stefanodemartini/RazorGauge/scheda_sensore/RazorSensor_BOM.csv

Rif | Valore | Footprint | Codice / note | LCSC
U1 | TSL1401CL | TSL1401CL_ams_CL | ams TSL1401CL (128x1, package CL, MSL 5a da datasheet) | C2802316
C1 | 100nF | C_0603_1608Metric | CC0603KRX7R9BB104 50V | C14663
C2 | 10uF | C_0805_2012Metric | CL21A106KAYNNNE 25V | C15850
R1 | 100 | R_0603_1608Metric | 0603WAF1000T5E | C22775
R2 | 100 | R_0603_1608Metric | 0603WAF1000T5E | C22775
R3 | 330 | R_0603_1608Metric | 0603WAF3300T5E | C23138
U2 | LMV321 | SOT-23-5 | TI LMV321IDBVR (rail-to-rail out, 1 MHz) | C7972
C4 | 100nF | C_0603_1608Metric | CC0603KRX7R9BB104 50V | C14663
R4 | 10k | R_0603_1608Metric | 0603WAF1002T5E | C25804
R5 | 100k | R_0603_1608Metric | 0603WAF1003T5E | C25803
R6 | 4.7k | R_0603_1608Metric | 0603WAF4701T5E | C23162
C3 | 100nF | C_0603_1608Metric | CC0603KRX7R9BB104 50V | C14663
R7 | 4.7k | R_0603_1608Metric | 0603WAF4701T5E | C23162
R8 | 10k | R_0603_1608Metric | 0603WAF1002T5E | C25804
R9 | 10k | R_0603_1608Metric | 0603WAF1002T5E | C25804
R10 | 100 | R_0603_1608Metric | 0603WAF1000T5E | C22775
J1 | GH 6p | JST_GH_SM06B-GHS-TB_1x06-1MP_P1.25mm_Horizontal | JST SM06B-GHS-TB(LF)(SN) - cavo: 1 3V3 / 2 GND / 3 SI / 4 CLK / 5 AO / 6 calza (= J5 pin 1-5, 8) | C133065
