stefanodemartini/RazorGauge/scheda_smd/RazorBoard_SMD_BOM.csv

Rif | Valore | Footprint | Codice / note | LCSC | Montaggio
J1 | 24V IN | TerminalBlock_Phoenix_MKDS-1,5-2-5.08_1x02_P5.08mm_Horizontal |  |  | a mano (THT)
F1 | PTC 0.5A 30V | Fuse_1812_4532Metric | SMD1812P050TF/30 (hold 0.5A, trip 1A) | C12559 | fabbrica (SMT)
D1 | SS34 | D_SMA | SS34 3A 40V | C8678 | fabbrica (SMT)
D2 | SMBJ33CA | D_SMB | SMBJ33CA | C492017 | fabbrica (SMT)
C1 | 10uF 50V | C_1206_3216Metric | CL31A106KBHNNNE | C13585 | fabbrica (SMT)
C2 | 100nF | C_0603_1608Metric | CC0603KRX7R9BB104 50V | C14663 | fabbrica (SMT)
U1 | TSR 2-2450 | Converter_DCDC_TRACO_TSR-1_THT | Traco TSR 2-2450 (5V 2A) |  | a mano (THT)
C3 | 10uF 25V | C_0805_2012Metric | CL21A106KAYNNNE | C15850 | fabbrica (SMT)
J2 | 5V EXT | TerminalBlock_Phoenix_MKDS-1,5-2-5.08_1x02_P5.08mm_Horizontal |  |  | a mano (THT)
JP1 | SEL 5V | PinHeader_1x03_P2.54mm_Vertical | Header 3 pin + jumper (1-2 = convertitore interno, 2-3 = 5V esterno) |  | a mano (THT)
C4 | 10uF 25V | C_0805_2012Metric | CL21A106KAYNNNE | C15850 | fabbrica (SMT)
C17 | 10uF 25V | C_0805_2012Metric | CL21A106KAYNNNE | C15850 | fabbrica (SMT)
C5 | 100nF | C_0603_1608Metric | CC0603KRX7R9BB104 50V | C14663 | fabbrica (SMT)
R1 | 1k | R_0603_1608Metric | 0603WAF1001T5E | C21190 | fabbrica (SMT)
D3 | PWR verde | LED_0603_1608Metric | KT-0603G | C12624 | fabbrica (SMT)
D4 | B5819W | D_SOD-123 | B5819W SL (blocca ritorno da USB master) | C8598 | fabbrica (SMT)
D5 | B5819W | D_SOD-123 | B5819W SL (blocca ritorno da USB slave) | C8598 | fabbrica (SMT)
A1 | MASTER ESP32 DevKit V1 30p | ESP32_DevKitV1_30p_W25.4 | 2x zoccolo femmina 1x15 passo 2.54, file a 25.4 mm |  | a mano (THT)
A2 | SLAVE ESP32 DevKit V1 30p | ESP32_DevKitV1_30p_W25.4 | 2x zoccolo femmina 1x15 passo 2.54, file a 25.4 mm |  | a mano (THT)
R10 | 470 | R_0603_1608Metric | 0603WAF4700T5E | C23179 | fabbrica (SMT)
R11 | 470 | R_0603_1608Metric | 0603WAF4700T5E | C23179 | fabbrica (SMT)
J7 | UART DEBUG | PinHeader_1x03_P2.54mm_Vertical |  |  | a mano (THT)
J4 | ENCODER | TerminalBlock_Phoenix_MKDS-1,5-5-5.08_1x05_P5.08mm_Horizontal | rosso +5V, nero GND, verde A, bianco B, calza GND |  | a mano (THT)
R30 | 4.7k | R_0603_1608Metric | 0603WAF4701T5E | C23162 | fabbrica (SMT)
R31 | 4.7k | R_0603_1608Metric | 0603WAF4701T5E | C23162 | fabbrica (SMT)
R32 | 1k | R_0603_1608Metric | 0603WAF1001T5E | C21190 | fabbrica (SMT)
R33 | 1k | R_0603_1608Metric | 0603WAF1001T5E | C21190 | fabbrica (SMT)
C7 | 10nF | C_0603_1608Metric | 0603B103K500NT 50V | C57112 | fabbrica (SMT)
C8 | 10nF | C_0603_1608Metric | 0603B103K500NT 50V | C57112 | fabbrica (SMT)
U3 | 74HC14 | SOIC-14_3.9x8.7mm_P1.27mm | 74HC14D,653 (a 3.3V, doppia inversione) | C5605 | fabbrica (SMT)
C9 | 100nF | C_0603_1608Metric | CC0603KRX7R9BB104 50V | C14663 | fabbrica (SMT)
R20 | 10k | R_0603_1608Metric | 0603WAF1002T5E | C25804 | fabbrica (SMT)
R21 | 10k | R_0603_1608Metric | 0603WAF1002T5E | C25804 | fabbrica (SMT)
R22 | 10k | R_0603_1608Metric | 0603WAF1002T5E | C25804 | fabbrica (SMT)
U4 | 74HCT245 | SOIC-20W_7.5x12.8mm_P1.27mm | 74HCT245D,653 (ingressi TTL, uscite 5V) | C5979 | fabbrica (SMT)
C6 | 100nF | C_0603_1608Metric | CC0603KRX7R9BB104 50V | C14663 | fabbrica (SMT)
R23 | 100 | R_0603_1608Metric | 0603WAF1000T5E | C22775 | fabbrica (SMT)
R24 | 100 | R_0603_1608Metric | 0603WAF1000T5E | C22775 | fabbrica (SMT)
R25 | 100 | R_0603_1608Metric | 0603WAF1000T5E | C22775 | fabbrica (SMT)
R26 | 1k | R_0603_1608Metric | 0603WAF1001T5E | C21190 | fabbrica (SMT)
D6 | PUL giallo | LED_0603_1608Metric | KT-0603Y | C2287 | fabbrica (SMT)
R27 | 1k | R_0603_1608Metric | 0603WAF1001T5E | C21190 | fabbrica (SMT)
D7 | DIR giallo | LED_0603_1608Metric | KT-0603Y | C2287 | fabbrica (SMT)
R28 | 1k | R_0603_1608Metric | 0603WAF1001T5E | C21190 | fabbrica (SMT)
D8 | ENA rosso | LED_0603_1608Metric | KT-0603R | C2286 | fabbrica (SMT)
J3 | TB6600 | TerminalBlock_Phoenix_MKDS-1,5-5-5.08_1x05_P5.08mm_Horizontal | PUL->PUL+, DIR->DIR+, ENA->ENA+, GND->PUL-/DIR-/ENA-, +5V solo per anodo comune |  | a mano (THT)
J5 | RAZORGAUGE | TerminalBlock_Phoenix_MKDS-1,5-8-5.08_1x08_P5.08mm_Horizontal | cavo schermato max 50 cm, calza al pin 8 |  | a mano (THT)
R40 | 100 | R_0603_1608Metric | 0603WAF1000T5E | C22775 | fabbrica (SMT)
R41 | 100 | R_0603_1608Metric | 0603WAF1000T5E | C22775 | fabbrica (SMT)
R42 | 100 | R_0603_1608Metric | 0603WAF1000T5E | C22775 | fabbrica (SMT)
C10 | 1nF | C_0603_1608Metric | CL10B102KB8NNNC 50V | C1588 | fabbrica (SMT)
D9 | 1N4148W | D_SOD-123 | 1N4148W | C81598 | fabbrica (SMT)
D10 | 1N4148W | D_SOD-123 | 1N4148W | C81598 | fabbrica (SMT)
C11 | 10uF 25V | C_0805_2012Metric | CL21A106KAYNNNE | C15850 | fabbrica (SMT)
C12 | 100nF | C_0603_1608Metric | CC0603KRX7R9BB104 50V | C14663 | fabbrica (SMT)
JP2 | SEL LASER | PinHeader_1x03_P2.54mm_Vertical | Header 3 pin + jumper (1-2 = laser a 3.3V, 2-3 = laser a 5V) |  | a mano (THT)
R43 | 0 | R_0603_1608Metric | 0603WAF0000T5E | C21189 | fabbrica (SMT)
Q1 | 2N7002 | SOT-23 | 2N7002 (60V 115mA) | C8545 | fabbrica (SMT)
R44 | 100 | R_0603_1608Metric | 0603WAF1000T5E | C22775 | fabbrica (SMT)
R45 | 100k | R_0603_1608Metric | 0603WAF1003T5E | C25803 | fabbrica (SMT)
SW1 | SCAN | SW_PUSH_6mm |  |  | a mano (THT)
R52 | 10k | R_0603_1608Metric | 0603WAF1002T5E | C25804 | fabbrica (SMT)
R53 | 1k | R_0603_1608Metric | 0603WAF1001T5E | C21190 | fabbrica (SMT)
C14 | 100nF | C_0603_1608Metric | CC0603KRX7R9BB104 50V | C14663 | fabbrica (SMT)
SW2 | FAST_S | SW_PUSH_6mm |  |  | a mano (THT)
R54 | 10k | R_0603_1608Metric | 0603WAF1002T5E | C25804 | fabbrica (SMT)
R55 | 1k | R_0603_1608Metric | 0603WAF1001T5E | C21190 | fabbrica (SMT)
C15 | 100nF | C_0603_1608Metric | CC0603KRX7R9BB104 50V | C14663 | fabbrica (SMT)
SW3 | FAST_O | SW_PUSH_6mm |  |  | a mano (THT)
R56 | 10k | R_0603_1608Metric | 0603WAF1002T5E | C25804 | fabbrica (SMT)
R57 | 1k | R_0603_1608Metric | 0603WAF1001T5E | C21190 | fabbrica (SMT)
C16 | 100nF | C_0603_1608Metric | CC0603KRX7R9BB104 50V | C14663 | fabbrica (SMT)
SW4 | WIFI_RST | SW_PUSH_6mm |  |  | a mano (THT)
R50 | 10k | R_0603_1608Metric | 0603WAF1002T5E | C25804 | fabbrica (SMT)
R51 | 1k | R_0603_1608Metric | 0603WAF1001T5E | C21190 | fabbrica (SMT)
C13 | 100nF | C_0603_1608Metric | CC0603KRX7R9BB104 50V | C14663 | fabbrica (SMT)
J6 | PULSANTI | TerminalBlock_Phoenix_MKDS-1,5-5-5.08_1x05_P5.08mm_Horizontal |  |  | a mano (THT)
H1 | M3 | MountingHole_3.2mm_M3_Pad |  |  | a mano (THT)
H2 | M3 | MountingHole_3.2mm_M3_Pad |  |  | a mano (THT)
H3 | M3 | MountingHole_3.2mm_M3_Pad |  |  | a mano (THT)
H4 | M3 | MountingHole_3.2mm_M3_Pad |  |  | a mano (THT)
