stefanodemartini/RazorGauge/(list of files, cad)

Other CAD files:
strumenti/RazorGauge_v1_pesante.scad
cad/RazorGauge.scad
cad/RazorGauge_v1.scad
