stefanodemartini/RazorGauge/strumenti/audit/esito_verifica_finale.txt

assembly gia ricostruito
######## audit/A_static.py
OK  Interferenze statiche: 26 coppie vicine controllate tra 24 parti: nessuna
exit 0
######## audit/B_optics.py
OK  Sede L1: Ø 12.77 (lente Ø12.47 → gioco 0.30)
OK  Sede L1: altezza 3.42 (lente 3.11 → gioco 0.31)
OK  L1 si infila dal fronte fino in sede
OK  Sede laser: Ø 4.30 (laser Ø4 → gioco 0.30)
OK  Battuta laser a z 120.20 (faccia laser 120.2), foro fascio sotto Ø3
OK  Laser Ø4 si infila dall'alto (foro Ø5 nel tappo superiore)
OK  Fascio Ø13 (chip→L2) e cono L2→L1 liberi da pezzo e coperchio
OK  Foro libero del carrello ≥ Ø14 (fascio utile L2)
OK  Coperchio ↔ colonna: nessuna compenetrazione (costola nella scanalatura del blocco L1)
exit 0
######## audit/C_carriage.py
carrello bounds [[10.42 82.91  9.75]
 [34.02 94.91 33.35]]
vite [[30.22 89.96 12.3 ]
 [39.22 95.46 17.8 ]]
OK  carrello dY -5: ∩pezzo 0.000 ∩coperchio 0.000 vite∩coperchio 0.000 vite∩pezzo 0.000
OK  carrello dY -4: ∩pezzo 0.000 ∩coperchio 0.000 vite∩coperchio 0.000 vite∩pezzo 0.000
OK  carrello dY -2: ∩pezzo 0.000 ∩coperchio 0.000 vite∩coperchio 0.000 vite∩pezzo 0.000
OK  carrello dY +0: ∩pezzo 0.000 ∩coperchio 0.000 vite∩coperchio 0.000 vite∩pezzo 0.000
OK  carrello dY +2: ∩pezzo 0.000 ∩coperchio 0.000 vite∩coperchio 0.000 vite∩pezzo 0.000
OK  carrello dY +4: ∩pezzo 0.000 ∩coperchio 0.000 vite∩coperchio 0.000 vite∩pezzo 0.000
OK  carrello dY +6: ∩pezzo 0.000 ∩coperchio 0.000 vite∩coperchio -0.000 vite∩pezzo 0.000
gioco min a fine corsa bassa 0.00
a -5.3 ∩pezzo 14.499 (battuta)
exit 0
######## chk_forks2.py
c= -6.45 d=-1.0  guida rettangolare in presa 1.9 mm  libera
c= -6.45 d= 0.5  guida rettangolare in presa 3.4 mm  libera
c= -6.45 d= 2.0  guida rettangolare in presa 4.9 mm  libera
c= -6.45 d= 3.0  guida rettangolare in presa 5.9 mm  libera
c= -6.45 d= 4.0  guida rettangolare in presa 6.9 mm  libera
c= -6.45 d= 4.5  guida rettangolare in presa 7.4 mm  libera
c= -6.45 d= 5.0  guida rettangolare in presa 7.9 mm  libera
c= -6.45 d= 5.5  guida rettangolare in presa 8.4 mm  bullone/dado↔pezzo_unico DENTRO
exit 137
######## /tmp/c2d.py
scheda_sensore (0, np.float64(0.49), [12.2, 64.61, 9.3], [12.2, 65.1, 9.3])
scheda_sensore (0.5, np.float64(0.49), [12.7, 64.61, 9.3], [12.7, 65.1, 9.3])
scheda_sensore (1, np.float64(0.49), [13.2, 64.61, 9.3], [13.2, 65.1, 9.3])
scheda_sensore (2, np.float64(0.49), [14.2, 64.61, 9.3], [14.2, 65.1, 9.3])
scheda_sensore (3, np.float64(0.49), [15.2, 64.61, 9.3], [15.2, 65.1, 9.3])
scheda_sensore (5, np.float64(0.49), [17.2, 64.61, 9.3], [17.2, 65.1, 9.3])
scheda_sensore (8, np.float64(0.49), [20.2, 64.61, 9.3], [20.2, 65.1, 9.3])
scheda_sensore (12, np.float64(0.49), [24.2, 64.61, 9.3], [24.2, 65.1, 9.3])
scheda_sensore (20, np.float64(2.0), [40.71, 60.91, 7.06], [40.71, 58.91, 7.06])
scheda_sensore (30, np.float64(2.0), [40.29, 60.91, 7.53], [40.29, 58.91, 7.53])
scheda_sensore (45, np.float64(12.8), [54.63, 61.12, 7.89], [42.02, 58.91, 7.65])
slitta_sensore (0, np.float64(0.0), [41.39, 58.91, 7.49], [41.39, 58.91, 7.49])
slitta_sensore (0.5, np.float64(0.0), [41.89, 58.91, 7.49], [41.89, 58.91, 7.49])
slitta_sensore (1, np.float64(0.0), [35.73, 58.91, 6.65], [35.73, 58.91, 6.65])
slitta_sensore (2, np.float64(0.0), [40.49, 58.91, 3.32], [40.49, 58.91, 3.32])
slitta_sensore (3, np.float64(0.0), [36.79, 58.91, 7.39], [36.79, 58.91, 7.39])
slitta_sensore (5, np.float64(0.0), [39.73, 58.91, 6.65], [39.73, 58.91, 6.65])
slitta_sensore (8, np.float64(0.0), [39.52, 58.91, 7.26], [39.52, 58.91, 7.26])
slitta_sensore (12, np.float64(0.0), [36.72, 58.91, 7.17], [36.72, 58.91, 7.17])
slitta_sensore (20, np.float64(0.0), [38.61, 58.91, 7.24], [38.61, 58.91, 7.24])
slitta_sensore (30, np.float64(0.0), [39.76, 58.91, 7.59], [39.76, 58.91, 7.59])
slitta_sensore (45, np.float64(8.68), [49.92, 59.85, 11.11], [42.02, 58.91, 7.65])
exit 0
######## c2b.py
OK  scheda_sensore in estrazione 0-45 mm: gioco min 0.49
!!  slitta_sensore in estrazione 0-45 mm: gioco min 0.00
OK  fascetta_2_5mm in estrazione 0-45 mm: gioco min 0.50
exit 0
######## c4.py
vite slitta dall'alto: libero
vite carrello dal davanti: libero
vite coperchio 104.41 6.8 libero
vite coperchio 104.41 36.3 libero
vite coperchio 139.41 6.8 libero
vite coperchio 139.41 36.3 libero
vite coperchio 197.41 6.8 libero
vite coperchio 197.41 36.3 libero
fissaggio 133 -6.1 libero
fissaggio 133 49.2 libero
fissaggio 169.5 -6.1 libero
fissaggio 169.5 49.2 libero
vite tappo 10.6 -6.45 libero
vite tappo 33.4 -6.45 libero
estrazione forcella+stelo dall'alto -6.45 libero
vite tappo 10.6 49.55 libero
vite tappo 33.4 49.55 libero
estrazione forcella+stelo dall'alto 49.55 libero
exit 0
######## c5.py
interasse laser -> ruota 28.00  laser -> rullo inferiore 28.00  laser -> spintore lato misura 28.00
linea Ø0.5 Z -30..76 ∩ pezzo 0.0000
linea Ø3.0 Z -30..76 ∩ pezzo 0.0000
cima rullo inferiore Y 66.91 (fondo linea 66.91), Z centro -6.45
materiale del braccio sull'asse del perno (X): [np.float64(0.1), np.float64(7.2)]
rullo inferiore ↔ pezzo (braccio) gioco 0.00
J lato rullo Z 1.60-13.60
J ↔ rullo inferiore 2.56 ↔ scheda 0.49
J ↔ rullo spintore (tutta la corsa) 0.78
exit 0
######## chk_j.py
volume J 1186.6
J ↔ rullo spintore (Z -6.45): gioco min su tutta la corsa 2.63
J ↔ forcella (Z -6.45): gioco min su tutta la corsa 5.35
J ↔ testa/dado (Z -6.45): gioco min su tutta la corsa 6.72
J ↔ rullo spintore (Z 49.55): gioco min su tutta la corsa 4.70
J ↔ forcella (Z 49.55): gioco min su tutta la corsa 7.38
J ↔ testa/dado (Z 49.55): gioco min su tutta la corsa 7.02
J ↔ ruota 0.78
J ↔ rullo inferiore 4.15
J ↔ scheda durante l'estrazione 0.49
linea Ø0.5 ∩ J 0.0
linea Ø3.0 ∩ J 0.0
exit 0
######## c1.py
scheda_sensore ↔ ruota 0.62
slitta_sensore ↔ ruota 1.02
fascetta_2_5mm ↔ ruota 7.1
pezzo (J, piastra) ↔ ruota 0.79
filo 1 ↔ pezzo 1.21 ↔ ruota 6.2
filo 2 ↔ pezzo 1.48 ↔ ruota 5.59
filo 3 ↔ pezzo 0.7 ↔ ruota 6.54
filo 4 ↔ pezzo 1.33 ↔ ruota 3.92
filo 5 ↔ pezzo 1.73 ↔ ruota 4.88
exit 0
######## ins2.py
Z -6.45: estrazione/inserimento DALL'ALTO (tappo tolto) per 44.4 mm: LIBERO
   tappo ∩ pezzo 0.0000
   tappo ∩ forcella (d=-1) 0.0000
   tappo ∩ forcella (d=0) 0.0000
   tappo ∩ forcella (d=3) 0.0000
   tappo ∩ forcella (d=5) 0.0000
   foro stelo nel tappo libero sull'asse: True
   parete sede a dz -6.15: tappo la tocca? False
   parete sede a dz +6.15: tappo la tocca? False
   asse vite X 10.6: pezzo pieno da Y 103.19, tappo pieno? False
      foro nel pezzo da Y 103.39 a 111.8 -> profondita 8.4
   asse vite X 33.4: pezzo pieno da Y 103.19, tappo pieno? False
      foro nel pezzo da Y 103.39 a 111.8 -> profondita 8.4
Z 49.55: estrazione/inserimento DALL'ALTO (tappo tolto) per 44.4 mm: LIBERO
   tappo ∩ pezzo 0.0000
   tappo ∩ forcella (d=-1) 0.0000
   tappo ∩ forcella (d=0) 0.0000
   tappo ∩ forcella (d=3) 0.0000
   tappo ∩ forcella (d=5) 0.0000
   foro stelo nel tappo libero sull'asse: True
   parete sede a dz -6.15: tappo la tocca? False
   parete sede a dz +6.15: tappo la tocca? False
   asse vite X 10.6: pezzo pieno da Y 103.19, tappo pieno? False
      foro nel pezzo da Y 103.39 a 111.8 -> profondita 8.4
   asse vite X 33.4: pezzo pieno da Y 103.19, tappo pieno? False
      foro nel pezzo da Y 103.39 a 111.8 -> profondita 8.4
exit 0
######## tray_fix.py
== linguetta posteriore nella sede ==
gioco sotto 0.1  sopra 0.25
gioco lati 0.25 0.25
gioco in fondo 0.1
linguetta guidata sopra e sotto da tx -17.3 a -13.4 -> presa 4.0 mm (linguetta lunga 4.8)
== appoggio anteriore e vite ==
sotto la linguetta anteriore c'e la colonnina in 154 punti su 154 della linguetta
cima colonnina a tz -5.75 (faccia inferiore slitta -5.50)
foro colonnina Ø 2.50, fondo a tz -14.51 -> lunghezza filettabile 9.0 mm
parete minima attorno al foro nella colonnina 1.50 mm
materiale minimo attorno al foro nella linguetta 1.05 mm
foro linguetta Ø 3.42
cima colonnina tz -5.500 (faccia inferiore slitta -5.500)
fondo sede posteriore tz -5.600
trave: sezione 2.5 x 5 mm, lunga 32.4 mm dalla piastra alla colonnina
exit 0
######## audit/F_holes.py
OK  fissaggio piastra (52.0, 18.67) nuovo            Ø nominale 3.30  misurato 3.31 (min 3.30)
OK  foro originale Ø3.3 (3.00, 18.70)                Ø nominale 3.30  misurato 3.31 (min 3.30)
OK  foro originale Ø3.3 (3.00, 80.40)                Ø nominale 3.30  misurato 3.31 (min 3.30)
OK  foro originale Ø3.3 (57.97, 80.44)               Ø nominale 3.30  misurato 3.31 (min 3.30)
OK  foro originale Ø3.3 (49.01, 49.53)               Ø nominale 3.30  misurato 3.31 (min 3.30)
OK  foro originale Ø3.3 (47.98, 42.03)               Ø nominale 3.30  misurato 3.31 (min 3.30)
OK  foro originale Ø3.3 (35.00, 64.53)               Ø nominale 3.30  misurato 3.31 (min 3.30)
OK  foro originale Ø3.3 (28.02, 61.69)               Ø nominale 3.30  misurato 3.31 (min 3.30)
OK  foro originale Ø3.3 (28.02, 37.42)               Ø nominale 3.30  misurato 3.31 (min 3.30)
OK  foro originale Ø3.3 (22.03, 42.06)               Ø nominale 3.30  misurato 3.31 (min 3.30)
OK  foro encoder Ø22                                 Ø nominale 22.00  misurato 22.00 (min 22.00)
OK  sede corpo encoder Ø53                           Ø nominale 53.00  misurato 53.00 (min 53.00)
OK  fondo sede encoder a X 4.24 -> fondo 2.98 mm (orig 3.0)
OK  fissaggio assieme (133.0, -6.1)                  Ø nominale 3.40  misurato 3.41 (min 3.38)
OK  fissaggio assieme (133.0, 49.2)                  Ø nominale 3.40  misurato 3.41 (min 3.38)
OK  fissaggio assieme (169.5, -6.1)                  Ø nominale 3.40  misurato 3.41 (min 3.38)
OK  fissaggio assieme (169.5, 49.2)                  Ø nominale 3.40  misurato 3.41 (min 3.38)
OK  maschio M3 tappo X 10.6 Z -6.45                  Ø nominale 2.50  misurato 2.49 (min 2.49)
OK     profondità 8.56 mm (vite M3x12: 6 in presa)
OK  maschio M3 tappo X 33.4 Z -6.45                  Ø nominale 2.50  misurato 2.49 (min 2.49)
OK     profondità 8.56 mm (vite M3x12: 6 in presa)
OK  sede forcella (rettangolare) - larghezza minima  Ø nominale 12.60  misurato 16.92 (min 12.64)
OK  maschio M3 tappo X 10.6 Z 49.55                  Ø nominale 2.50  misurato 2.49 (min 2.49)
OK     profondità 8.56 mm (vite M3x12: 6 in presa)
OK  maschio M3 tappo X 33.4 Z 49.55                  Ø nominale 2.50  misurato 2.49 (min 2.49)
OK     profondità 8.56 mm (vite M3x12: 6 in presa)
OK  sede forcella (rettangolare) - larghezza minima  Ø nominale 12.60  misurato 16.92 (min 12.60)
OK  maschio M3 colonnina slitta                      Ø nominale 2.50  misurato 2.50 (min 2.50)
OK  maschio M3 coperchio Y 104.4 Z 36.3              Ø nominale 2.50  misurato 2.51 (min 2.50)
OK  maschio M3 coperchio Y 104.4 Z 6.8               Ø nominale 2.50  misurato 2.51 (min 2.50)
OK  maschio M3 coperchio Y 139.4 Z 36.3              Ø nominale 2.50  misurato 2.51 (min 2.50)
OK  maschio M3 coperchio Y 139.4 Z 6.8               Ø nominale 2.50  misurato 2.51 (min 2.50)
OK  maschio M3 coperchio Y 197.6 Z 36.3              Ø nominale 2.50  misurato 2.51 (min 2.50)
OK  maschio M3 coperchio Y 197.6 Z 6.8               Ø nominale 2.50  misurato 2.51 (min 2.50)

exit 0
######## audit_gaps_P
profiler.stl watertight True corpi 1 vol 107.23 cm3
SPESSORE < 1.0 mm: 75 punti in 25 zone
   ~(28, 196, 22)  min 0.12  n 1
   ~(28, 196, 20)  min 0.26  n 1
   ~(14, 196, 36)  min 0.34  n 2
   ~(18, 196, 16)  min 0.35  n 4
   ~(22, 66, 60)  min 0.43  n 2
   ~(16, 196, 6)  min 0.54  n 2
   ~(24, 66, 62)  min 0.66  n 2
   ~(22, 66, 62)  min 0.67  n 4
   ~(20, 196, 28)  min 0.67  n 1
   ~(14, 194, 36)  min 0.70  n 1
   ~(22, 66, 6)  min 0.81  n 5
   ~(22, 66, 32)  min 0.81  n 6
   ~(22, 66, 34)  min 0.81  n 4
   ~(22, 66, 10)  min 0.81  n 6
   ~(22, 66, 2)  min 0.81  n 8
   ~(22, 66, 8)  min 0.81  n 8
   ~(22, 66, 30)  min 0.82  n 5
   ~(22, 66, 4)  min 0.82  n 3
   ~(22, 66, 36)  min 0.82  n 4
   ~(22, 66, 12)  min 0.83  n 1
   ~(14, 196, 10)  min 0.88  n 1
   ~(18, 198, 16)  min 0.89  n 1
   ~(0, 2, 80)  min 0.90  n 1
   ~(8, 4, 82)  min 0.98  n 1
   ~(24, 66, 30)  min 0.99  n 1
FESSURA < 0.5 mm: 5 punti in 5 zone
   ~(6, 48, 72)  min 0.19  n 1
   ~(6, 22, 72)  min 0.21  n 1
   ~(6, 48, 28)  min 0.27  n 1
   ~(32, 102, 56)  min 0.29  n 1
   ~(4, 48, 72)  min 0.47  n 1
tappo_blocco_guida_stampa.stl watertight True corpi 1 vol 2.82 cm3
SPESSORE < 1.0 mm: 0 punti in 0 zone
FESSURA < 0.5 mm: 0 punti in 0 zone
lid.stl watertight True corpi 1 vol 8.19 cm3
SPESSORE < 1.0 mm: 192 punti in 35 zone
   ~(-74, 2, -0)  min 0.03  n 10
   ~(-60, -2, -0)  min 0.03  n 6
   ~(-84, 0, -0)  min 0.05  n 9
   ~(-50, 2, -0)  min 0.07  n 3
   ~(-70, 2, -0)  min 0.07  n 3
   ~(-50, -2, -0)  min 0.10  n 4
   ~(-42, -0, -0)  min 0.12  n 1
   ~(-80, -2, -0)  min 0.15  n 4
   ~(-48, 2, -0)  min 0.17  n 6
   ~(-46, 2, -0)  min 0.19  n 3
   ~(-80, 2, -0)  min 0.34  n 4
   ~(-70, -0, -0)  min 0.36  n 5
   ~(-82, 0, -0)  min 0.39  n 8
   ~(-50, 0, -0)  min 0.40  n 1
   ~(-68, -0, -0)  min 0.49  n 8
   ~(-78, 2, -0)  min 0.49  n 9
   ~(-62, -2, -0)  min 0.49  n 2
   ~(-46, -2, -0)  min 0.50  n 4
   ~(-46, -0, -0)  min 0.51  n 9
   ~(-68, -2, -0)  min 0.58  n 2
   ~(-72, 2, -0)  min 0.60  n 2
   ~(-66, 0, -0)  min 0.61  n 6
   ~(-44, 2, -0)  min 0.65  n 6
   ~(-44, -2, -0)  min 0.71  n 7
   ~(-44, -0, -0)  min 0.71  n 2
FESSURA < 0.5 mm: 17 punti in 8 zone
   ~(-44, 2, -0)  min 0.09  n 5
   ~(-72, 2, -0)  min 0.13  n 1
   ~(-74, 2, -0)  min 0.40  n 3
   ~(-60, -2, -0)  min 0.42  n 3
   ~(-68, -2, -0)  min 0.45  n 1
   ~(-70, 0, -0)  min 0.47  n 2
   ~(-46, 0, -0)  min 0.47  n 1
   ~(-70, 2, -0)  min 0.48  n 1
carriage.stl watertight True corpi 1 vol 3.85 cm3
SPESSORE < 1.0 mm: 162 punti in 8 zone
   ~(8, 6, 6)  min 0.95  n 29
   ~(12, 6, 6)  min 0.95  n 12
   ~(6, 6, 6)  min 0.95  n 11
   ~(10, 6, 6)  min 0.95  n 29
   ~(10, 6, 2)  min 0.95  n 26
   ~(6, 6, 2)  min 0.95  n 10
   ~(12, 6, 2)  min 0.95  n 11
   ~(8, 6, 2)  min 0.95  n 34
FESSURA < 0.5 mm: 0 punti in 0 zone
exit 0
DONE
