stefanodemartini/RazorGauge/(list of files, drawings)

Other design files:
scheda/script/RazorBoard.dsn
