stefanodemartini/RazorGauge/scheda_sensore/RazorSensor.kicad_pcb

## KiCad design scheda_sensore/RazorSensor.kicad_pcb (2026-10-29)

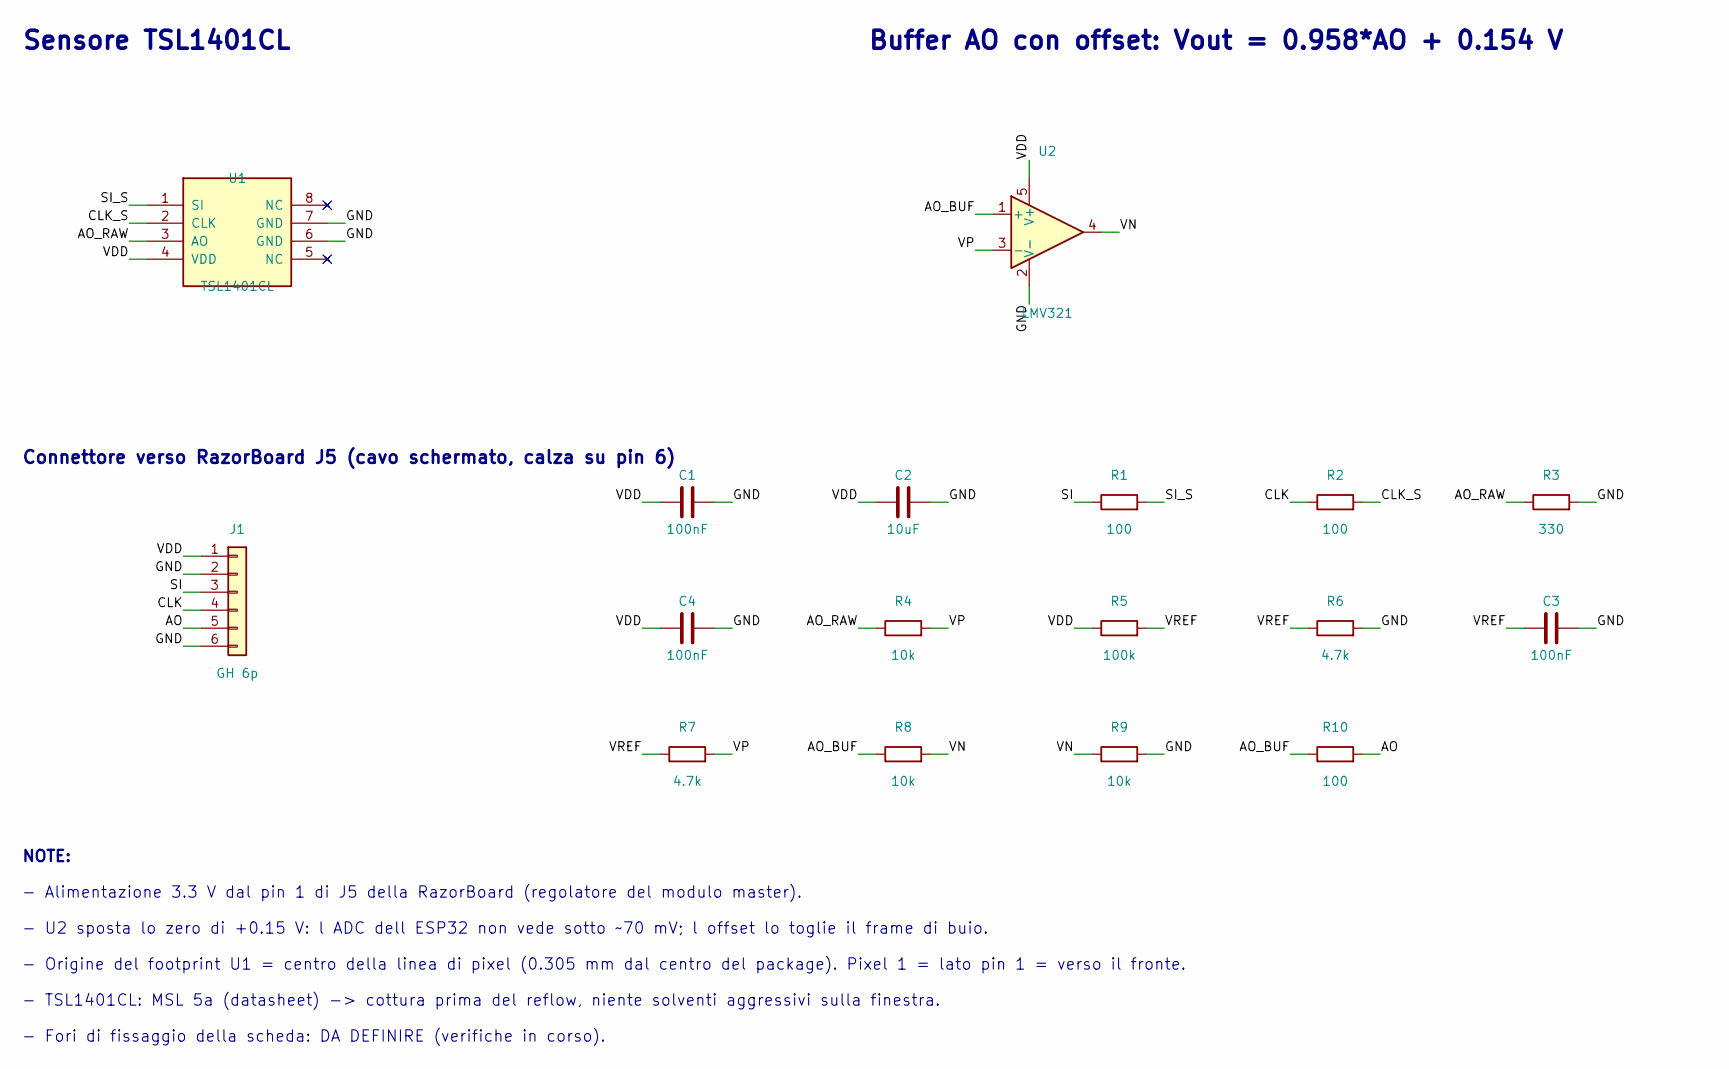
[picture p1: schematic RazorSensor.kicad_sch, RazorGauge - scheda sensore TSL1401CL]

Parts:
C1, C3, C4: 100nF; C_0603_1608Metric; MPN CC0603KRX7R9BB104 50V; LCSC C14663
C2: 10uF; C_0805_2012Metric; MPN CL21A106KAYNNNE 25V; LCSC C15850
J1: GH 6p; JST_GH_SM06B-GHS-TB_1x06-1MP_P1.25mm_Horizontal; MPN JST SM06B-GHS-TB(LF)(SN) - cavo: 1 3V3 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; LCSC C133065
R1, R2, R10: 100; R_0603_1608Metric; MPN 0603WAF1000T5E; LCSC C22775
R3: 330; R_0603_1608Metric; MPN 0603WAF3300T5E; LCSC C23138
R4, R8, R9: 10k; R_0603_1608Metric; MPN 0603WAF1002T5E; LCSC C25804
R5: 100k; R_0603_1608Metric; MPN 0603WAF1003T5E; LCSC C25803
R6, R7: 4.7k; R_0603_1608Metric; MPN 0603WAF4701T5E; LCSC C23162
U1: TSL1401CL; TSL1401CL_ams_CL; MPN ams TSL1401CL (128x1, package CL, MSL 5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; LCSC C2802316
U2: LMV321; SOT-23-5; MPN TI LMV321IDBVR (rail-to-rail out, 1 MHz); LCSC C7972

Connections:
AO: J1.5, R10.2
AO_BUF: R8.1, R10.1, U2.1 (+)
AO_RAW: R3.1, R4.1, U1.3 (AO)
CLK: J1.4, R2.1
CLK_S: R2.2, U1.2 (CLK)
GND: C1.2, C2.2, C3.2, C4.2, J1.2, J1.6, R3.2, R6.2, R9.2, U1.6 (GND), U1.7 (GND), U2.2 (V-)
SI: J1.3, R1.1
SI_S: R1.2, U1.1 (SI)
VDD: C1.1, C2.1, C4.1, J1.1, R5.1, U1.4 (VDD), U2.5 (V+)
VN: R8.2, R9.1, U2.4
VP: R4.2, R7.2, U2.3 (-)
VREF: C3.1, R5.2, R6.1, R7.1

Notes on the sheet:
Sensore TSL1401CL
Connettore verso RazorBoard J5 (cavo schermato, calza su pin 6)
Buffer AO con offset: Vout = 0.958*AO + 0.154 V
NOTE:
- Alimentazione 3.3 V dal pin 1 di J5 della RazorBoard (regolatore del modulo master).
- U2 sposta lo zero di +0.15 V: l ADC dell ESP32 non vede sotto ~70 mV; l offset lo toglie il frame di buio.
- Origine del footprint U1 = centro della linea di pixel (0.305 mm dal centro del package). Pixel 1 = lato pin 1 = verso il fronte.
- TSL1401CL: MSL 5a (datasheet) -> cottura prima del reflow, niente solventi aggressivi sulla finestra.
- Fori di fissaggio della scheda: DA DEFINIRE (verifiche in corso).

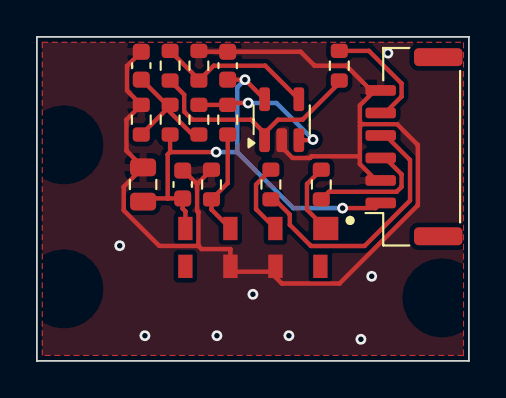
[picture p2: board RazorSensor.kicad_pcb from above]

Board: 2 copper layers, 24.0 x 18.0 mm, 17 parts (0 on the bottom side), 12 nets.
