stefanodemartini/RazorGauge/scheda_smd/RazorBoard.kicad_pcb

## KiCad design scheda_smd/RazorBoard.kicad_pcb (2026-10-19)

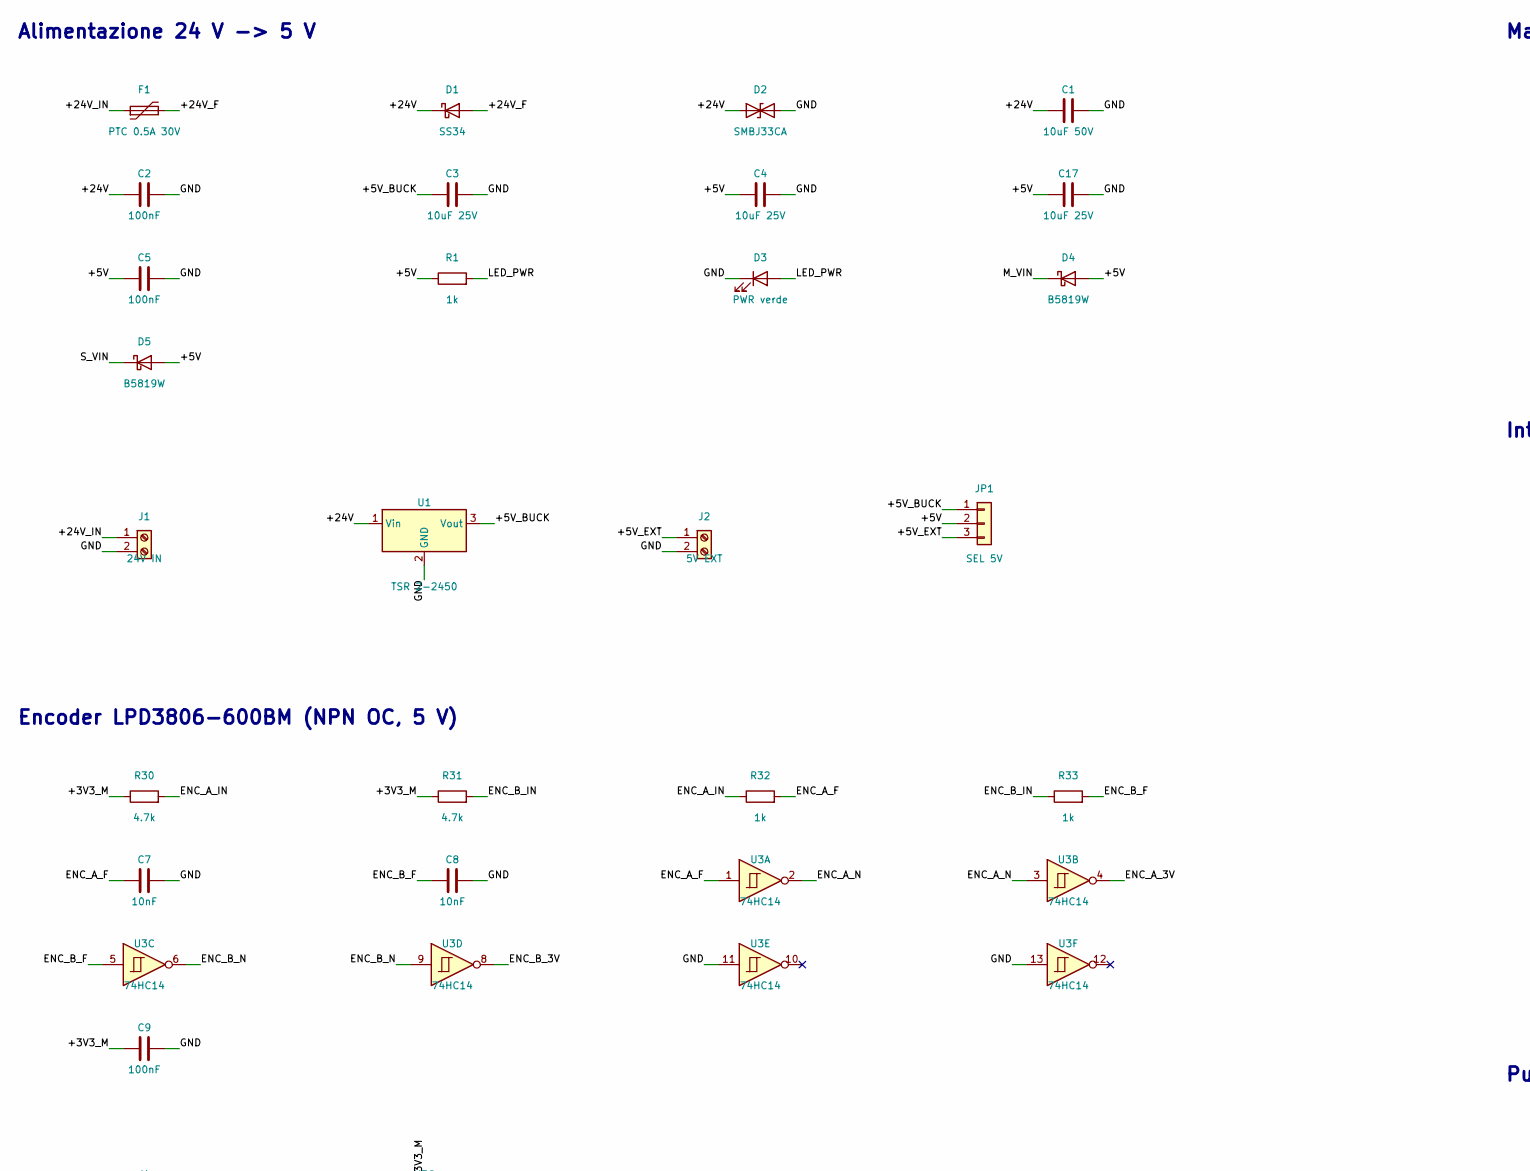
[picture p3: schematic RazorBoard.kicad_sch, RazorBoard SMD - scheda controller RazorGauge + motore, part in row 1, column 1]

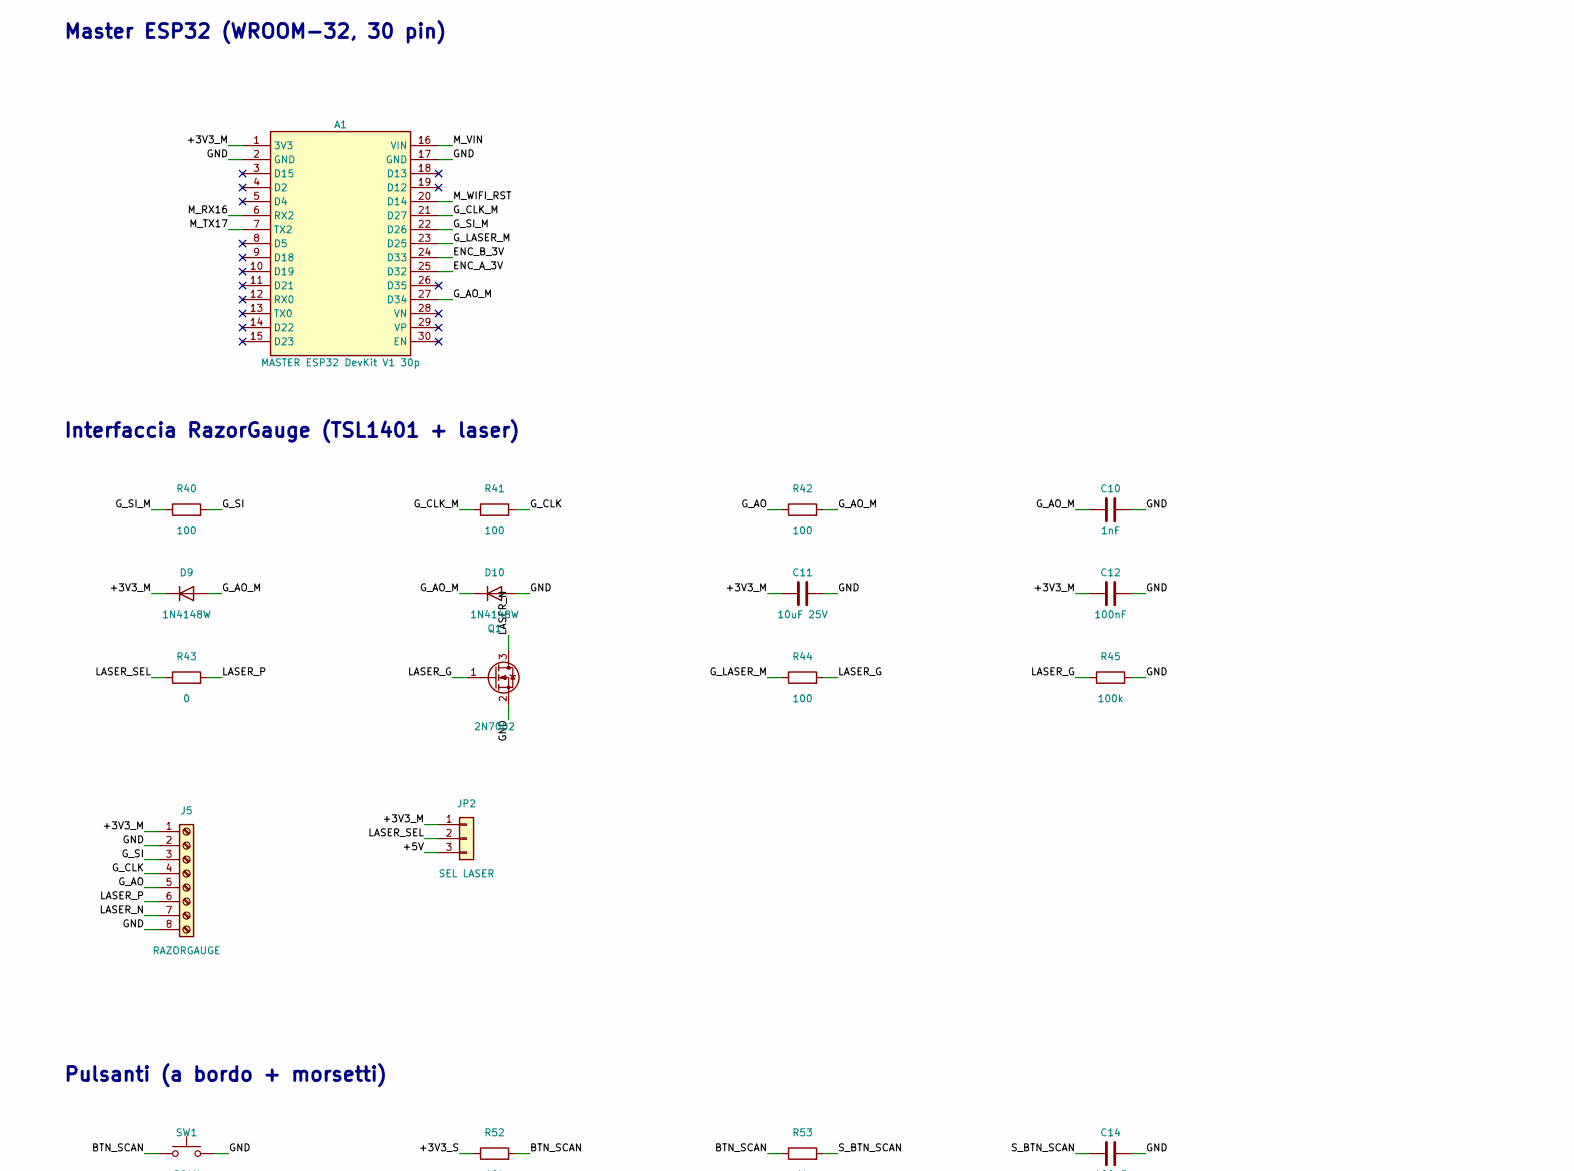
[picture p4: schematic RazorBoard.kicad_sch, RazorBoard SMD - scheda controller RazorGauge + motore, part in row 1, column 2]

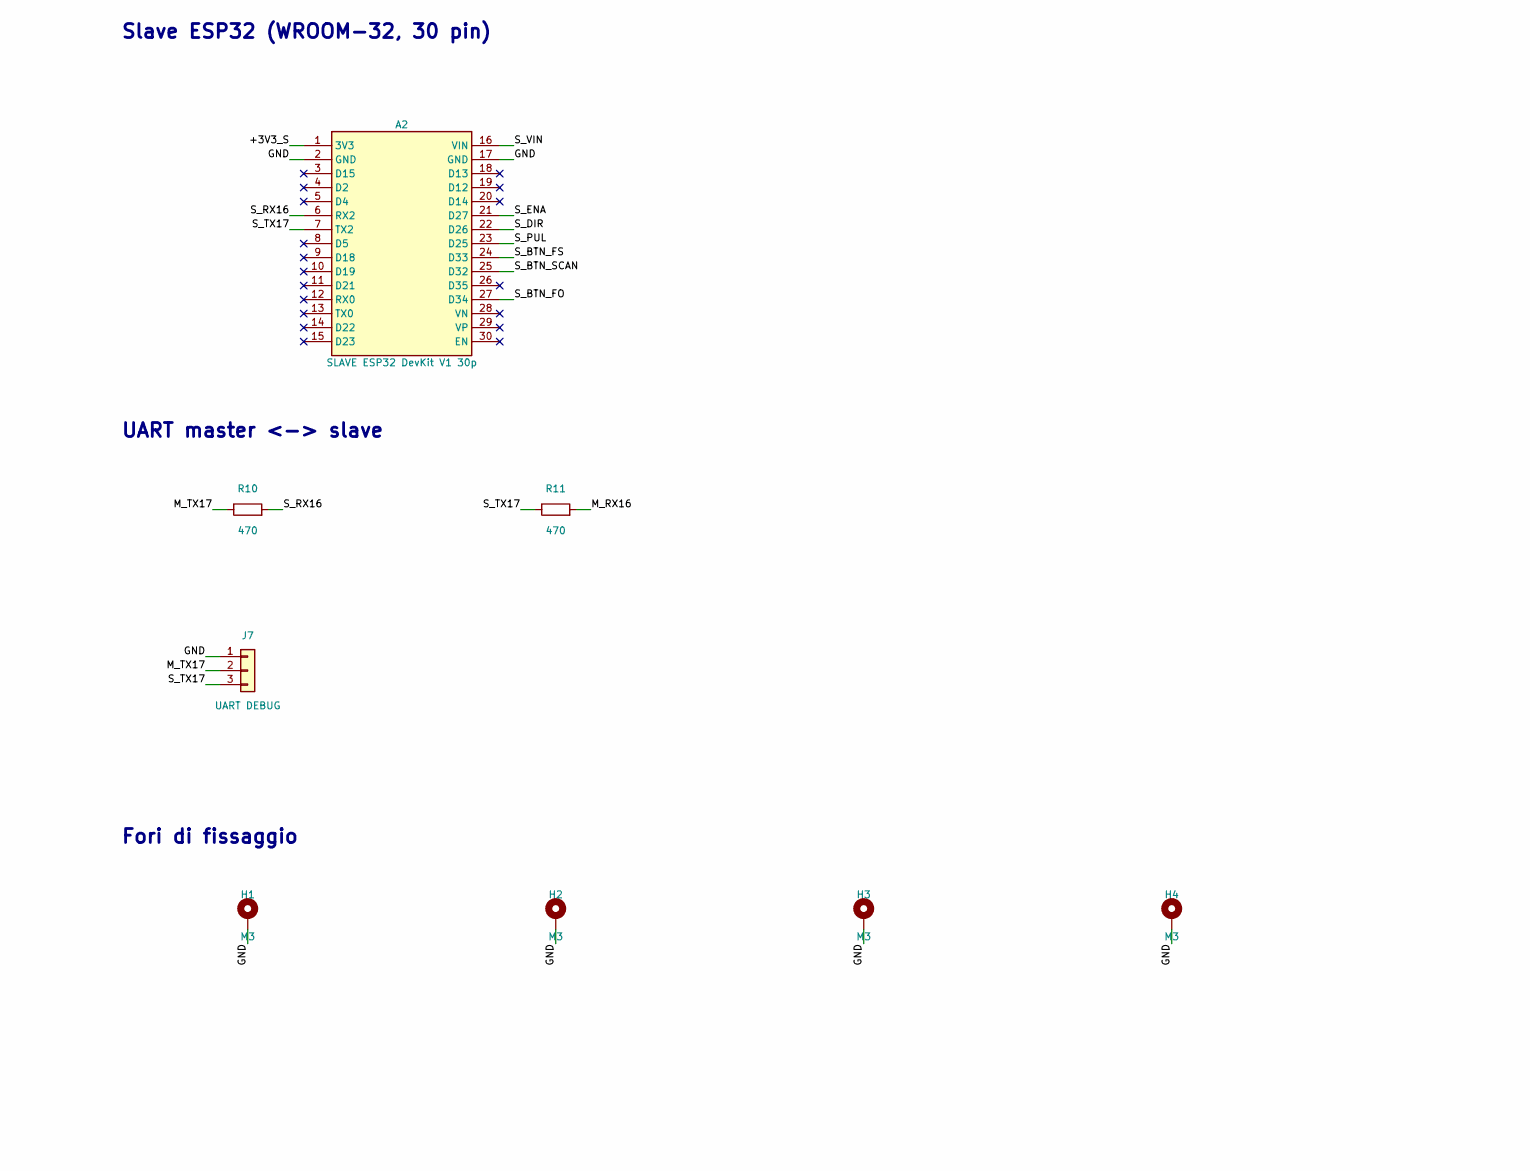
[picture p5: schematic RazorBoard.kicad_sch, RazorBoard SMD - scheda controller RazorGauge + motore, part in row 1, column 3]

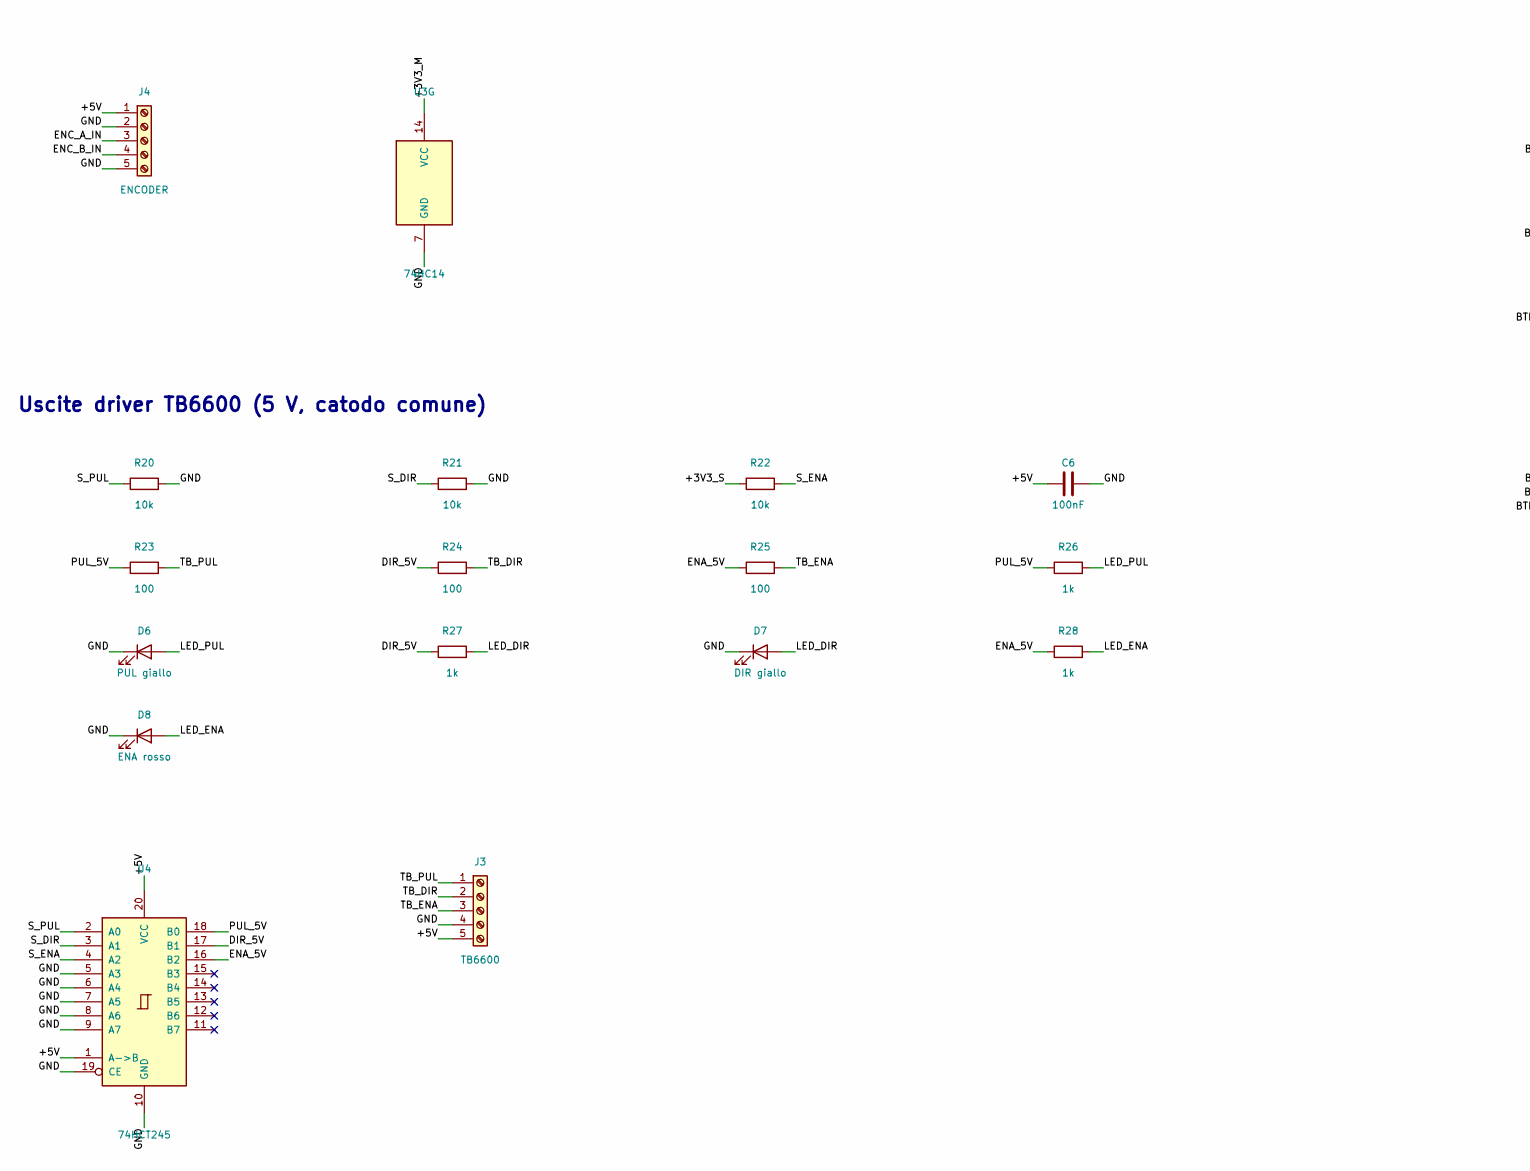
[picture p6: schematic RazorBoard.kicad_sch, RazorBoard SMD - scheda controller RazorGauge + motore, part in row 2, column 1]

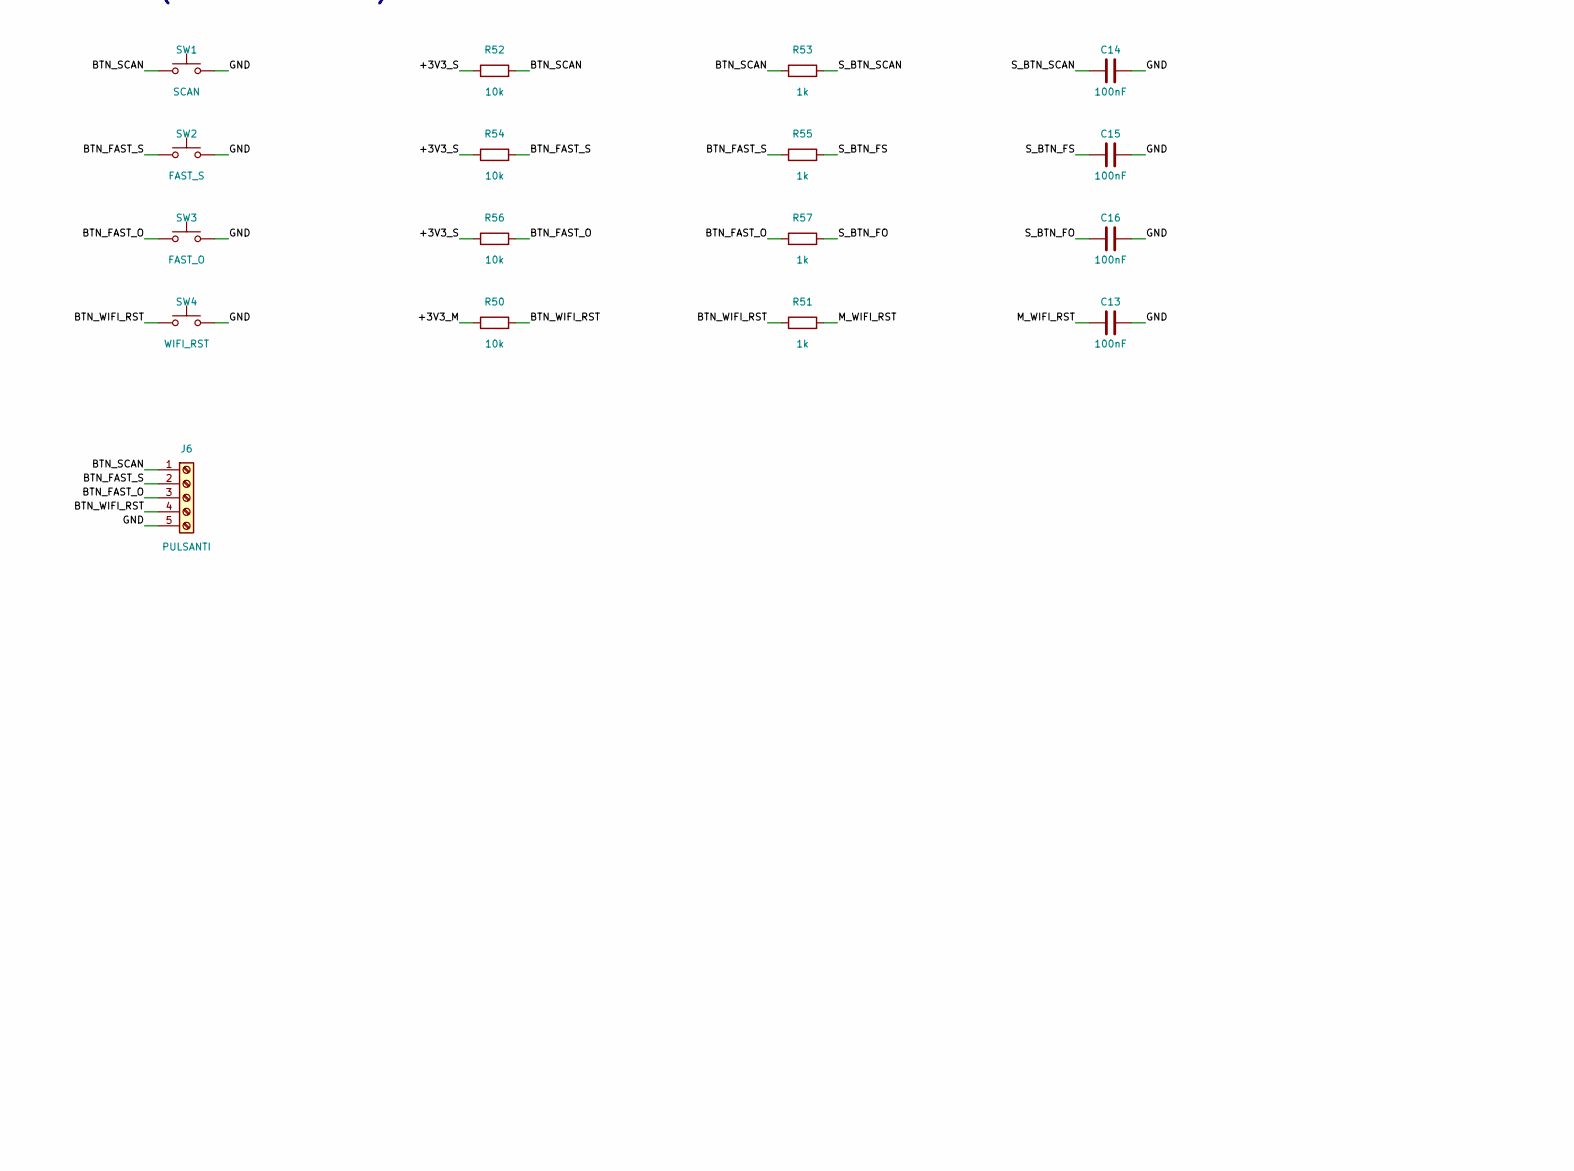
[picture p7: schematic RazorBoard.kicad_sch, RazorBoard SMD - scheda controller RazorGauge + motore, part in row 2, column 2]

Parts:
A1: MASTER ESP32 DevKit V1 30p; ESP32_DevKitV1_30p_W25.4; MPN 2x zoccolo femmina 1x15 passo 2.54, fil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
A2: SLAVE ESP32 DevKit V1 30p; ESP32_DevKitV1_30p_W25.4; MPN 2x zoccolo femmina 1x15 passo 2.54, fil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
C1: 10uF 50V; C_1206_3216Metric; MPN CL31A106KBHNNNE; LCSC C13585
C2, C5, C6, C9, C12, C13, C14, C15, C16: 100nF; C_0603_1608Metric; MPN CC0603KRX7R9BB104 50V; LCSC C14663
C3, C4, C11, C17: 10uF 25V; C_0805_2012Metric; MPN CL21A106KAYNNNE; LCSC C15850
C7, C8: 10nF; C_0603_1608Metric; MPN 0603B103K500NT 50V; LCSC C57112
C10: 1nF; C_0603_1608Metric; MPN CL10B102KB8NNNC 50V; LCSC C1588
D1: SS34; D_SMA; MPN SS34 3A 40V; LCSC C8678
D2: SMBJ33CA; D_SMB; MPN SMBJ33CA; LCSC C492017
D3: PWR verde; LED_0603_1608Metric; MPN KT-0603G; LCSC C12624
D4: B5819W; D_SOD-123; MPN B5819W SL (blocca ritorno da USB master); LCSC C8598
D5: B5819W; D_SOD-123; MPN B5819W SL (blocca ritorno da USB slave); LCSC C8598
D6: PUL giallo; LED_0603_1608Metric; MPN KT-0603Y; LCSC C2287
D7: DIR giallo; LED_0603_1608Metric; MPN KT-0603Y; LCSC C2287
D8: ENA rosso; LED_0603_1608Metric; MPN KT-0603R; LCSC C2286
D9, D10: 1N4148W; D_SOD-123; MPN 1N4148W; LCSC C81598
F1: PTC 0.5A 30V; Fuse_1812_4532Metric; MPN SMD1812P050TF/30 (hold 0.5A, trip 1A); LCSC C12559
H1, H2, H3, H4: M3; MountingHole_3.2mm_M3_Pad
J1: 24V IN; TerminalBlock_Phoenix_MKDS-1,5-2-5.08_1x02_P5.08mm_Horizont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
J2: 5V EXT; TerminalBlock_Phoenix_MKDS-1,5-2-5.08_1x02_P5.08mm_Horizont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
J3: TB6600; TerminalBlock_Phoenix_MKDS-1,5-5-5.08_1x05_P5.08mm_Horizont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; MPN PUL->PUL+, DIR->DIR+, ENA->ENA+, GND->P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
J4: ENCODER; TerminalBlock_Phoenix_MKDS-1,5-5-5.08_1x05_P5.08mm_Horizont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; MPN rosso +5V, nero GND, verde A, bianco B,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
J5: RAZORGAUGE; TerminalBlock_Phoenix_MKDS-1,5-8-5.08_1x08_P5.08mm_Horizont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; MPN cavo schermato max 50 cm, calza al pin 8
J6: PULSANTI; TerminalBlock_Phoenix_MKDS-1,5-5-5.08_1x05_P5.08mm_Horizont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
J7: UART DEBUG; PinHeader_1x03_P2.54mm_Vertical
JP1: SEL 5V; PinHeader_1x03_P2.54mm_Vertical; MPN Header 3 pin + jumper (1-2 = convertito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
JP2: SEL LASER; PinHeader_1x03_P2.54mm_Vertical; MPN Header 3 pin + jumper (1-2 = laser a 3.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
Q1: 2N7002; SOT-23; MPN 2N7002 (60V 115mA); LCSC C8545
R1, R26, R27, R28, R32, R33, R51, R53, R55, R57: 1k; R_0603_1608Metric; MPN 0603WAF1001T5E; LCSC C21190
R10, R11: 470; R_0603_1608Metric; MPN 0603WAF4700T5E; LCSC C23179
R20, R21, R22, R50, R52, R54, R56: 10k; R_0603_1608Metric; MPN 0603WAF1002T5E; LCSC C25804
R23, R24, R25, R40, R41, R42, R44: 100; R_0603_1608Metric; MPN 0603WAF1000T5E; LCSC C22775
R30, R31: 4.7k; R_0603_1608Metric; MPN 0603WAF4701T5E; LCSC C23162
R43: 0; R_0603_1608Metric; MPN 0603WAF0000T5E; LCSC C21189
R45: 100k; R_0603_1608Metric; MPN 0603WAF1003T5E; LCSC C25803
SW1: SCAN; SW_PUSH_6mm
SW2: FAST_S; SW_PUSH_6mm
SW3: FAST_O; SW_PUSH_6mm
SW4: WIFI_RST; SW_PUSH_6mm
U1: TSR 2-2450; Converter_DCDC_TRACO_TSR-1_THT; MPN Traco TSR 2-2450 (5V 2A)
U3: 74HC14; SOIC-14_3.9x8.7mm_P1.27mm; MPN 74HC14D,653 (a 3.3V, doppia inversione); LCSC C5605
U4: 74HCT245; SOIC-20W_7.5x12.8mm_P1.27mm; MPN 74HCT245D,653 (ingressi TTL, uscite 5V); LCSC C5979

Connections:
+3V3_M: A1.1 (3V3), C9.1, C11.1, C12.1, D9.1 (K), J5.1, JP2.1, R30.1, R31.1, R50.1, U3.14 (VCC)
+3V3_S: A2.1 (3V3), R22.1, R52.1, R54.1, R56.1
+5V: C4.1, C5.1, C6.1, C17.1, D4.2 (A), D5.2 (A), J3.5, J4.1, JP1.2, JP2.3, R1.1, U4.1 (A->B), U4.20 (VCC)
+5V_BUCK: C3.1, JP1.1, U1.3 (Vout)
+5V_EXT: J2.1, JP1.3
+24V: C1.1, C2.1, D1.1 (K), D2.1 (A1), U1.1 (Vin)
+24V_F: D1.2 (A), F1.2
+24V_IN: F1.1, J1.1
BTN_FAST_O: J6.3, R56.2, R57.1, SW3.1
BTN_FAST_S: J6.2, R54.2, R55.1, SW2.1
BTN_SCAN: J6.1, R52.2, R53.1, SW1.1
BTN_WIFI_RST: J6.4, R50.2, R51.1, SW4.1
DIR_5V: R24.1, R27.1, U4.17 (B1)
ENA_5V: R25.1, R28.1, U4.16 (B2)
ENC_A_3V: A1.25 (D32), U3.4
ENC_A_F: C7.1, R32.2, U3.1
ENC_A_IN: J4.3, R30.2, R32.1
ENC_A_N: U3.2, U3.3
ENC_B_3V: A1.24 (D33), U3.8
ENC_B_F: C8.1, R33.2, U3.5
ENC_B_IN: J4.4, R31.2, R33.1
ENC_B_N: U3.6, U3.9
GND: A1.2 (GND), A1.17 (GND), A2.2 (GND), A2.17 (GND), C1.2, C2.2, C3.2, C4.2, C5.2, C6.2, C7.2, C8.2, C9.2, C10.2, C11.2, C12.2, C13.2, C14.2, C15.2, C16.2, C17.2, D2.2 (A2), D3.1 (K), D6.1 (K), D7.1 (K), D8.1 (K), D10.2 (A), H1.1, H2.1, H3.1, H4.1, J1.2, J2.2, J3.4, J4.2, J4.5, J5.2, J5.8, J6.5, J7.1, Q1.2 (S), R20.2, R21.2, R45.2, SW1.2, SW2.2, SW3.2, SW4.2, U1.2 (GND), U3.7 (GND), U3.11, U3.13, U4.5 (A3), U4.6 (A4), U4.7 (A5), U4.8 (A6), U4.9 (A7), U4.10 (GND), U4.19 (CE)
G_AO: J5.5, R42.1
G_AO_M: A1.27 (D34), C10.1, D9.2 (A), D10.1 (K), R42.2
G_CLK: J5.4, R41.2
G_CLK_M: A1.21 (D27), R41.1
G_LASER_M: A1.23 (D25), R44.1
G_SI: J5.3, R40.2
G_SI_M: A1.22 (D26), R40.1
LASER_G: Q1.1 (G), R44.2, R45.1
LASER_N: J5.7, Q1.3 (D)
LASER_P: J5.6, R43.2
LASER_SEL: JP2.2, R43.1
LED_DIR: D7.2 (A), R27.2
LED_ENA: D8.2 (A), R28.2
LED_PUL: D6.2 (A), R26.2
LED_PWR: D3.2 (A), R1.2
M_RX16: A1.6 (RX2), R11.2
M_TX17: A1.7 (TX2), J7.2, R10.1
M_VIN: A1.16 (VIN), D4.1 (K)
M_WIFI_RST: A1.20 (D14), C13.1, R51.2
PUL_5V: R23.1, R26.1, U4.18 (B0)
S_BTN_FO: A2.27 (D34), C16.1, R57.2
S_BTN_FS: A2.24 (D33), C15.1, R55.2
S_BTN_SCAN: A2.25 (D32), C14.1, R53.2
S_DIR: A2.22 (D26), R21.1, U4.3 (A1)
S_ENA: A2.21 (D27), R22.2, U4.4 (A2)
S_PUL: A2.23 (D25), R20.1, U4.2 (A0)
S_RX16: A2.6 (RX2), R10.2
S_TX17: A2.7 (TX2), J7.3, R11.1
S_VIN: A2.16 (VIN), D5.1 (K)
TB_DIR: J3.2, R24.2
TB_ENA: J3.3, R25.2
TB_PUL: J3.1, R23.2

Notes on the sheet:
Alimentazione 24 V -> 5 V
Encoder LPD3806-600BM (NPN OC, 5 V)
Uscite driver TB6600 (5 V, catodo comune)
Master ESP32 (WROOM-32, 30 pin)
Interfaccia RazorGauge (TSL1401 + laser)
Pulsanti (a bordo + morsetti)
Slave ESP32 (WROOM-32, 30 pin)
UART master <-> slave
Fori di fissaggio
NOTE:
- Encoder spostato da GPIO12/13 a GPIO32/33 (GPIO12 e pin di avvio): aggiornare ENCODER_DATA_PIN=32, ENCODER_CLOCK_PIN=33 nel master.
- TB6600 a catodo comune: PUL/DIR/ENA alti = LED opto acceso. ENA alto = motore libero (pull-up R22 = motore libero all accensione).
- Il motore e il TB6600 si alimentano direttamente dall alimentatore 24 V, non dalla scheda.
- Slave = ESP32 DevKit V1 30p come il master: PUL/DIR/ENA su GPIO25/26/27, pulsanti su GPIO32/33/34, UART su GPIO16/17 (firmware slave 0.6.0).
- D4/D5 impediscono che l USB di un modulo alimenti tutta la scheda.
- Calza dei cavi schermati collegata a GND solo lato scheda.

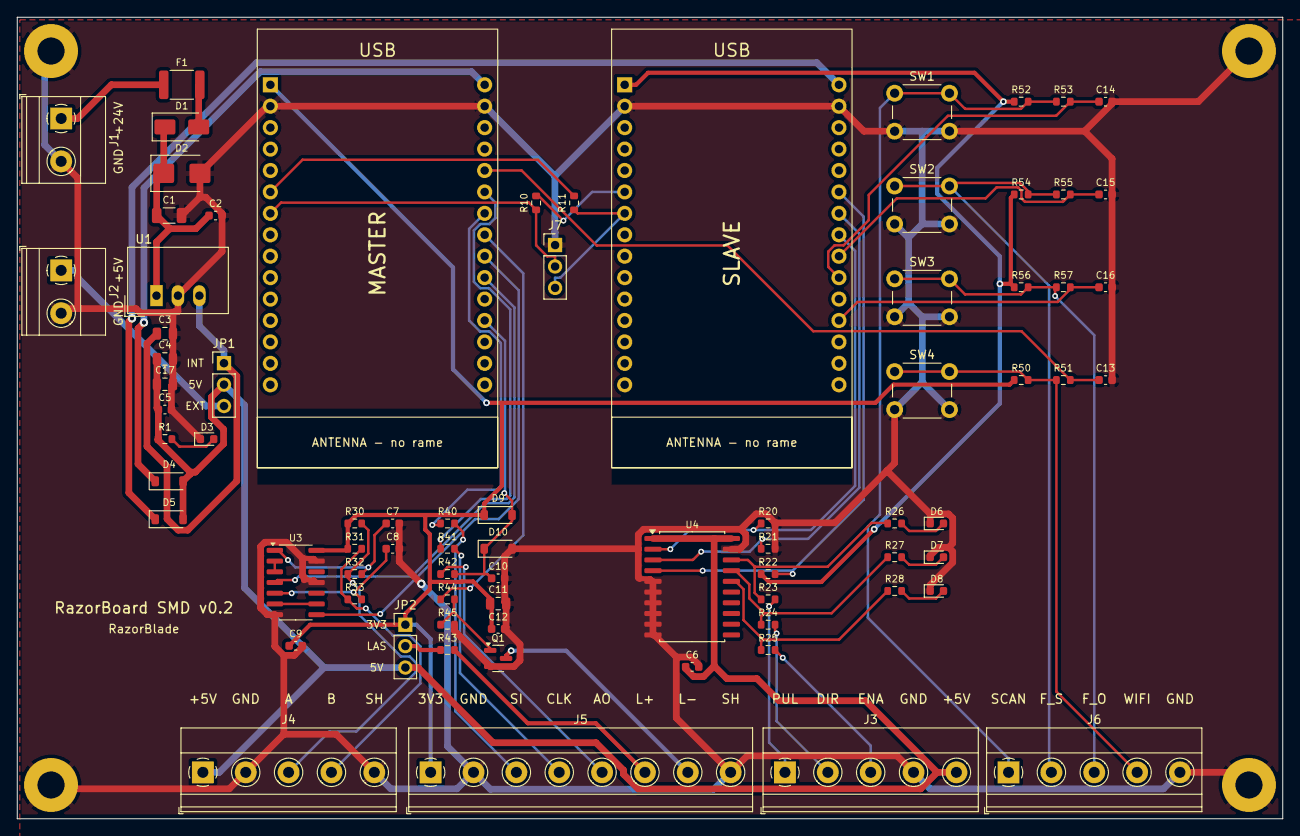
[picture p8: board RazorBoard.kicad_pcb from above]

Board: 2 copper layers, 150.0 x 95.0 mm, 81 parts (0 on the bottom side), 55 nets.
