stefanodemartini/RazorGauge/slave/slave.ino

#include <FastAccelStepper.h>
#include <WiFi.h>
#include <WebServer.h>
#include <WiFiManager.h>

// ===============================
// FW SLAVE - Controllo Motore Passo-Passo
// ===============================
#define FIRMWARE_VERSION "0.6.7"
#define FIRMWARE_DATE "2026-10-20 22:10:02 +02:00"
#define FIRMWARE_FEATURES "UART Control + WiFi diagnostics endpoint + UART RX GPIO pull-up test + UART RX counters over protocol + GOTOPOS two-phase (fast approach + 400Hz creep) + encoder forceStop + non-blocking caliper buffer + porting su ESP32 classico (DevKit V1 30p, RazorBoard)"

// -----------------------------
// Pin definitions
// Porting 0.6.0: slave su ESP32 classico (DevKit V1 30 pin, come il master) — pin della scheda RazorBoard.
// Sull'ESP32 classico i GPIO 6-11 sono collegati alla flash: i vecchi pin dello S3 (6, 10, 11) non sono utilizzabili.
#define PUL_PIN 25     // era 4 (S3)
#define DIR_PIN 26     // era 5
#define ENA_PIN 27     // era 6
#define BTN_SCAN 32    // era 10
#define BTN_FAST_S 33  // era 11
#define BTN_FAST_O 34  // era 12 — GPIO34 e solo ingresso, senza pull-up interna: la pull-up 10k e sulla scheda
#define UART_RX 16     // era 21 — RX2, collegato al TX2 (GPIO17) del master
#define UART_TX 17     // era 18 — TX2, collegato al RX2 (GPIO16) del master

// -----------------------------
// UART
HardwareSerial SerialMaster(2);
WebServer diagServer(80);
WiFiManager wifiManager;

// -----------------------------
// Motor parameters
const uint32_t SCAN_HZ = 1500;       // Initial estimate for 2.0 cm/s; closed-loop from master fine-tunes this
const uint32_t FAST_HZ = 12000;
const uint32_t GOTOPOS_MAX_HZ = (uint32_t)(FAST_HZ * 0.70f);  // 8400 Hz — 30% slower than FAST
const uint32_t ACCEL = 1500;
const uint32_t GOTOPOS_ACCEL       = 800;    // gentle accel/decel for phase-1 long approach
const uint32_t GOTOPOS_CREEP_HZ    = 400;    // phase-2 creep speed ≈ 0.5 cm/s (precise final approach)
const uint32_t GOTOPOS_CREEP_ACCEL = 5000;   // fast decel/accel inside creep zone
const uint32_t FAST_STOP_DECEL = 24000;
const uint32_t MIN_SPEED_HZ = 300;
const uint32_t STEPS_PER_ENC = 25;           // stepper steps per encoder pulse
const int32_t  GOTOPOS_STOP_ENC_STEPS = 3;   // ≈ 1 mm — encoder stop threshold

// ── Encoder calibration (deve corrispondere al master) ────────────────────
// Set ENCODER_PPR and WHEEL_CIRC_MM to match your hardware.
// See master.ino for full explanation.
// Formula: PULSES_PER_CM = (PPR × 10) / WHEEL_CIRC_MM
#define ENCODER_PPR_S    600   // encoder datasheet value (same unit as master)
#define WHEEL_CIRC_MM_S  200   // wheel circumference mm (same as master)
const float PULSES_PER_CM = (ENCODER_PPR_S * 10.0f) / WHEEL_CIRC_MM_S;  // 30.0 pulses/cm

// Derived: creep zone = 4 cm before target
const int32_t  GOTOPOS_CREEP_DIST_ENC = (int32_t)(4.0f * PULSES_PER_CM);

// -----------------------------
// State variables
enum Mode { STOPPED, SCAN, FAST_S, FAST_O, GOTOPOS };
Mode mode = STOPPED;
bool fwd = true;
int32_t targetPos = 0;
bool posActive = false;
uint32_t currentDynamicSpeed = 0;

// Encoder-fed position: updated by POS:<steps> messages from master.
int32_t encoderFedPos = 0;
bool encoderPosReceived = false;
bool rxDiagnosticMode = false;
// GOTOPOS two-phase state: false = phase-1 fast approach, true = phase-2 creep
bool gotoPhase2 = false;

// -----------------------------
// FastAccelStepper objects
FastAccelStepperEngine engine;
FastAccelStepper* stepper = nullptr;

// -----------------------------
// UART buffers
char rxBuffer[64];
size_t rxLen = 0;
String txPending;
bool txPendingFlag = false;
uint32_t uartRxBytes = 0;
uint32_t uartRxLines = 0;
uint32_t uartRxCommands = 0;
String uartLastControlCommand = "NONE";
unsigned long uartLastCommandAt = 0;

// -----------------------------
// Button debounce
unsigned long lastDebounceScan = 0;
unsigned long lastDebounceFastS = 0;
unsigned long lastDebounceFastO = 0;
const unsigned long DEBOUNCE_MS = 250;

// -----------------------------
// Position monitoring
unsigned long lastPosCheck = 0;
int32_t lastPos = 0;
unsigned long lastMoveTime = 0;

// -----------------------------
// Forward declarations
const char* modeToString(Mode m);
void sendStatus();
void transmitPending();
void startMotion(bool forward, uint32_t speedHz, Mode newMode);
void stopMotion();
int32_t getDistanceToGo();
uint32_t calculateDynamicSpeed(int32_t distanceToGo);
void updateDynamicSpeed();
void processCommand(const char* command);
void receiveData();
void appendUartDiagnostics();
void setupDiagnosticsServer();
void checkPositionReached();
void handleButtons();

// -----------------------------
// Helper functions
bool isButtonPressed(int pin) {
  return !digitalRead(pin);
}

const char* modeToString(Mode m) {
  switch (m) {
    case GOTOPOS: return "GOTOPOS";
    case SCAN: return "SCAN";
    case FAST_S: return "FAST_S";
    case FAST_O: return "FAST_O";
    default: return "STOP";
  }
}

// -----------------------------
// Motor control functions
void startMotion(bool forward, uint32_t speedHz, Mode newMode) {
  fwd = forward;
  stepper->setSpeedInHz(speedHz);
  stepper->setAcceleration(ACCEL);
  
  if (forward) {
    stepper->runForward();
  } else {
    stepper->runBackward();
  }
  
  mode = newMode;
  currentDynamicSpeed = speedHz;
  lastMoveTime = millis();
  
  if (newMode == GOTOPOS) {
    posActive = true;
  }
  
  Serial.print("Avvio movimento: ");
  Serial.print(modeToString(newMode));
  Serial.print(" - ");
  Serial.println(forward ? "AVANTI" : "INDIETRO");
}

void stopMotion() {
  if (stepper) {
    if (mode == FAST_S || mode == FAST_O) {
      stepper->setAcceleration(FAST_STOP_DECEL);
      stepper->stopMove();
    } else if (mode == GOTOPOS) {
      // forceStop() cuts power immediately — no deceleration ramp.
      // CRITICAL: stopMove() followed by setAcceleration(ACCEL) would override any
      // FAST_STOP_DECEL set during the slow-zone transition, reverting to 1500 Hz/s
      // and causing 64 cm of coast. forceStop() avoids this entirely.
      // Step loss is acceptable: encoder (not step counter) is the position reference.
      stepper->forceStop();
    } else {
      stepper->stopMove();
    }
    stepper->setAcceleration(ACCEL);  // safe: motor is stopped (forceStop) or decelerating (stopMove)
  }
  mode = STOPPED;
  posActive = false;
  currentDynamicSpeed = 0;
  encoderPosReceived = false;
  gotoPhase2 = false;
  Serial.println("Motore STOP");
}

int32_t getDistanceToGo() {
  if (!encoderPosReceived) return INT32_MAX;
  return abs(targetPos - encoderFedPos);
}

// No manual speed ramp needed — FastAccelStepper's move() handles it automatically.

void checkPositionReached() {
  if (mode != GOTOPOS || !posActive || !encoderPosReceived) return;

  int32_t signedDist = targetPos - encoderFedPos;
  bool overshot = fwd ? (signedDist < 0) : (signedDist > 0);
  int32_t distanceToGo = abs(signedDist);

  if (overshot || distanceToGo <= GOTOPOS_STOP_ENC_STEPS) {
    if (overshot) Serial.println("⚠ Overshoot rilevato — stop forzato");
    // forceStop() cuts power immediately — no deceleration ramp.
    // Safe here because we are already at MIN_SPEED_HZ (300 Hz ≈ 0.5 cm/s).
    stepper->forceStop();
    stepper->setAcceleration(ACCEL);  // restore normal accel (FAST_STOP_DECEL was set during slow-zone transition)
    mode = STOPPED;
    posActive = false;
    currentDynamicSpeed = 0;
    encoderPosReceived = false;
    sendStatus();
    Serial.println("✓ Target raggiunto!");
  }
}

// -----------------------------
// UART communication
void sendStatus() {
  txPending = "STATUS:" + String(modeToString(mode)) + ":" + String(fwd ? "FWD" : "BWD");
  if (mode == GOTOPOS && posActive && encoderPosReceived) {
    int32_t distanceToGo = getDistanceToGo();
    txPending += ":" + String(distanceToGo);
  }
  txPending += "\n";
  txPendingFlag = true;
}

void appendUartDiagnostics() {
  txPending += "UARTDIAG:" + String(uartRxBytes) + ":" +
               String(uartRxLines) + ":" + String(uartRxCommands) + ":" +
               uartLastControlCommand + ":" + WiFi.localIP().toString() + "\n";
  txPendingFlag = true;
}

void transmitPending() {
  if (!txPendingFlag) return;
  if (SerialMaster.availableForWrite() >= (int)txPending.length()) {
    SerialMaster.print(txPending);
    txPendingFlag = false;
    Serial.print("Inviato: ");
    Serial.print(txPending);
  }
}

void processCommand(const char* command) {
  uartRxCommands++;
  uartLastCommandAt = millis();
  if (strcmp(command, "STATUS?") != 0 &&
      strncmp(command, "POS:", 4) != 0 &&
      strncmp(command, "SETHZ:", 6) != 0) {
    uartLastControlCommand = command;
  }
  Serial.print("Ricevuto comando: ");
  Serial.println(command);
  
  // Comandi esistenti
  if (strcmp(command, "SCAN") == 0) {
    startMotion(fwd, SCAN_HZ, SCAN);
    sendStatus();
    return;
  }
  
  if (strcmp(command, "STOP") == 0) {
    stopMotion();
    sendStatus();
    return;
  }
  
  if (strcmp(command, "FAST_S") == 0) {
    startMotion(fwd, FAST_HZ, FAST_S);
    sendStatus();
    return;
  }
  
  if (strcmp(command, "FAST_O") == 0) {
    startMotion(!fwd, FAST_HZ, FAST_O);
    sendStatus();
    return;
  }
  
  if (strcmp(command, "STATUS?") == 0) {
    sendStatus();
    appendUartDiagnostics();
    return;
  }

  // POS:<steps> — encoder position fed by master every ~100ms during GOTOPOS.
  // This is the sole authoritative position source; step counter is not used.
  if (strncmp(command, "POS:", 4) == 0) {
    encoderFedPos = (int32_t)atol(command + 4);
    encoderPosReceived = true;
    if (mode == GOTOPOS && posActive) {
      checkPositionReached();
    }
    return;
  }

  // Comando GOTOPOS:<target_cm>:<velocita_max>:<encoder_pos>:<F|B>
  // Esempio: GOTOPOS:150:12000:4560:F
  // encoder_pos = current encoder value sent by master so slave knows distance from step 0
  if (strncmp(command, "GOTOPOS:", 8) == 0) {
    char* ptr = (char*)command + 8;
    
    float targetCm = atof(ptr);
    // Convert cm to encoder steps (same constant as master)
    targetPos = (int32_t)(targetCm * PULSES_PER_CM);
    
    // Parse initial encoder position (3rd field after targetCm and maxHz)
    // Format: targetCm:maxHz:encoderPos:dir
    char* p1 = strchr(ptr, ':');                       // → ":maxHz:encoderPos:dir"
    char* p2 = p1 ? strchr(p1 + 1, ':') : nullptr;    // → ":encoderPos:dir"
    if (p2) {
      encoderFedPos = (int32_t)atol(p2 + 1);  // atol stops at ':', safe
      encoderPosReceived = true;
    } else {
      encoderPosReceived = false;  // fallback: wait for first POS update
    }
    
    // Direction from last field (strrchr finds last ':' → ":F" or ":B")
    char* dirPtr = strrchr(ptr, ':');
    if (dirPtr) {
      dirPtr++;
      fwd = (*dirPtr == 'F' || *dirPtr == 'f');
    } else {
      fwd = true;
    }
    
    int32_t initialDist = getDistanceToGo();

    Serial.print("GOTOPOS: target=");
    Serial.print(targetCm);
    Serial.print(" cm (");
    Serial.print(targetPos);
    Serial.print(" enc), encoder iniziale=");
    Serial.print(encoderFedPos);
    Serial.print(", dist=");
    Serial.print(initialDist);
    Serial.print(", direzione=");
    Serial.println(fwd ? "AVANTI" : "INDIETRO");

    mode = GOTOPOS;
    posActive = true;
    currentDynamicSpeed = GOTOPOS_MAX_HZ;

    if (initialDist > GOTOPOS_CREEP_DIST_ENC) {
      // Phase 1: fast trapezoidal approach — stop naturally at the creep-zone entry,
      // i.e. GOTOPOS_CREEP_DIST_ENC encoder pulses (4 cm) short of the final target.
      gotoPhase2 = false;
      int32_t phase1Steps = (initialDist - GOTOPOS_CREEP_DIST_ENC) * (int32_t)STEPS_PER_ENC;
      stepper->setSpeedInHz(GOTOPOS_MAX_HZ);
      stepper->setAcceleration(GOTOPOS_ACCEL);
      stepper->move(fwd ? phase1Steps : -phase1Steps);
      Serial.println("→ GOTOPOS fase 1 (approccio veloce)");
    } else {
      // Short move or already within 4 cm: go straight to creep speed.
      gotoPhase2 = true;
      int32_t phase2Steps = initialDist * (int32_t)STEPS_PER_ENC;
      stepper->setSpeedInHz(GOTOPOS_CREEP_HZ);
      stepper->setAcceleration(GOTOPOS_CREEP_ACCEL);
      stepper->move(fwd ? phase2Steps : -phase2Steps);
      Serial.println("→ GOTOPOS fase 2 diretta (distanza breve)");
    }

    sendStatus();
    return;
  }
  
  // SETHZ:<hz> — dynamic scan speed adjustment sent by master closed-loop controller.
  // Only applied during SCAN; ignored in other modes.
  if (strncmp(command, "SETHZ:", 6) == 0) {
    uint32_t newHz = (uint32_t)atol(command + 6);
    if (mode == SCAN && newHz >= 200 && newHz <= 3000) {
      stepper->setSpeedInHz(newHz);
      currentDynamicSpeed = newHz;
      Serial.print("SETHZ: ");
      Serial.println(newHz);
    }
    return;
  }

  // Comando non riconosciuto
  Serial.print("Comando sconosciuto: ");
  Serial.println(command);
  sendStatus();
}

void receiveData() {
  while (SerialMaster.available()) {
    char ch = SerialMaster.read();
    uartRxBytes++;
    if (ch == '\r') continue;
    
    if (ch == '\n') {
      uartRxLines++;
      rxBuffer[rxLen] = '\0';
      if (rxLen > 0) {
        processCommand(rxBuffer);
      }
      rxLen = 0;
      continue;
    }
    
    if (rxLen < sizeof(rxBuffer) - 1) {
      rxBuffer[rxLen++] = ch;
    } else {
      // Buffer overflow, reset
      rxLen = 0;
    }
  }
}

void setupDiagnosticsServer() {
  wifiManager.setConfigPortalTimeout(180);
  bool connected = wifiManager.autoConnect("RazorGauge_Slave_Setup", "12345678");
  if (!connected) {
    Serial.println("Wi-Fi diagnostics unavailable; motor controller remains active.");
    return;
  }

  diagServer.on("/", HTTP_GET, []() {
    diagServer.send(200, "text/plain",
                    "RazorGauge slave diagnostics: open /diag for JSON.");
  });
  diagServer.on("/diag", HTTP_GET, []() {
    String json = "{\"firmware\":\"" + String(FIRMWARE_VERSION) +
                  "\",\"build\":\"" + String(FIRMWARE_DATE) +
                  "\",\"ip\":\"" + WiFi.localIP().toString() +
                  "\",\"mode\":\"" + String(modeToString(mode)) +
                  "\",\"direction\":\"" + String(fwd ? "FWD" : "BWD") +
                  "\",\"rxBytes\":" + String(uartRxBytes) +
                  ",\"rxLines\":" + String(uartRxLines) +
                  ",\"rxCommands\":" + String(uartRxCommands) +
                  ",\"lastControl\":\"" + uartLastControlCommand +
                  "\",\"lastCommandAgeMs\":" +
                  String(uartLastCommandAt == 0 ? -1L : (long)(millis() - uartLastCommandAt)) + "}";
    diagServer.send(200, "application/json", json);
  });
  diagServer.on("/rx_test", HTTP_GET, []() {
    rxDiagnosticMode = true;
    if (mode != STOPPED || stepper->isRunning()) {
      stepper->forceStop();
      mode = STOPPED;
      posActive = false;
      currentDynamicSpeed = 0;
      encoderPosReceived = false;
      gotoPhase2 = false;
    }

    SerialMaster.end();
    pinMode(UART_RX, INPUT_PULLUP);
    delay(20);
    uint8_t highSamples = 0;
    constexpr uint8_t sampleCount = 20;
    for (uint8_t i = 0; i < sampleCount; i++) {
      highSamples += digitalRead(UART_RX) == HIGH ? 1 : 0;
      delay(1);
    }
    SerialMaster.begin(115200, SERIAL_8N1, UART_RX, UART_TX);

    const bool pulledHigh = highSamples == sampleCount;
    String json = "{\"pin\":\"RX2/GPIO16\",\"motorStopped\":true,\"samples\":" +
                  String(sampleCount) + ",\"highSamples\":" +
                  String(highSamples) + ",\"result\":\"" +
                  String(pulledHigh ? "HIGH" : "LOW") + "\"}";
    diagServer.send(200, "application/json", json);
  });
  diagServer.begin();
  Serial.print("Slave diagnostics: http://");
  Serial.print(WiFi.localIP());
  Serial.println("/diag");
}

// -----------------------------
// Button handling
void handleButtons() {
  if (mode == GOTOPOS) return;  // FW-05: ignore buttons during GOTOPOS to prevent isGoToActive lock
  unsigned long now = millis();
  
  // Pulsante SCAN
  if (isButtonPressed(BTN_SCAN) && (now - lastDebounceScan) > DEBOUNCE_MS) {
    if (mode == SCAN) {
      stopMotion();
    } else {
      startMotion(fwd, SCAN_HZ, SCAN);
    }
    lastDebounceScan = now;
    sendStatus();
    Serial.println("Pulsante SCAN premuto");
  }
  
  // Pulsante FAST_S (stessa direzione)
  if (isButtonPressed(BTN_FAST_S) && (now - lastDebounceFastS) > DEBOUNCE_MS) {
    if (mode == FAST_S) {
      stopMotion();
    } else {
      startMotion(fwd, FAST_HZ, FAST_S);
    }
    lastDebounceFastS = now;
    sendStatus();
    Serial.println("Pulsante FAST_S premuto");
  }
  
  // Pulsante FAST_O (direzione opposta)
  if (isButtonPressed(BTN_FAST_O) && (now - lastDebounceFastO) > DEBOUNCE_MS) {
    if (mode == FAST_O) {
      stopMotion();
    } else {
      startMotion(!fwd, FAST_HZ, FAST_O);
    }
    lastDebounceFastO = now;
    sendStatus();
    Serial.println("Pulsante FAST_O premuto");
  }
}

// -----------------------------
// Setup
void setup() {
  // Serial console per debug
  Serial.begin(115200);
  
  // UART per comunicazione con master
  SerialMaster.begin(115200, SERIAL_8N1, UART_RX, UART_TX);
  
  // Configura pulsanti
  pinMode(BTN_SCAN, INPUT_PULLUP);
  pinMode(BTN_FAST_S, INPUT_PULLUP);
  pinMode(BTN_FAST_O, INPUT);         // GPIO34: solo ingresso, nessuna pull-up interna (evita l'errore di pinMode); pull-up 10k sulla scheda
  
  // Inizializza stepper
  engine.init();
  stepper = engine.stepperConnectToPin(PUL_PIN);
  
  if (!stepper) {
    Serial.println("ERRORE: Impossibile inizializzare lo stepper!");
    while (1) {
      delay(1000);
    }
  }
  
  stepper->setDirectionPin(DIR_PIN);
  stepper->setEnablePin(ENA_PIN);
  stepper->setAutoEnable(true);
  
  // Imposta posizione iniziale a 0
  stepper->setCurrentPosition(0);
  
  // Ferma motore all'avvio
  stopMotion();
  
  // Invia stato iniziale
  sendStatus();
  
  // Stampa informazioni di avvio
  Serial.println("========================================");
  Serial.println("=== SLAVE CONTROLLO MOTORE ===");
  Serial.print("Versione: ");
  Serial.println(FIRMWARE_VERSION);
  Serial.print("Data: ");
  Serial.println(FIRMWARE_DATE);
  Serial.print("Caratteristiche: ");
  Serial.println(FIRMWARE_FEATURES);
  Serial.println("========================================");
  Serial.println("Comandi disponibili:");
  Serial.println("  SCAN           - Avvia scansione (velocità lenta)");
  Serial.println("  STOP           - Ferma motore");
  Serial.println("  FAST_S         - Avanti veloce (stessa direzione)");
  Serial.println("  FAST_O         - Indietro veloce (direzione opposta)");
  Serial.println("  STATUS?        - Richiedi stato");
  Serial.println("  GOTOPOS:cm:max_hz:dir - Vai a posizione");
  Serial.println("    Esempio: GOTOPOS:150:12000:F");
  Serial.println("========================================");
  setupDiagnosticsServer();
}

// -----------------------------
// Main loop
void loop() {
  // Gestione comunicazione UART
  receiveData();
  transmitPending();
  diagServer.handleClient();
  
  // Gestione movimento GOTOPOS
  if (mode == GOTOPOS && posActive) {
    checkPositionReached();

    if (mode == GOTOPOS && !stepper->isRunning()) {
      if (!gotoPhase2) {
        // Phase 1 finished — motor stopped at creep-zone entry.
        // Start phase 2: slow precise creep to the final target.
        gotoPhase2 = true;
        int32_t dist2 = encoderPosReceived ? getDistanceToGo() : 0;
        Serial.print("→ GOTOPOS fase 2 (creep), dist rimanente=");
        Serial.println(dist2);
        if (dist2 <= GOTOPOS_STOP_ENC_STEPS) {
          // Already close enough (encoder confirms arrival during phase 1).
          stopMotion();
          sendStatus();
          Serial.println("✓ GOTOPOS completato (alla fine della fase 1)");
        } else {
          int32_t phase2Steps = dist2 * (int32_t)STEPS_PER_ENC;
          stepper->setSpeedInHz(GOTOPOS_CREEP_HZ);
          stepper->setAcceleration(GOTOPOS_CREEP_ACCEL);
          stepper->move(fwd ? phase2Steps : -phase2Steps);
        }
      } else {
        // Phase 2 finished naturally — motor stopped at or very near the target.
        stopMotion();
        sendStatus();
        Serial.println("✓ GOTOPOS completato (fase 2 naturale)");
      }
    }
    
    // Monitoraggio posizione per debug (ogni 500ms)
    unsigned long now = millis();
    if (now - lastPosCheck > 500) {
      lastPosCheck = now;
      if (encoderPosReceived && encoderFedPos != lastPos) {
        lastPos = encoderFedPos;
        int32_t remaining = getDistanceToGo();
        Serial.print("Encoder pos: ");
        Serial.print(encoderFedPos);
        Serial.print(" passi, rimanenti: ");
        Serial.println(remaining);
      }
    }
  }
  
  // Gestione pulsanti fisici
  if (!rxDiagnosticMode) handleButtons();
  
  // Piccolo delay per non sovraccaricare la CPU
  delay(1);
}
