stefanodemartini/RazorGauge/master/master.ino

#include <WiFi.h>
#include <WebServer.h>
#include <WebSocketsServer.h>
#include <EEPROM.h>
#include <WiFiManager.h>
#include <HardwareSerial.h>
#include "driver/pcnt.h"  // ESP32 hardware pulse counter — immune to ISR interference

// ===============================
// FW
// ===============================
#define FIRMWARE_VERSION "0.4.25-RB2"
#define FIRMWARE_DATE "2026-10-20 20:13:29 +02:00"
#define FIRMWARE_FEATURES "WiFi Manager + EMA + 0.01mm + UART Motor + UART RX diagnostics + Scan timer + Autostop + RicezioneON/OFF + GOTOPOS + Caliper timeout + Atomic encoder + Watchdog armed on motor start + Scan state sync on connect + GOTOPOS chart overlay + encoder init fix + non-blocking caliper buffer + GOTOPOS overshoot safety guard + mirrored profile chart + hardware PCNT encoder (ISR-immune)"

// -----------------------------
// Versione "calibro" per la RazorBoard SMD: identica alla 0.4.22 originale, cambiano SOLO i pin dell'encoder.
// Sulla RazorBoard l'encoder (morsetto J4: verde A, bianco B) arriva al master su GPIO32 (A) e GPIO33 (B)
// attraverso pull-up 4.7k, filtro RC e 74HC14 (U3). Il calibro va sul morsetto J5: CLOCK -> pin 3 (GPIO26),
// DATA -> pin 4 (GPIO27), GND -> pin 2, tramite il modulo traslatore (alimentato a 5 V da J3 pin 5, HV 3.3 V,
// calibro 1.2 V). Se la lunghezza resta ferma/negativa con velocita' visibile: scambiare verde e bianco su J4.
#define ENCODER_DATA_PIN 32   // fase A (era 12)
#define ENCODER_CLOCK_PIN 33  // fase B (era 13)
#define CALIPER_DATA_PIN 27
#define CALIPER_CLOCK_PIN 26
#define WIFI_RESET_PIN 14
// ── Encoder calibration ────────────────────────────────────────────────────
// Change ENCODER_PPR and WHEEL_CIRC_MM to match your hardware.
// PULSES_PER_CM is then derived automatically — never set it directly.
//
//   ENCODER_PPR   : pulses per revolution, from encoder datasheet.
//   WHEEL_CIRC_MM : wheel circumference in mm. Measure by wrapping a piece of
//                   string around the wheel once, then measuring the string.
//                   Do NOT calculate from the diameter unless you are sure it
//                   is the rolling diameter (not the outer or bore diameter).
//
// Hardware PCNT counting mode: PCNT_UNIT_0 counts only A-phase edges where
// B=0. This is 1× decoding → effective counts = 1× PPR per revolution.
// The hardware counter is immune to caliper ISR interference.
//
// Formula:  PULSES_PER_CM = (ENCODER_PPR × 10) / WHEEL_CIRC_MM
//   e.g.  PPR=600, circ=190 mm  →  6000/190 = 31.578 pulses/cm
//         PPR=600, circ=200 mm  →  6000/200 = 30 pulses/cm
// ──────────────────────────────────────────────────────────────────────────
#define ENCODER_PPR     600   // encoder datasheet value
#define WHEEL_CIRC_MM   200   // physical wheel circumference in mm
#define PULSES_PER_CM   ((ENCODER_PPR * 10.0f) / WHEEL_CIRC_MM)   // float: 6000/200 = 30.0
#define EEPROM_SIZE 512
#define EEPROM_ADDR_CALIB_PPC 4   // float (4 bytes) — calibrated pulses/cm; 0 = use formula

float lineDiameter = 0.0;
bool scanEnabled = false;
bool oldScanState = false;  // Per salvare stato scansione durante GOTOPOS

// FW-14: removed dead #define ALPHA 0.05 (actual EMA uses hardcoded 0.1f)

float smoothedDiameter = 0.0;
bool filterInitialized = false;
// EMA smoothing removed from firmware — app handles smoothing client-side

static const int MOTOR_UART_RX_PIN = 16;
static const int MOTOR_UART_TX_PIN = 17;
HardwareSerial SerialMotor(2);

String motorMode = "UNKNOWN";
String motorDir = "UNKNOWN";
unsigned long motorLastSeenMs = 0;

static char motorRxLine[128];
static size_t motorRxLen = 0;
static String motorTxPending;
static bool motorTxHasPending = false;
static uint32_t motorTxLines = 0;
static uint32_t motorTxQueued = 0;
static uint32_t motorRxBytes = 0;
static uint32_t motorRxLines = 0;
static uint32_t motorStatusLines = 0;
static uint32_t slaveUartRxBytes = 0;
static uint32_t slaveUartRxLines = 0;
static uint32_t slaveUartRxCommands = 0;
static String slaveLastControlCommand = "UNKNOWN";
static String slaveDiagIp = "0.0.0.0";
static String motorLastQueued;
static String motorLastSent;
static unsigned long motorLastSentMs = 0;
static uint32_t webSocketCommandCount = 0;
static String webSocketLastCommand;
static uint32_t webSocketControlCount = 0;
static String webSocketLastControlCommand;
static uint32_t motorControlQueued = 0;
static uint32_t motorControlTxLines = 0;
static String motorLastControlQueued;
static String motorLastControlSent;
static unsigned long motorLastControlSentMs = 0;

static unsigned long encoderLastMoveMs = 0;
static long encoderLastValueForWatchdog = 0;
static bool encoderWatchdogStopSent = false;
static bool motorWatchdogArmed = false;

static unsigned long lastMotorPollMs = 0;
static const unsigned long MOTOR_POLL_INTERVAL_MS = 2000;
static const unsigned long MOTOR_STALE_MS = 4000;

// Parametri per GOTOPOS
const uint32_t MOTOR_FAST_HZ = 12000;

// Closed-loop scan speed control (compensates for spool diameter growth)
// Target 2 cm/s: motor runs smoothly at ~1500 Hz (low speed cogging causes caliper noise)
const float    TARGET_SCAN_SPEED_CMS = 2.0f;   // target linear speed during scan (cm/s)
const uint32_t SCAN_HZ_INIT = 1500;            // initial estimate (calibrated: 1500 Hz ≈ 2 cm/s)
const uint32_t SCAN_HZ_MIN  = 800;             // never go below ~1 cm/s — avoids cogging zone
const uint32_t SCAN_HZ_MAX  = 4000;            // headroom for spool growth compensation
uint32_t currentScanHz = SCAN_HZ_INIT;
bool isGoToActive = false;
float goToTargetCm = 0;
bool goToFwd = true;                  // direction of current GOTOPOS move (saved for overshoot guard)
unsigned long lastGoToStatusCheck = 0;
bool goToEncoderReached = false;  // set when encoder reaches target; used to send completed:true
static unsigned long lastPosSentMs = 0;  // throttle POS:<steps> updates to slave

struct DataPoint {
  int cm;         // corrected actual position (encoder-diameter compensated), cm
  int encoderCm;  // raw encoder position (used by GOTOPOS for slave command lookup)
  float diameter;
  float rawDisplay;
  DataPoint* next;
};

DataPoint* firstDataPoint = nullptr;
DataPoint* lastDataPoint = nullptr;
int totalDataPoints = 0;

// ── PCNT hardware encoder ──────────────────────────────────────────────────
// The ESP32 PCNT peripheral counts quadrature pulses in hardware, completely
// unaffected by caliper ISR activity that caused software-ISR miscounts.
#define PCNT_ENC_UNIT PCNT_UNIT_0
#define PCNT_H_LIM  30000  // ~1000 cm per overflow at PPC=30
#define PCNT_L_LIM -30000
static volatile long pcntAccum = 0;  // 32-bit overflow accumulator

static long getEncoderValue() {
  // Re-read until accumulator is stable across the PCNT snapshot
  long acc, acc2;
  int16_t cnt;
  do {
    acc = pcntAccum;
    pcnt_get_counter_value(PCNT_ENC_UNIT, &cnt);
    acc2 = pcntAccum;
  } while (acc != acc2);
  return acc + cnt;
}

static void setEncoderValue(long v) {
  pcnt_counter_pause(PCNT_ENC_UNIT);
  pcnt_counter_clear(PCNT_ENC_UNIT);
  pcntAccum = v;
  pcnt_counter_resume(PCNT_ENC_UNIT);
}

static void IRAM_ATTR pcntOverflowISR(void* arg) {
  uint32_t status;
  pcnt_get_event_status(PCNT_ENC_UNIT, &status);
  if (status & PCNT_EVT_H_LIM) pcntAccum += PCNT_H_LIM;
  if (status & PCNT_EVT_L_LIM) pcntAccum += PCNT_L_LIM;
}

static void setupPCNT() {
  pcnt_config_t cfg = {};
  cfg.pulse_gpio_num = ENCODER_DATA_PIN;   // A phase
  cfg.ctrl_gpio_num  = ENCODER_CLOCK_PIN;  // B phase (direction control)
  cfg.lctrl_mode = PCNT_MODE_KEEP;         // B=0: count normally
  cfg.hctrl_mode = PCNT_MODE_DISABLE;      // B=1: do not count (1x decoding)
  cfg.neg_mode   = PCNT_COUNT_INC;         // A falling + B=0 → forward (+)
  cfg.pos_mode   = PCNT_COUNT_DEC;         // A rising  + B=0 → reverse (-)
  cfg.counter_h_lim = PCNT_H_LIM;
  cfg.counter_l_lim = PCNT_L_LIM;
  cfg.unit    = PCNT_ENC_UNIT;
  cfg.channel = PCNT_CHANNEL_0;
  pcnt_unit_config(&cfg);
  pcnt_counter_pause(PCNT_ENC_UNIT);
  pcnt_counter_clear(PCNT_ENC_UNIT);
  pcnt_event_enable(PCNT_ENC_UNIT, PCNT_EVT_H_LIM);
  pcnt_event_enable(PCNT_ENC_UNIT, PCNT_EVT_L_LIM);
  pcnt_isr_service_install(0);
  pcnt_isr_handler_add(PCNT_ENC_UNIT, pcntOverflowISR, nullptr);
  pcnt_counter_resume(PCNT_ENC_UNIT);
}

// Runtime-calibrated PPC: set once via 'calibrate:<cm>' command, stored in EEPROM.
// When 0 (or invalid), getActivePpc() returns the formula value (PULSES_PER_CM).
static float calibratedPpc = 0.0f;
static long  calStartEncoder = 0;  // encoder snapshot at last resetpos — baseline for calibration

// Caliper ISR state — written only in onCaliperChange(), read under noInterrupts()
volatile long  calBitAccum   = 0;
volatile int   calSignAccum  = 1;
volatile int   calBitCount   = 0;
volatile long  calRawValue   = 0;
volatile int   calSign       = 1;
volatile bool  calDataReady  = false;
volatile unsigned long calRiseUs = 0;
// RB2: contatori diagnostici calibro (comando caldiag / pulsante "Diagnosi Calibro")
volatile unsigned long calDiagEdges   = 0;  // fronti sul CLOCK
volatile unsigned long calDiagGaps    = 0;  // pause >500 us (inizio pacchetto)
volatile unsigned long calDiagPackets = 0;  // pacchetti da 24 bit accettati
volatile int           calDiagLastBits = 0; // bit contati prima dell'ultima pausa

float caliperZeroOffset = 0.0;
float displayZeroValue = 0.0;
int lastCm = -1;

// Encoder-diameter position correction accumulator.
// Each encoder-cm tick advances actualPositionCm by (C_eff/20) where
// C_eff = 20 - π × d_mm/10  (larger line diameter → smaller effective circumference → less actual travel).
float actualPositionCm = 0.0f;

// Encoder-based cm target kept for the GOTOPOS overshoot guard (raw encoder units).
float goToTargetEncoderCm = 0.0f;

// Rolling caliper buffer — filled non-blocking every main loop iteration.
// Replaces blocking readCaliperMedian: no loop stall, no missed cm steps.
#define CAL_BUF_SIZE 7
float calRollingBuf[CAL_BUF_SIZE];
int   calRollingCount = 0;   // how many valid entries (capped at CAL_BUF_SIZE)
int   calRollingIdx   = 0;   // next write position (circular)

unsigned long lastSpeedTime = 0;
long lastSpeedEncoder = 0;
float currentSpeed = 0.0;

WiFiManager wifiManager;
WebServer server(80);
WebSocketsServer webSocket(81);

// Forward declarations
void readCaliper();
void pumpCaliper();
float readCaliperBufferedMedian();
float readCaliperAverage(int samples = 3);
float readCaliperMedian(int samples = 5);
float readCaliperDisplay();
void handleCommand(String cmd);
void sendParamsToClients();
void calculateSpeed();
void addDataPoint(int cm, int encoderCm, float diameter, float rawDisplay);
void clearAllData();
int getTotalDataPoints();
void setDisplayZero();
void motorQueueTx(const String& lineNoNewline);
void motorPumpTx();
void motorPumpRx();
void armMotorWatchdog();
void motorPollIfNeeded();
void motorHandleStatusLine(const char* line);
void motorHandleDiagLine(char* line);
void goToPosition(float targetCm);
void checkGoToStatus();

// Returns the active pulses-per-cm value: calibrated (from EEPROM) if valid, formula otherwise.
inline float getActivePpc() {
  return (calibratedPpc >= 5.0f && calibratedPpc <= 500.0f) ? calibratedPpc : (float)PULSES_PER_CM;
}

// -----------------------------
void addDataPoint(int cm, int encoderCm, float diameter, float rawDisplay) {
  DataPoint* newPoint = new DataPoint();
  if (!newPoint) { Serial.println("[OOM] DataPoint alloc failed"); return; }  // FW-11
  newPoint->cm = cm;
  newPoint->encoderCm = encoderCm;
  newPoint->diameter = roundf(diameter * 100.0f) / 100.0f;  // clamp to caliper precision: 0.01 mm
  newPoint->rawDisplay = rawDisplay;
  newPoint->next = nullptr;

  if (firstDataPoint == nullptr) {
    firstDataPoint = newPoint;
    lastDataPoint = newPoint;
  } else {
    DataPoint* current = firstDataPoint;
    DataPoint* prev = nullptr;
    while (current != nullptr) {
      if (current->cm == cm) {
        current->diameter = newPoint->diameter;  // FW-04: use EMA-smoothed value, not raw
        current->rawDisplay = rawDisplay;
        delete newPoint;
        return;
      }
      if (current->cm > cm) {
        newPoint->next = current;
        if (prev == nullptr) firstDataPoint = newPoint;
        else prev->next = newPoint;
        totalDataPoints++;
        return;
      }
      prev = current;
      current = current->next;
    }
    lastDataPoint->next = newPoint;
    lastDataPoint = newPoint;
  }
  totalDataPoints++;
}

void clearAllData() {
  DataPoint* current = firstDataPoint;
  while (current != nullptr) {
    DataPoint* next = current->next;
    delete current;
    current = next;
  }
  firstDataPoint = nullptr;
  lastDataPoint = nullptr;
  totalDataPoints = 0;
  filterInitialized = false;
  smoothedDiameter = 0.0;
  calRollingCount = 0;
  calRollingIdx   = 0;
  actualPositionCm = 0.0f;
}

int getTotalDataPoints() {
  return totalDataPoints;
}


// Caliper ISR — mirrors the original blocking logic but fully non-blocking.
// Triggers on every CHANGE of CALIPER_CLOCK_PIN:
//   Rising edge  → record timestamp.
//   Falling edge → measure HIGH duration; if >500 µs it was the inter-packet gap,
//                  commit the completed 24-bit word, then read the new data bit.
void IRAM_ATTR onCaliperChange() {
  unsigned long now = micros();
  calDiagEdges++;
  if (digitalRead(CALIPER_CLOCK_PIN)) {
    // Rising edge
    calRiseUs = now;
  } else {
    // Falling edge
    unsigned long highDur = now - calRiseUs;
    if (highDur > 500) {
      calDiagGaps++;
      calDiagLastBits = calBitCount;
      // Inter-packet gap detected — commit if we collected exactly 24 bits
      if (calBitCount == 24) {
        calDiagPackets++;
        calRawValue  = calBitAccum;
        calSign      = calSignAccum;
        calDataReady = true;
      }
      calBitAccum  = 0;
      calSignAccum = 1;
      calBitCount  = 0;
    }
    // Read data bit at falling edge (same timing as original blocking code)
    if (calBitCount < 24) {
      if (digitalRead(CALIPER_DATA_PIN)) {
        if      (calBitCount < 20)  calBitAccum |= (1L << calBitCount);
        else if (calBitCount == 20) calSignAccum = -1;
      }
      calBitCount++;
    }
  }
}

void motorQueueTx(const String& lineNoNewline) {
    // Drop low-priority messages if a real command is already waiting
    if (motorTxHasPending && lineNoNewline == "STATUS?") return;
    if (motorTxHasPending && lineNoNewline.startsWith("POS:")) return;
    if (motorTxHasPending && lineNoNewline.startsWith("SETHZ:")) return;  // speed trim — next one will get through
    motorTxPending = lineNoNewline + "\n";
    motorTxHasPending = true;
    motorTxQueued++;
    motorLastQueued = lineNoNewline;
    if (lineNoNewline != "STATUS?" &&
        !lineNoNewline.startsWith("POS:") &&
        !lineNoNewline.startsWith("SETHZ:")) {
      motorControlQueued++;
      motorLastControlQueued = lineNoNewline;
    }
}

void motorPumpTx() {
  if (!motorTxHasPending) return;
  int freeBytes = SerialMotor.availableForWrite();
  if (freeBytes >= (int)motorTxPending.length()) {
    SerialMotor.print(motorTxPending);
    motorTxLines++;
    motorLastSent = motorTxPending;
    motorLastSent.trim();
    motorLastSentMs = millis();
    if (motorLastSent != "STATUS?" &&
        !motorLastSent.startsWith("POS:") &&
        !motorLastSent.startsWith("SETHZ:")) {
      motorControlTxLines++;
      motorLastControlSent = motorLastSent;
      motorLastControlSentMs = motorLastSentMs;
    }
    motorTxHasPending = false;
  }
}

void armMotorWatchdog() {
  encoderLastValueForWatchdog = getEncoderValue();
  encoderLastMoveMs = millis();
  encoderWatchdogStopSent = false;
  motorWatchdogArmed = true;
}

void motorHandleStatusLine(const char* line) {
  if (strncmp(line, "STATUS:", 7) != 0) return;
  
  const char* p = line + 7;
  const char* colon = strchr(p, ':');
  if (!colon) return;
  motorStatusLines++;
  
  String newMode = String(p).substring(0, colon - p);
  motorMode = newMode;
  if (motorMode == "STOP") {
    motorWatchdogArmed = false;
  } else if ((motorMode == "SCAN" || motorMode == "FAST_S" || motorMode == "FAST_O") &&
             !motorWatchdogArmed) {
    armMotorWatchdog();
  }

  // FW-12: parse direction field only (stop before the next colon that carries remaining steps)
  const char* dirStart = colon + 1;
  const char* colon2 = strchr(dirStart, ':');
  if (colon2) {
    motorDir = String(dirStart).substring(0, colon2 - dirStart);
  } else {
    motorDir = String(dirStart);
  }

  // Gestione GOTOPOS
  if (motorMode == "GOTOPOS") {
    isGoToActive = true;
    if (colon2) {
      int remaining = atoi(colon2 + 1);
      if (remaining == 0) {
        // FW-03: slave sent STATUS:GOTOPOS:DIR:0 before calling stopMotion() → confirmed arrival
        isGoToActive = false;
        scanEnabled = oldScanState;
        oldScanState = false;
        Serial.println("GOTOPOS completato!");
        // FW-13: broadcast restored scan state so clients stay in sync
        String scanJson = "{\"type\":\"scan_enabled\",\"value\":" + String(scanEnabled ? "true" : "false") + "}";
        webSocket.broadcastTXT(scanJson);
        float finalCm = (float)getEncoderValue() / getActivePpc() - 2.0f;
        String json = "{\"type\":\"goto_status\",\"active\":false,\"completed\":true,\"final_cm\":" + String(finalCm, 1) + "}";
      } else {
        // Invia stato di avanzamento al client
        int currentCm = (int)(getEncoderValue() / getActivePpc()) - 2;
        int remainingCm = (int)(remaining / getActivePpc());
        String json = "{\"type\":\"goto_progress\",\"remaining_cm\":" + String(remainingCm) + 
                     ",\"current_cm\":" + String(currentCm) + ",\"target_cm\":" + String(goToTargetCm) + "}";
        webSocket.broadcastTXT(json);
      }
    }
  } else if (motorMode == "STOP") {
    if (isGoToActive) {
      isGoToActive = false;
      scanEnabled = oldScanState;
      oldScanState = false;
      // FW-13: broadcast restored scan state
      String scanJson = "{\"type\":\"scan_enabled\",\"value\":" + String(scanEnabled ? "true" : "false") + "}";
      webSocket.broadcastTXT(scanJson);
      // Use goToEncoderReached so encoder-based stops report completed:true
      float finalCm = (float)getEncoderValue() / getActivePpc() - 2.0f;
      String json = "{\"type\":\"goto_status\",\"active\":false,\"completed\":" +
                    String(goToEncoderReached ? "true" : "false") + ",\"final_cm\":" + String(finalCm, 1) + ",\"reason\":\"stopped\"}";
      webSocket.broadcastTXT(json);
      goToEncoderReached = false;
    }
  }
  
  motorLastSeenMs = millis();
  String json = "{\"type\":\"motor\",\"mode\":\"" + motorMode + "\",\"dir\":\"" + motorDir + "\"}";
  webSocket.broadcastTXT(json);
}

void motorHandleDiagLine(char* line) {
  if (strncmp(line, "UARTDIAG:", 9) != 0) return;

  char* field = line + 9;
  char* separator = strchr(field, ':');
  if (!separator) return;
  *separator = '\0';
  slaveUartRxBytes = (uint32_t)strtoul(field, nullptr, 10);

  field = separator + 1;
  separator = strchr(field, ':');
  if (!separator) return;
  *separator = '\0';
  slaveUartRxLines = (uint32_t)strtoul(field, nullptr, 10);

  field = separator + 1;
  separator = strchr(field, ':');
  if (!separator) return;
  *separator = '\0';
  slaveUartRxCommands = (uint32_t)strtoul(field, nullptr, 10);
  field = separator + 1;
  separator = strchr(field, ':');
  if (!separator) return;
  *separator = '\0';
  slaveLastControlCommand = field;
  slaveDiagIp = separator + 1;
}

void motorPumpRx() {
  while (SerialMotor.available() > 0) {
    char c = (char)SerialMotor.read();
    motorRxBytes++;
    if (c == '\r') continue;
    if (c == '\n') {
      motorRxLine[motorRxLen] = '\0';
      if (motorRxLen > 0) {
        motorRxLines++;
        if (strncmp(motorRxLine, "UARTDIAG:", 9) == 0)
          motorHandleDiagLine(motorRxLine);
        else
          motorHandleStatusLine(motorRxLine);
      }
      motorRxLen = 0;
      continue;
    }
    if (motorRxLen < sizeof(motorRxLine) - 1) motorRxLine[motorRxLen++] = c;
    else motorRxLen = 0;
  }
}

void motorPollIfNeeded() {
  unsigned long now = millis();
  bool stale = (motorLastSeenMs == 0) || (now - motorLastSeenMs > MOTOR_STALE_MS);
  if (stale && (now - lastMotorPollMs > MOTOR_POLL_INTERVAL_MS)) {
    motorQueueTx("STATUS?");
    lastMotorPollMs = now;
    String json = "{\"type\":\"motor\",\"mode\":\"OFFLINE\",\"dir\":\"--\"}";
    webSocket.broadcastTXT(json);
  }
}

void checkGoToStatus() {
  if (!isGoToActive) return;
  
  unsigned long now = millis();
  if (now - lastGoToStatusCheck > 500) {  // Ogni 500ms
    lastGoToStatusCheck = now;
    motorQueueTx("STATUS?");
  }
}

// ----------------------------- GOTOPOS Function -----------------------------
void goToPosition(float targetCm) {
  if (isGoToActive) return;  // FW-08: prevent re-entrant call from WebSocket corrupting oldScanState
  motorWatchdogArmed = false;
  if (targetCm < 0) {
    Serial.println("ERRORE: Target non valido");
    return;
  }

  float currentCm = (float)getEncoderValue() / getActivePpc() - 2.0f;  // encoder-based actual position
  
  // Se già a target
  if (abs(targetCm - currentCm) < 0.1) {
    Serial.println("Già alla posizione target");
    return;
  }

  // Salva stato scansione e sospendi
  oldScanState = scanEnabled;
  scanEnabled = false;
  // Notify all clients that scan is suspended (symmetric with restore broadcast on completion)
  webSocket.broadcastTXT("{\"type\":\"scan_enabled\",\"value\":false}");
  
  // Determina la direzione
  bool direction = (targetCm > currentCm);
  
  // Look up encoder-based position for the target actual-cm.
  // Scan data stores both: cm (actual, corrected) and encoderCm (raw encoder ticks / PULSES_PER_CM).
  // Default fallback: treat targetCm as encoder cm (works when no data or first use).
  float targetEncoderCm = targetCm;
  if (firstDataPoint != nullptr) {
    DataPoint* best = firstDataPoint;
    float bestDiff = abs((float)best->cm - targetCm);
    for (DataPoint* p = firstDataPoint->next; p != nullptr; p = p->next) {
      float diff = abs((float)p->cm - targetCm);
      if (diff < bestDiff) {
        bestDiff = diff;
        best = p;
      }
    }
    targetEncoderCm = (float)best->encoderCm;
    Serial.print("GOTOPOS lookup: actual ");
    Serial.print(targetCm, 1);
    Serial.print(" cm → encoder ");
    Serial.print(targetEncoderCm, 1);
    Serial.println(" cm");
  }

  // goToTargetEncoderCm is used by the overshoot guard (floatCm is encoder-based)
  goToTargetEncoderCm = targetEncoderCm;

  // Send GOTOPOS to slave. Add the +2 cm encoder offset (encoder wheel is 20 mm behind caliper).
  long encNow = getEncoderValue();
  String cmd = "GOTOPOS:" + String(targetEncoderCm + 2.0f, 2) + ":" + String(MOTOR_FAST_HZ) + ":" + String(encNow) + ":" + (direction ? "F" : "B");
  motorQueueTx(cmd);
  
  goToTargetCm = targetCm;
  goToFwd = direction;
  isGoToActive = true;
  goToEncoderReached = false;
  lastGoToStatusCheck = 0;
  lastPosSentMs = 0;  // send first POS update immediately
  
  Serial.print("GOTOPOS avviato verso ");
  Serial.print(targetCm, 2);
  Serial.print(" cm (posizione attuale: ");
  Serial.print(currentCm, 2);
  Serial.println(" cm)");
  
  // Notifica il client web
  String json = "{\"type\":\"goto_status\",\"active\":true,\"target\":" + String(targetCm, 2) + 
                ",\"current\":" + String(currentCm, 2) + "}";
  webSocket.broadcastTXT(json);
}

// -----------------------------
void setup() {
  Serial.begin(115200);
  EEPROM.begin(EEPROM_SIZE);

  SerialMotor.begin(115200, SERIAL_8N1, MOTOR_UART_RX_PIN, MOTOR_UART_TX_PIN);
  motorQueueTx("STATUS?");

  pinMode(ENCODER_DATA_PIN, INPUT_PULLUP);
  pinMode(ENCODER_CLOCK_PIN, INPUT_PULLUP);
  pinMode(CALIPER_CLOCK_PIN, INPUT);
  pinMode(CALIPER_DATA_PIN, INPUT);

  setupPCNT();  // Hardware pulse counter for encoder — replaces software ISR
  attachInterrupt(digitalPinToInterrupt(CALIPER_CLOCK_PIN), onCaliperChange, CHANGE);

  EEPROM.get(0, caliperZeroOffset);
  if (isnan(caliperZeroOffset)) caliperZeroOffset = 0.0;

  EEPROM.get(EEPROM_ADDR_CALIB_PPC, calibratedPpc);
  if (isnan(calibratedPpc) || calibratedPpc < 5.0f || calibratedPpc > 500.0f) calibratedPpc = 0.0f;
  // Align encoder init value to calibrated PPC so display starts at 0 cm
  setEncoderValue((long)ceilf(2.0f * getActivePpc()));
  calStartEncoder = getEncoderValue();
  Serial.print("PPC attivo: ");
  Serial.println(getActivePpc(), 4);
  Serial.print("PCNT encoder HW attivo (ticks iniziali): ");
  Serial.println(getEncoderValue());

  lastSpeedTime = millis();
  lastSpeedEncoder = getEncoderValue();

  Serial.println("\n=== WiFi Manager v2.3.0 ===");
  pinMode(WIFI_RESET_PIN, INPUT_PULLUP);
  if (digitalRead(WIFI_RESET_PIN) == LOW) {
    Serial.println("Reset WiFi!");
    wifiManager.resetSettings();
    delay(1000);
  }
  wifiManager.setConfigPortalTimeout(180);
  wifiManager.setAPCallback([](WiFiManager* m) {
    Serial.println("AP: " + String(m->getConfigPortalSSID()));
    Serial.println("Pwd: 12345678 | IP: 192.168.4.1");
  });
  if (!wifiManager.autoConnect("DiametroLinea_Setup", "12345678")) {
    Serial.println("Timeout!");
    delay(3000);
    ESP.restart();
  }
  Serial.println("\nWiFi OK! IP: " + WiFi.localIP().toString());

  server.on("/", []() {
    server.setContentLength(CONTENT_LENGTH_UNKNOWN);
    server.send(200, "text/html", "");
    server.sendContent(R"rawliteral(
<!DOCTYPE html>
<html>
<head>
    <meta charset="UTF-8">
    <title>Sistema Monitoraggio Diametro Linea</title>
    <script src="https://cdn.jsdelivr.net/npm/chart.js"></script>
    <script src="https://cdn.jsdelivr.net/npm/chartjs-plugin-zoom@2.0.1/dist/chartjs-plugin-zoom.min.js"></script>
    <style>
        * { box-sizing: border-box; }
        body { font-family: Arial, sans-serif; margin: 20px; background-color: #f5f5f5; }
        .container { max-width: 1200px; margin: 0 auto; background: white; padding: 20px; border-radius: 10px; box-shadow: 0 2px 10px rgba(0,0,0,0.1); }
        .header { text-align: center; margin-bottom: 18px; padding-bottom: 14px; border-bottom: 2px solid #eee; }
        .header h1 { margin: 0 0 4px; font-size: 1.5em; color: #222; }
        .status-panel { display: flex; flex-wrap: wrap; gap: 8px; justify-content: space-between; margin-bottom: 14px; padding: 12px 16px; background: #f8f9fa; border-radius: 8px; }
        .status-item { text-align: center; min-width: 110px; }
        .status-value { font-size: 1.2em; font-weight: bold; color: #007bff; }
        .status-item .speed-optimal { color: #28a745; font-weight: bold; }
        .status-item .speed-too-slow { color: #ffc107; font-weight: bold; }
        .status-item .speed-too-fast { color: #dc3545; font-weight: bold; }
        .display-info { background: #e8f4f8; padding: 8px 14px; border-radius: 5px; margin: 10px 0; font-size: 0.9em; display: flex; flex-wrap: wrap; gap: 14px; align-items: center; }
        .scan-timer { font-family: monospace; font-weight: bold; }
        .motor-bar { display: flex; flex-wrap: wrap; gap: 6px; align-items: center; padding: 10px 14px; background: #f8f9fa; border-radius: 8px; margin-bottom: 10px; border: 1px solid #dee2e6; }
        .motor-bar-title { font-weight: bold; font-size: 0.9em; color: #333; margin-right: 4px; }
        .chart-wrapper { position: relative; margin-bottom: 10px; }
        .chart-container { position: relative; height: 500px; border: 1px solid #ddd; border-radius: 5px; background: white; }
        .chart-controls { display: flex; justify-content: center; align-items: center; margin-top: 8px; padding: 8px; background: #f8f9fa; border-radius: 5px; }
        .zoom-controls { display: flex; gap: 10px; }
        .accordion { border: 1px solid #dee2e6; border-radius: 6px; overflow: hidden; margin-bottom: 8px; }
        .accordion-header { display: flex; justify-content: space-between; align-items: center; padding: 10px 16px; background: #f0f4f8; cursor: pointer; user-select: none; font-weight: bold; font-size: 0.95em; color: #333; border: none; width: 100%; text-align: left; transition: background 0.15s; }
        .accordion-header:hover { background: #e2eaf2; }
        .accordion-arrow { font-size: 0.85em; color: #666; transition: transform 0.2s; display: inline-block; }
        .accordion-header.acc-open .accordion-arrow { transform: rotate(180deg); }
        .accordion-body { padding: 14px 16px; background: white; display: none; }
        .accordion-body.acc-open { display: block; }
        button { padding: 8px 16px; margin: 5px; background: #007bff; color: white; border: none; border-radius: 5px; cursor: pointer; font-size: 14px; }
        button:hover { background: #0056b3; }
        button.danger { background: #dc3545; } button.danger:hover { background: #c82333; }
        button.success { background: #28a745; } button.success:hover { background: #218838; }
        button.warning { background: #ffc107; color: #212529; } button.warning:hover { background: #e0a800; }
        .auto-control { display: inline-block; margin: 0 10px; }
        .auto-control input { padding: 8px; margin: 0 5px; border: 1px solid #ddd; border-radius: 4px; width: 80px; }
        .param-display { display: inline-block; margin: 0 15px; padding: 5px 10px; background: #e9ecef; border-radius: 4px; font-family: monospace; }
        .upload-section { margin: 10px 0; padding: 15px; background: #f8f9fa; border-radius: 8px; border: 2px dashed #dee2e6; }
        .upload-area { text-align: center; padding: 10px; }
        .file-input { margin: 10px 0; }
        .upload-info { margin-top: 10px; font-size: 0.9em; color: #6c757d; }
        .dataset-controls { display: flex; gap: 10px; justify-content: center; margin-top: 10px; }
        .dataset-list { margin-top: 10px; max-height: 200px; overflow-y: auto; border: 1px solid #ddd; border-radius: 5px; padding: 10px; background: white; }
        .dataset-item { display: flex; justify-content: space-between; align-items: center; padding: 5px; margin: 2px 0; border-radius: 3px; background: #f8f9fa; }
        .dataset-item:hover { background: #e9ecef; }
        .dataset-color { width: 20px; height: 20px; border-radius: 3px; margin-right: 10px; }
        .dataset-name { flex-grow: 1; font-size: 0.9em; }
        .color-palette { display: flex; gap: 5px; margin: 10px 0; flex-wrap: wrap; }
        .color-option { width: 25px; height: 25px; border-radius: 3px; cursor: pointer; border: 2px solid transparent; }
        .color-option.selected { border-color: #000; }
        .info-badge { display: inline-block; padding: 2px 8px; background: #007bff; color: white; border-radius: 12px; font-size: 0.85em; margin-left: 10px; }
        .calib-grid { display: flex; flex-wrap: wrap; gap: 20px; }
        .calib-col { flex: 1; min-width: 200px; }
        .calib-col h4 { margin: 0 0 10px; color: #555; font-size: 0.9em; text-transform: uppercase; letter-spacing: 0.04em; }
        .footer-info { margin-top: 20px; text-align: center; color: #666; }
        .modal {
            display: none;
            position: fixed;
            z-index: 1000;
            left: 0;
            top: 0;
            width: 100%;
            height: 100%;
            background-color: rgba(0,0,0,0.5);
        }
        .modal-content {
            background-color: white;
            margin: 15% auto;
            padding: 20px;
            border-radius: 8px;
            width: 300px;
            text-align: center;
        }
        .modal-content input {
            padding: 8px;
            margin: 10px 0;
            width: 90%;
            border: 1px solid #ddd;
            border-radius: 4px;
        }
        .modal-buttons {
            display: flex;
            gap: 10px;
            justify-content: center;
        }
        .goto-progress {
            background: #e3f2fd;
            padding: 5px 10px;
            border-radius: 4px;
            font-size: 0.85em;
        }
    </style>
</head>
<body>
<div class="container">

    <div class="header">
        <h1>Sistema Monitoraggio Diametro Linea <span class="info-badge">CALIBRO FISSO</span></h1>
    </div>

    <div class="status-panel">
        <div class="status-item">
            <div>Lunghezza Attuale</div>
            <div class="status-value" id="currentLength">0 cm</div>
        </div>
        <div class="status-item">
            <div>Diametro Compensato</div>
            <div class="status-value" id="currentDiameter">0.00 mm</div>
        </div>
        <div class="status-item">
            <div>Display Calibro</div>
            <div class="status-value" id="currentDisplay">0.00 mm</div>
        </div>
        <div class="status-item">
            <div>Velocit&agrave;</div>
            <div class="status-value" id="currentSpeed">0.00 cm/s</div>
        </div>
        <div class="status-item">
            <div>Stato Velocit&agrave;</div>
            <div class="status-value" id="speedStatus">Ottimale</div>
        </div>
        <div class="status-item">
            <div>Punti Registrati</div>
            <div class="status-value" id="dataPointsCount">0</div>
        </div>
        <div class="status-item">
            <div>Stato Connessione</div>
            <div class="status-value" id="connectionStatus">Connesso</div>
        </div>
    </div>

    <div class="display-info">
        <strong>Configurazione:</strong> Calibro fisso (punto di misura 20mm dietro encoder) |
        <strong>Zero Display:</strong> <span id="displayZeroValue">0.00</span> mm |
        <strong>Offset:</strong> <span id="currentOffset">0.00</span> mm |
        <strong>Motore:</strong> <span id="motorState">--</span> |
        <strong>Timer:</strong> <span class="scan-timer" id="scanTimer">00:00</span>
        <span id="gotoProgress" class="goto-progress" style="display:none;"></span>
    </div>

    <div class="motor-bar">
        <span class="motor-bar-title">&#x1F527; Motore</span>
        <button class="success" onclick="startScan()">START SCAN</button>
        <button class="danger" onclick="stopScan()">STOP</button>
        <button id="btnScanEnable" class="danger" onclick="toggleScanEnable()">&#9208; Ricezione OFF</button>
        <button class="warning" onclick="sendCommand('motor fast_s')">FAST stessa dir</button>
        <button class="warning" onclick="sendCommand('motor fast_o')">FAST opposta dir</button>
        <button onclick="sendCommand('motor status')">Aggiorna Stato</button>
        <button onclick="showGoToDialog()" style="background: #6c757d;">🎯 Vai a posizione</button>
    </div>

    <div class="chart-wrapper">
        <div class="chart-container">
            <canvas id="lineChart"></canvas>
        </div>
        <div class="chart-controls">
            <div class="zoom-controls">
                <button onclick="zoomIn()">Zoom +</button>
                <button onclick="zoomOut()">Zoom -</button>
                <button onclick="resetZoom()">Reset Zoom</button>
                <button onclick="userHasZoomed=false; fitToData()">Adatta ai Dati</button>
            </div>
        </div>
    </div>

    <div class="accordion">
        <button class="accordion-header acc-open" onclick="accToggle(this)">
            &#x1F4CA; Grafico &amp; Dati <span class="accordion-arrow">&#x25BC;</span>
        </button>
        <div class="accordion-body acc-open">
            <label>Smoothing level (0=raw, 10=max):
            <input type="range" id="smoothAlpha" min="0" max="10" step="1" value="0"
                oninput="document.getElementById('alphaVal').textContent=this.value; redrawLiveSmoothing()">
            <span id="alphaVal">0</span>
            </label>
            <button onclick="resetChart()">Reset Grafico</button>
            <button onclick="exportCurrentScan()">Esporta Scansione</button>
            <button onclick="exportAllDatasets()">Esporta Tutti i Dataset</button>
            <button onclick="exportChartPng()">Esporta PNG</button>
            <button onclick="toggleAutoScale()">Auto-Fit: <span id="autoScaleStatus">ON</span></button>
            <button class="danger" onclick="sendCommand('reset')">Reset Lunghezza e Dati</button>
        </div>
    </div>

    <div class="accordion">
        <button class="accordion-header" onclick="accToggle(this)">
            &#x1F4C2; Carica &amp; Confronta CSV <span class="accordion-arrow">&#x25BC;</span>
        </button>
        <div class="accordion-body">
            <div class="upload-section">
                <div class="upload-area">
                    <input type="file" id="csvFile" accept=".csv" class="file-input"><br>
                    <input type="text" id="datasetName" placeholder="Nome dataset" style="padding:8px;margin:5px;border:1px solid #ddd;border-radius:4px;width:200px;">
                    <div class="color-palette" id="colorPalette"></div>
                    <button onclick="uploadCSV()" class="success">Carica CSV</button>
                    <button onclick="clearAllDatasets()" class="danger">Rimuovi Tutti</button>
                    <div class="dataset-list" id="datasetList"></div>
                    <div class="upload-info">
                        Formati supportati:<br>
                        - Con header: "Dataset,Lunghezza (cm),Diametro (mm)"<br>
                        - Con header: "Lunghezza (cm),Diametro (mm)"<br>
                        - Senza header: "0.0,0.000"<br>
                        Prima riga: "0,0.000" (punto zero)
                    </div>
                </div>
            </div>
        </div>
    </div>

    <div class="accordion">
        <button class="accordion-header" onclick="accToggle(this)">
            &#x2699;&#xFE0F; Calibrazione &amp; Sistema <span class="accordion-arrow">&#x25BC;</span>
        </button>
        <div class="accordion-body">
            <div class="calib-grid">
                <div class="calib-col">
                    <h4>Offset Calibro</h4>
                    <div class="auto-control">
                        <input type="number" id="offsetValue" placeholder="offset mm" step="0.01">
                        <button onclick="setOffset()">Imposta Offset</button>
                    </div>
                    <button onclick="sendCommand('resetoffset')">Resetta Offset a 0</button>
                    <div style="margin-top:12px;">
                        <span>Zero Display: </span>
                        <span class="param-display" id="currentDisplayZero">0.00</span>
                        <span> mm &nbsp;|&nbsp; Offset: </span>
                        <span class="param-display" id="currentOffsetValue">0.00</span>
                        <span> mm</span>
                    </div>
                </div>
                <div class="calib-col">
                    <h4>Calibro</h4>
                    <button onclick="sendCommand('readraw')">Lettura Display Calibro</button>
                    <button onclick="sendCommand('caldiag')">Diagnosi Calibro</button>
                    <button onclick="sendCommand('setdisplayzero')">Imposta Zero da Display</button>
                </div>
                <div class="calib-col">
                    <h4>Calibrazione Encoder</h4>
                    <p style="font-size:12px;margin:0 0 8px 0;color:#aaa;">
                        1&hairsp;. Premi <strong>Reset Posizione</strong><br>
                        2&hairsp;. Estrai esattamente N cm di linea con un metro<br>
                        3&hairsp;. Inserisci N e premi <strong>Calibra</strong>
                    </p>
                    <button onclick="sendCommand('resetpos')">1. Reset Posizione</button>
                    <div class="auto-control" style="margin-top:6px;">
                        <input type="number" id="calibKnownCm" placeholder="cm noti" step="1" min="10" style="width:90px">
                        <button onclick="doCalibratePpc()">3. Calibra</button>
                    </div>
                    <button onclick="sendCommand('calibrate_reset')" style="margin-top:6px;">Ripristina formula</button>
                    <div class="auto-control" style="margin-top:8px;">
                        <input type="number" id="manualPpcInput" placeholder="PPC manuale" step="0.001" min="5" max="500" style="width:110px">
                        <button onclick="doSetPpc()">Imposta PPC</button>
                    </div>
                    <p style="font-size:11px;margin:4px 0 0 0;color:#aaa;">
                        Fine tune: <strong>PPC_nuovo = PPC_attivo × display_cm / reale_cm</strong>
                    </p>
                    <div style="margin-top:8px;font-size:12px;">
                        PPC attivo: <span class="param-display" id="ppcActiveValue">--</span>
                        <span id="ppcSource" style="color:#aaa;margin-left:4px;">(formula)</span>
                    </div>
                </div>
            </div>
        </div>
    </div>

    <div class="footer-info">
        <p>Ultimo aggiornamento: <span id="lastUpdate">--</span></p>
        <p id="commandStatus"></p>
        <hr style="border:none;border-top:1px solid #ddd;margin:15px 0;">
        <p style="font-size:0.85em;color:#999;">
            <strong>Sistema Monitoraggio Diametro Linea</strong><br>
            Versione <strong>)rawliteral");
    server.sendContent(FIRMWARE_VERSION);
    server.sendContent(R"rawliteral(</strong> |
            Build <strong>)rawliteral");
    server.sendContent(FIRMWARE_DATE);
    server.sendContent(R"rawliteral(</strong> |
            <strong>)rawliteral");
    server.sendContent(FIRMWARE_FEATURES);
    server.sendContent(R"rawliteral(</strong>
        </p>
    </div>
</div>

<div id="gotoModal" class="modal">
    <div class="modal-content">
        <h3>Vai a posizione (cm)</h3>
        <input type="number" id="targetCm" placeholder="Inserisci lunghezza in cm" step="0.1">
        <div class="modal-buttons">
            <button onclick="executeGoTo()" class="success">Avvia</button>
            <button onclick="closeModal()">Annulla</button>
        </div>
    </div>
</div>

<script>
    let chart;
    let dataPoints = [];
    let autoScaleEnabled = true;
    let userHasZoomed = false;
    let ws;
    let currentDisplayZero = 0.0;
    let currentOffset = 0.0;
    let uploadedDatasets = [];
    let nextDatasetId = 1;
    let isGoToActive = false;
    const colorPalette = [
        '#FF6384','#36A2EB','#FFCE56','#4BC0C0','#9966FF',
        '#FF9F40','#FF6384','#C9CBCF','#7CFFB2','#F465D4',
        '#8C564B','#E377C2','#7F7F7F','#BCBD22','#17BECF'
    ];
    let selectedColor = colorPalette[0];

    let scanRunning = false;
    let scanStartMs = 0;
    let scanInterval = null;
    let scanReceiving = false;
    let gotoPosX = null;  // current GOTOPOS position in cm — drives vertical line overlay on chart

    // Rauch-Tung-Striebel (RTS) Kalman smoother:
    //   forward Kalman pass + backward smoothing pass → zero phase lag, optimal for Gaussian noise.
    // R = measurement noise variance (caliper 0.01mm precision → R = 0.0001 mm²).
    // Q = process noise: how much diameter can change per step.
    //     level 0 → raw data. level 1–10 → Q = R × 10^(2 - level×0.4).
    function smoothKalman(data, level) {
        if (level === 0 || data.length < 2) return data.slice();
        const R = 0.0001;                              // (0.01mm)² — caliper resolution
        // Q maps level → process noise. Steeper curve so mid-range levels give real smoothing:
        //   level 0 → Q=R×100 → K≈1 (raw)
        //   level 5 → Q=R×0.1  → K≈0.24
        //   level 7 → Q=R×0.006 → K≈0.07
        //   level 10→ Q=R×0.0001→ K≈0.01
        const Q = R * Math.pow(10, 2 - level * 0.6);

        const n = data.length;
        const xf = new Float64Array(n);
        const Pf = new Float64Array(n);

        // Forward pass (Kalman filter)
        xf[0] = data[0].y;
        Pf[0] = R;
        for (let i = 1; i < n; i++) {
            const Pp = Pf[i-1] + Q;
            const K  = Pp / (Pp + R);
            xf[i]   = xf[i-1] + K * (data[i].y - xf[i-1]);
            Pf[i]   = (1 - K) * Pp;
        }

        // Backward pass (RTS smoother)
        const xs = xf.slice();
        const Ps = Pf.slice();
        for (let i = n - 2; i >= 0; i--) {
            const Pp = Pf[i] + Q;
            const G  = Pf[i] / Pp;
            xs[i]   = xf[i] + G * (xs[i+1] - xf[i]);
            Ps[i]   = Pf[i] + G * G * (Ps[i+1] - Pp);
        }

        return data.map((p, i) => ({ x: p.x, y: Math.round(xs[i] * 100) / 100 }));
    }

    function formatMMSS(totalSeconds) {
        const m = Math.floor(totalSeconds / 60);
        const s = totalSeconds % 60;
        return String(m).padStart(2,'0') + ':' + String(s).padStart(2,'0');
    }

    function startTimerIfNeeded() {
        if (scanRunning) return;
        scanRunning = true;
        scanStartMs = Date.now();
        document.getElementById('scanTimer').textContent = "00:00";
        if (scanInterval) clearInterval(scanInterval);
        scanInterval = setInterval(() => {
            if (!scanRunning) return;
            const elapsed = Math.floor((Date.now() - scanStartMs) / 1000);
            document.getElementById('scanTimer').textContent = formatMMSS(elapsed);
        }, 500);
    }

    function stopTimer() {
        scanRunning = false;
        if (scanInterval) { clearInterval(scanInterval); scanInterval = null; }
    }

    function startScan() {
        if (isGoToActive) {
            showCommandStatus('Attendi completamento GOTOPOS', true);
            return;
        }
        stopTimer();
        document.getElementById('scanTimer').textContent = "00:00";
        startTimerIfNeeded();
        sendCommand('motor scan');
    }

    function stopScan() {
        sendCommand('motor stop');
        stopTimer();
    }

    function toggleScanEnable() {
        if (isGoToActive) {
            showCommandStatus('Impossibile modificare durante GOTOPOS', true);
            return;
        }
        scanReceiving = !scanReceiving;
        const btn = document.getElementById('btnScanEnable');
        if (scanReceiving) {
            sendCommand('scan_on');
            btn.textContent = '\u23FA Ricezione ON';
            btn.className = 'success';
        } else {
            sendCommand('scan_off');
            btn.textContent = '\u23F8 Ricezione OFF';
            btn.className = 'danger';
        }
    }

    const OPTIMAL_SPEED_MIN = 1.5;
    const OPTIMAL_SPEED_MAX = 2.5;

    // Custom plugin: draws a technical dimension annotation (quota) at the latest
    // scan point while scanning is active. Shows inward arrows spanning the full
    // profile height (±radius) with "Ø X.XX mm" centered between them.
    const diameterQuotaPlugin = {
        id: 'diameterQuota',
        afterDraw(chart) {
            if (!scanReceiving || dataPoints.length === 0) return;
            const last = dataPoints[dataPoints.length - 1];
            if (!last || last.y == null || last.y <= 0) return;

            const xScale = chart.scales.x;
            const yScale = chart.scales.y;

            // dataPoints stores full diameter; chart displays radius (d/2)
            const radius = last.y / 2;
            const xDataPixel = xScale.getPixelForValue(last.x);
            const yTopPixel  = yScale.getPixelForValue( radius);
            const yBotPixel  = yScale.getPixelForValue(-radius);
            const yMid       = (yTopPixel + yBotPixel) / 2;

            // Draw annotation to the right of the last point; flip left if near edge
            const offsetX = 22;
            const x = xDataPixel + offsetX > xScale.right - 50
                    ? xDataPixel - offsetX
                    : xDataPixel + offsetX;

            const ctx = chart.ctx;
            ctx.save();

            const color      = 'rgba(40, 40, 40, 0.85)';
            const arrowH     = 7;
            const arrowW     = 4;
            const tickHalf   = 7;
            const textHalfH  = 9;   // half-height reserved around the label

            ctx.strokeStyle = color;
            ctx.fillStyle   = color;
            ctx.lineWidth   = 1.5;

            // Horizontal ticks at top and bottom
            ctx.beginPath();
            ctx.moveTo(x - tickHalf, yTopPixel); ctx.lineTo(x + tickHalf, yTopPixel);
            ctx.moveTo(x - tickHalf, yBotPixel); ctx.lineTo(x + tickHalf, yBotPixel);
            ctx.stroke();

            // Vertical dimension lines (split around the label)
            ctx.beginPath();
            ctx.moveTo(x, yTopPixel + arrowH);   ctx.lineTo(x, yMid - textHalfH);
            ctx.moveTo(x, yMid + textHalfH);     ctx.lineTo(x, yBotPixel - arrowH);
            ctx.stroke();

            // Top arrow ▲ pointing toward yTopPixel
            ctx.beginPath();
            ctx.moveTo(x,          yTopPixel);
            ctx.lineTo(x - arrowW, yTopPixel + arrowH);
            ctx.lineTo(x + arrowW, yTopPixel + arrowH);
            ctx.closePath(); ctx.fill();

            // Bottom arrow ▼ pointing toward yBotPixel
            ctx.beginPath();
            ctx.moveTo(x,          yBotPixel);
            ctx.lineTo(x - arrowW, yBotPixel - arrowH);
            ctx.lineTo(x + arrowW, yBotPixel - arrowH);
            ctx.closePath(); ctx.fill();

            // Label "Ø X.XX mm"
            ctx.font         = 'bold 11px sans-serif';
            ctx.textAlign    = 'center';
            ctx.textBaseline = 'middle';
            ctx.fillText('Ø ' + last.y.toFixed(2) + ' mm', x, yMid);

            ctx.restore();
        }
    };
    Chart.register(diameterQuotaPlugin);
    // Registered globally so it applies to the chart without any CDN dependency.
    const gotoposLinePlugin = {
        id: 'gotoposLine',
        afterDraw(chart) {
            if (gotoPosX === null) return;
            const xScale = chart.scales.x;
            const yScale = chart.scales.y;
            const xPixel = xScale.getPixelForValue(gotoPosX);
            if (xPixel < xScale.left || xPixel > xScale.right) return;
            const ctx = chart.ctx;
            ctx.save();
            ctx.beginPath();
            ctx.moveTo(xPixel, yScale.top);
            ctx.lineTo(xPixel, yScale.bottom);
            ctx.strokeStyle = 'rgba(255, 60, 60, 0.85)';
            ctx.lineWidth = 2;
            ctx.setLineDash([6, 3]);
            ctx.stroke();
            // Label
            ctx.setLineDash([]);
            ctx.fillStyle = 'rgba(255, 60, 60, 0.85)';
            ctx.font = 'bold 11px sans-serif';
            ctx.textAlign = xPixel > xScale.right - 60 ? 'right' : 'left';
            ctx.fillText(gotoPosX.toFixed(1) + ' cm', xPixel + (ctx.textAlign === 'left' ? 4 : -4), yScale.top + 14);
            ctx.restore();
        }
    };
    Chart.register(gotoposLinePlugin);

    // Custom plugin: replaces the default tooltip box with a canvas-drawn
    // dimension annotation (same style as diameterQuotaPlugin) at the hovered point.
    // Uses afterEvent to capture the hovered data point, then draws in afterDraw.
    const hoverQuotaPlugin = {
        id: 'hoverQuota',
        _dp: null,
        afterEvent(chart, args) {
            const t = args.event.type;
            if (t === 'mousemove') {
                const native = args.event.native;
                if (native) {
                    const els = chart.getElementsAtEventForMode(native, 'nearest', { intersect: false }, false);
                    const el = els.find(a => a.datasetIndex < chart.data.datasets.length &&
                        !chart.data.datasets[a.datasetIndex].label.startsWith('__mirror__'));
                    this._dp = el ? chart.data.datasets[el.datasetIndex].data[el.index] : null;
                }
                args.changed = true;
            } else if (t === 'mouseout') {
                this._dp = null;
                args.changed = true;
            }
        },
        afterDraw(chart) {
            const dp = this._dp;
            if (!dp || dp.y == null || dp.y <= 0) return;

            const xScale = chart.scales.x;
            const yScale = chart.scales.y;

            // dp.y is radius (toHalfY applied); dp.x is corrected cm
            const radius = Math.abs(dp.y);
            const diam   = radius * 2;

            const xDataPixel = xScale.getPixelForValue(dp.x);
            const yTopPixel  = yScale.getPixelForValue( radius);
            const yBotPixel  = yScale.getPixelForValue(-radius);
            const yMid       = (yTopPixel + yBotPixel) / 2;

            // Flip annotation left if near right edge
            const offsetX = 22;
            const x = xDataPixel + offsetX > xScale.right - 60
                    ? xDataPixel - offsetX
                    : xDataPixel + offsetX;

            const ctx = chart.ctx;
            ctx.save();

            const color     = 'rgba(40, 40, 40, 0.85)';
            const arrowH    = 7, arrowW = 4, tickHalf = 7, textHalfH = 9;

            ctx.strokeStyle = color;
            ctx.fillStyle   = color;
            ctx.lineWidth   = 1.5;

            // Horizontal ticks at ±radius
            ctx.beginPath();
            ctx.moveTo(x - tickHalf, yTopPixel); ctx.lineTo(x + tickHalf, yTopPixel);
            ctx.moveTo(x - tickHalf, yBotPixel); ctx.lineTo(x + tickHalf, yBotPixel);
            ctx.stroke();

            // Vertical lines split around the diameter label
            ctx.beginPath();
            ctx.moveTo(x, yTopPixel + arrowH);  ctx.lineTo(x, yMid - textHalfH);
            ctx.moveTo(x, yMid + textHalfH);    ctx.lineTo(x, yBotPixel - arrowH);
            ctx.stroke();

            // Top arrow
            ctx.beginPath();
            ctx.moveTo(x,          yTopPixel);
            ctx.lineTo(x - arrowW, yTopPixel + arrowH);
            ctx.lineTo(x + arrowW, yTopPixel + arrowH);
            ctx.closePath(); ctx.fill();

            // Bottom arrow
            ctx.beginPath();
            ctx.moveTo(x,          yBotPixel);
            ctx.lineTo(x - arrowW, yBotPixel - arrowH);
            ctx.lineTo(x + arrowW, yBotPixel - arrowH);
            ctx.closePath(); ctx.fill();

            // Diameter label centered between arrows
            ctx.font         = 'bold 11px sans-serif';
            ctx.textAlign    = 'center';
            ctx.textBaseline = 'middle';
            ctx.fillText('Ø ' + diam.toFixed(2) + ' mm', x, yMid);

            // Length label above the top tick
            ctx.font = '10px sans-serif';
            ctx.fillText(dp.x.toFixed(1) + ' cm', x, yTopPixel - 11);

            ctx.restore();
        }
    };
    Chart.register(hoverQuotaPlugin);

    // Gradient fill plugin — manually draws a gradient-filled polygon between each
    // top-profile dataset and its mirror, anchored to the actual pixel extent of the
    // data band so the sfumatura is always proportional to the visible line thickness.
    // Runs in beforeDatasetsDraw so it sits underneath the border lines.
    const gradientFillPlugin = {
        id: 'gradientFill',
        beforeDatasetsDraw(chart) {
            const ctx     = chart.ctx;
            const yScale  = chart.scales.y;
            if (!yScale) return;

            chart.data.datasets.forEach((ds, i) => {
                // Only top-profile datasets (non-mirror, fill toward index+1)
                if (!ds.label || ds.label.startsWith('__mirror__')) return;

                const mirrorIdx = i + 1;
                if (mirrorIdx >= chart.data.datasets.length) return;

                const topMeta = chart.getDatasetMeta(i);
                const botMeta = chart.getDatasetMeta(mirrorIdx);
                if (!topMeta || !botMeta) return;
                if (!topMeta.data.length || !botMeta.data.length) return;
                if (topMeta.hidden || botMeta.hidden) return;

                const topPts = topMeta.data;
                const botPts = botMeta.data;

                // Actual pixel extent of the fill band
                const yBandTop = Math.min(...topPts.map(p => p.y)); // highest pixel (small y)
                const yBandBot = Math.max(...botPts.map(p => p.y)); // lowest pixel (large y)
                const yCenter  = yScale.getPixelForValue(0);        // centre of round section
                const bandH    = yBandBot - yBandTop;
                if (bandH < 2) return;

                // Parse #RRGGBB border color
                const hex = (typeof ds.borderColor === 'string' && ds.borderColor.startsWith('#'))
                            ? ds.borderColor : '#007bff';
                const r = parseInt(hex.slice(1,3), 16);
                const g = parseInt(hex.slice(3,5), 16);
                const b = parseInt(hex.slice(5,7), 16);
                const rgb = `${r},${g},${b}`;

                // Centre fraction within the actual band (clamped so stops stay valid)
                const cf   = Math.max(0.05, Math.min(0.95, (yCenter - yBandTop) / bandH));
                const grad = ctx.createLinearGradient(0, yBandTop, 0, yBandBot);
                grad.addColorStop(0.00,                           `rgba(${rgb},0.72)`);
                grad.addColorStop(Math.max(0.00, cf - 0.28),      `rgba(${rgb},0.44)`);
                grad.addColorStop(Math.max(0.00, cf - 0.10),      `rgba(255,255,255,0.18)`);
                grad.addColorStop(cf,                             `rgba(255,255,255,0.32)`);
                grad.addColorStop(Math.min(1.00, cf + 0.10),      `rgba(255,255,255,0.18)`);
                grad.addColorStop(Math.min(1.00, cf + 0.28),      `rgba(${rgb},0.44)`);
                grad.addColorStop(1.00,                           `rgba(${rgb},0.72)`);

                // Draw gradient-filled polygon, clipped to chart area
                ctx.save();
                ctx.beginPath();
                ctx.rect(chart.chartArea.left,  chart.chartArea.top,
                         chart.chartArea.width, chart.chartArea.height);
                ctx.clip();

                ctx.beginPath();
                topPts.forEach((pt, j) => j === 0 ? ctx.moveTo(pt.x, pt.y) : ctx.lineTo(pt.x, pt.y));
                for (let j = botPts.length - 1; j >= 0; j--) ctx.lineTo(botPts[j].x, botPts[j].y);
                ctx.closePath();
                ctx.fillStyle = grad;
                ctx.fill();
                ctx.restore();
            });
        }
    };
    Chart.register(gradientFillPlugin);

    function initializeChart() {
        const ctx = document.getElementById('lineChart').getContext('2d');
        initializeColorPalette();
        chart = new Chart(ctx, {
            type: 'line',
            data: {
                datasets: [
                    {   // index 0: live scan top profile
                        label: 'Diametro Compensato (mm)',
                        data: dataPoints,
                        borderColor: '#007bff',
                        backgroundColor: 'rgba(0,0,0,0)',
                        borderWidth: 2,
                        tension: 0.4,
                        cubicInterpolationMode: 'monotone',
                        fill: '+1',
                        pointRadius: 1,
                        pointHoverRadius: 4,
                        pointBackgroundColor: '#007bff',
                        pointBorderColor: '#007bff',
                        pointBorderWidth: 0
                    },
                    {   // index 1: live scan mirror (always paired with index 0)
                        label: '__mirror__Diametro Compensato (mm)',
                        data: [],
                        borderColor: '#007bff',
                        backgroundColor: 'rgba(0,0,0,0)',
                        borderWidth: 2,
                        tension: 0.4,
                        cubicInterpolationMode: 'monotone',
                        fill: false,
                        pointRadius: 0,
                        pointHoverRadius: 0
                    }
                ]
            },
            options: {
                responsive: true,
                maintainAspectRatio: false,
                animation: { duration: 0 },
                scales: {
                    x: {
                        type: 'linear',
                        title: { display: true, text: 'Lunghezza (cm)', font: { size: 14, weight: 'bold' } },
                        grid: { color: 'rgba(0,0,0,0.1)' }
                    },
                    y: {
                        title: { display: true, text: 'Diametro (mm)', font: { size: 14, weight: 'bold' } },
                        grid: { color: 'rgba(0,0,0,0.1)' },
                        ticks: {
                            stepSize: 0.5,
                            callback: v => Math.abs(v).toFixed(1) + ' mm'
                        }
                    }
                },
                plugins: {
                    legend: {
                        display: true,
                        position: 'top',
                        labels: { filter: item => !item.text.startsWith('__mirror__') }
                    },
                    tooltip: {
                        enabled: false,
                        mode: 'nearest',
                        intersect: false,
                    },
                    zoom: {
                        pan: { enabled: true, mode: 'xy', modifierKey: 'ctrl' },
                        zoom: { wheel: { enabled: true }, pinch: { enabled: true }, mode: 'xy' },
                        limits: { x: { min: 0, max: 100000 }, y: { min: -10, max: 10 } }
                    }
                },
                interaction: { intersect: false, mode: 'nearest' }
            }
        });
        fitToData();    }

    function initializeColorPalette() {
        const paletteContainer = document.getElementById('colorPalette');
        paletteContainer.innerHTML = '';
        colorPalette.forEach(color => {
            const colorOption = document.createElement('div');
            colorOption.className = 'color-option';
            colorOption.style.backgroundColor = color;
            if (color === selectedColor) colorOption.classList.add('selected');
            colorOption.onclick = function() {
                document.querySelectorAll('.color-option').forEach(opt => opt.classList.remove('selected'));
                this.classList.add('selected');
                selectedColor = color;
            };
            paletteContainer.appendChild(colorOption);
        });
    }

    function updateSpeedDisplay(speed) {
        const speedElement = document.getElementById('currentSpeed');
        const statusElement = document.getElementById('speedStatus');
        speedElement.textContent = speed.toFixed(2) + ' cm/s';
        if (speed < OPTIMAL_SPEED_MIN) {
            statusElement.textContent = 'Troppo Lenta';
            statusElement.className = 'status-value speed-too-slow';
            speedElement.className = 'status-value speed-too-slow';
        } else if (speed > OPTIMAL_SPEED_MAX) {
            statusElement.textContent = 'Troppo Alta';
            statusElement.className = 'status-value speed-too-fast';
            speedElement.className = 'status-value speed-too-fast';
        } else {
            statusElement.textContent = 'Ottimale';
            statusElement.className = 'status-value speed-optimal';
            speedElement.className = 'status-value speed-optimal';
        }
    }

    function uploadCSV() {
        const fileInput = document.getElementById('csvFile');
        const datasetNameInput = document.getElementById('datasetName');
        const file = fileInput.files[0];
        const datasetName = datasetNameInput.value || `Dataset ${nextDatasetId}`;
        if (!file) { showCommandStatus('Seleziona un file CSV', true); return; }
        const reader = new FileReader();
        reader.onload = function(e) {
            try {
                const csv = e.target.result;
                const lines = csv.split('\n');
                const newDataPoints = [];
                let hasHeader = false;
                let xIndex = 1;
                let yIndex = 2;
                if (lines.length > 0) {
                    const firstLine = lines[0].toLowerCase();
                    if (firstLine.includes('dataset') || firstLine.includes('lunghezza') ||
                        firstLine.includes('diametro') || firstLine.includes(',')) {
                        hasHeader = true;
                        const headers = firstLine.split(',').map(h => h.trim().toLowerCase().replace(/\"/g, ''));
                        xIndex = 0; yIndex = 1;
                        for (let i = 0; i < headers.length; i++) {
                            if (headers[i].includes('lunghezza') || headers[i].includes('cm')) xIndex = i;
                            if (headers[i].includes('diametro') || headers[i].includes('mm')) yIndex = i;
                        }
                        if (headers.includes('dataset') && headers.length >= 3) { xIndex = 1; yIndex = 2; }
                    }
                }
                const startLine = hasHeader ? 1 : 0;
                let invalidPoints = 0;
                for (let i = startLine; i < lines.length; i++) {
                    const line = lines[i].trim();
                    if (line) {
                        const parts = line.split(',').map(part => part.trim().replace(/\"/g, ''));
                        if (parts.length >= Math.max(xIndex, yIndex) + 1) {
                            const x = parseFloat(parts[xIndex]);
                            const y = parseFloat(parts[yIndex]);
                            if (!isNaN(x) && !isNaN(y)) newDataPoints.push({x: x, y: y});
                            else invalidPoints++;
                        } else invalidPoints++;
                    }
                }
                if (newDataPoints.length === 0) {
                    showCommandStatus('Nessun dato valido trovato nel file.', true);
                    return;
                }
                newDataPoints.sort((a, b) => a.x - b.x);
                const newDataset = { id: nextDatasetId++, name: datasetName, color: selectedColor, data: newDataPoints, visible: true };
                uploadedDatasets.push(newDataset);
                addDatasetToChart(newDataset);
                updateDatasetList();
                if (autoScaleEnabled) fitToData(); else chart.update();
                let statusMsg = `Caricati ${newDataPoints.length} punti dati come "${datasetName}"`;
                if (invalidPoints > 0) statusMsg += ` (${invalidPoints} punti ignorati)`;
                showCommandStatus(statusMsg);
                fileInput.value = '';
                datasetNameInput.value = '';
            } catch (error) {
                showCommandStatus('Errore nel processare il file CSV: ' + error.message, true);
            }
        };
        reader.onerror = function() { showCommandStatus('Errore nella lettura del file', true); };
        reader.readAsText(file);
    }

    function addDatasetToChart(dataset) {
        const smoothed = smoothKalman(dataset.data, parseInt(document.getElementById('smoothAlpha').value) || 5);
        const half = toHalfY(smoothed);
        chart.data.datasets.push({
            label: dataset.name,
            data: half,
            borderColor: dataset.color,
            backgroundColor: 'rgba(0,0,0,0)',
            borderWidth: 2,
            tension: 0.4,
            cubicInterpolationMode: 'monotone',
            fill: '+1',
            pointRadius: 1,
            pointHoverRadius: 4,
            pointBackgroundColor: dataset.color,
            pointBorderColor: dataset.color,
            pointBorderWidth: 0,
            hidden: !dataset.visible
        });
        chart.data.datasets.push({
            label: '__mirror__' + dataset.name,
            data: mirrorData(half),
            borderColor: dataset.color,
            backgroundColor: 'rgba(0,0,0,0)',
            borderWidth: 2,
            tension: 0.4,
            cubicInterpolationMode: 'monotone',
            fill: false,
            pointRadius: 0,
            pointHoverRadius: 0,
            hidden: !dataset.visible
        });
        chart.update();
    }

    function updateDatasetList() {
        const datasetList = document.getElementById('datasetList');
        datasetList.innerHTML = '';
        uploadedDatasets.forEach(dataset => {
            const datasetItem = document.createElement('div');
            datasetItem.className = 'dataset-item';
            let maxLengthMeters = 0;
            if (dataset.data.length > 0) {
                const maxLengthCm = Math.max(...dataset.data.map(point => point.x));
                maxLengthMeters = (maxLengthCm / 100).toFixed(1);
            }
            datasetItem.innerHTML = `
                <div style="display:flex;align-items:center;flex-grow:1;">
                    <div class="dataset-color" style="background-color:${dataset.color}"></div>
                    <div class="dataset-name">${dataset.name} (${dataset.data.length} punti, ${maxLengthMeters} m)</div>
                </div>
                <div class="dataset-controls">
                    <button onclick="toggleDataset(${dataset.id})" style="padding:2px 8px;font-size:0.8em;">${dataset.visible ? 'Nascondi' : 'Mostra'}</button>
                    <button onclick="removeDataset(${dataset.id})" style="padding:2px 8px;font-size:0.8em;background:#dc3545;">Rimuovi</button>
                </div>`;
            datasetList.appendChild(datasetItem);
        });
    }

    function toggleDataset(datasetId) {
        const dataset = uploadedDatasets.find(ds => ds.id === datasetId);
        if (dataset) {
            dataset.visible = !dataset.visible;
            const chartDataset = chart.data.datasets.find(ds => ds.label === dataset.name);
            if (chartDataset) chartDataset.hidden = !dataset.visible;
            const mirrorDs = chart.data.datasets.find(ds => ds.label === '__mirror__' + dataset.name);
            if (mirrorDs) mirrorDs.hidden = !dataset.visible;
            chart.update();
            updateDatasetList();
        }
    }

    function removeDataset(datasetId) {
        const datasetIndex = uploadedDatasets.findIndex(ds => ds.id === datasetId);
        if (datasetIndex !== -1) {
            const dataset = uploadedDatasets[datasetIndex];
            // Remove mirror first (splice shifts indices), then the top dataset
            const mirrorIdx = chart.data.datasets.findIndex(ds => ds.label === '__mirror__' + dataset.name);
            if (mirrorIdx !== -1) chart.data.datasets.splice(mirrorIdx, 1);
            const chartDatasetIndex = chart.data.datasets.findIndex(ds => ds.label === dataset.name);
            if (chartDatasetIndex !== -1) chart.data.datasets.splice(chartDatasetIndex, 1);
            uploadedDatasets.splice(datasetIndex, 1);
            chart.update();
            updateDatasetList();
            showCommandStatus(`Dataset "${dataset.name}" rimosso`);
        }
    }

    function clearAllDatasets() {
        if (uploadedDatasets.length === 0) { showCommandStatus('Nessun dataset da rimuovere', true); return; }
        if (confirm('Sei sicuro di voler rimuovere tutti i dataset caricati?')) {
            // Keep indices 0 (live scan) and 1 (its mirror); remove all others
            chart.data.datasets = [chart.data.datasets[0], chart.data.datasets[1]];
            uploadedDatasets = [];
            chart.update();
            updateDatasetList();
            showCommandStatus('Tutti i dataset rimossi');
        }
    }

    async function loadHistoryFromExport() {
        try {
            const r = await fetch('/export', { cache: 'no-store' });
            if (!r.ok) throw new Error('HTTP ' + r.status);
            const csv = await r.text();
            const lines = csv.trim().split('\n');
            dataPoints = [];
            if (lines.length === 0) return;
            const first = (lines[0] || '').trim().toLowerCase();
            const hasHeader = first.includes('lunghezza') || first.includes('diametro') || first.includes('dataset');
            const start = hasHeader ? 1 : 0;
            for (let i = start; i < lines.length; i++) {
                const line = lines[i].trim();
                if (!line) continue;
                const parts = line.split(',').map(p => p.trim());
                if (parts.length < 2) continue;
                let xStr = (parts.length >= 3 ? parts[1] : parts[0]);
                let yStr = (parts.length >= 3 ? parts[2] : parts[1]);
                const x = parseFloat(xStr.replace(',', '.'));
                const y = parseFloat(yStr.replace(',', '.'));
                if (!isNaN(x) && !isNaN(y)) dataPoints.push({ x, y });
            }
            dataPoints.sort((a, b) => a.x - b.x);
            const level = parseInt(document.getElementById('smoothAlpha').value) || 0;
            const smoothed = dataPoints.length > 1 ? smoothKalman(dataPoints, level) : dataPoints;
            chart.data.datasets[0].data = toHalfY(smoothed);
            chart.data.datasets[1].data = mirrorData(toHalfY(smoothed));
            document.getElementById('dataPointsCount').textContent = dataPoints.length;
            if (autoScaleEnabled) fitToData(); else chart.update();
            showCommandStatus('Storico caricato: ' + (dataPoints.length - 1) + ' punti', false);
        } catch (e) {
            showCommandStatus('Errore caricamento storico: ' + e.message, true);
        }
    }

    function connectWebSocket() {
        ws = new WebSocket('ws://' + location.hostname + ':81/');
        ws.onopen = function() {
            document.getElementById('connectionStatus').innerHTML = 'Connesso';
            document.getElementById('connectionStatus').style.color = '#28a745';
            sendCommand('getparams');
            sendCommand('motor status');
        };
        ws.onclose = function() {
            document.getElementById('connectionStatus').innerHTML = 'Disconnesso';
            document.getElementById('connectionStatus').style.color = '#dc3545';
            setTimeout(connectWebSocket, 3000);
        };
        ws.onmessage = function(event) {
            try {
                const msg = JSON.parse(event.data);
                if (msg.type === 'params') {
                    updateParamsDisplay(msg.displayZero, msg.offset, msg.ppc, msg.ppcCalibrated);
                } else if (msg.type === 'diag') {
                    showCommandStatus(msg.text, false, 20000, '#0d6efd');
                } else if (msg.type === 'speed') {
                    updateSpeedDisplay(msg.speed);
                } else if (msg.type === 'motor') {
                    document.getElementById('motorState').textContent = msg.mode + ' ' + msg.dir;
                } else if (msg.type === 'goto_status') {
                    isGoToActive = msg.active;
                    const gotoBtn = document.querySelector('button[onclick="executeGoTo()"]');
                    if (gotoBtn) gotoBtn.disabled = msg.active;
                    const scanBtn = document.querySelector('button[onclick="startScan()"]');
                    if (scanBtn) scanBtn.disabled = msg.active;
                    const toggleBtn = document.getElementById('btnScanEnable');
                    if (toggleBtn) toggleBtn.disabled = msg.active;
                    
                    if (!msg.active && msg.completed) {
                        showCommandStatus('Posizione raggiunta!');
                        const progressSpan = document.getElementById('gotoProgress');
                        progressSpan.style.display = 'none';
                        progressSpan.textContent = '';
                        // Snap line to actual final encoder position (more accurate than last goto_progress)
                        if (msg.final_cm !== undefined) { gotoPosX = msg.final_cm; chart.update('none'); }
                    } else if (!msg.active && !msg.completed) {
                        showCommandStatus('Movimento interrotto', true);
                        gotoPosX = null;
                        chart.update('none');
                    }
                } else if (msg.type === 'goto_progress') {
                    const progressSpan = document.getElementById('gotoProgress');
                    progressSpan.style.display = 'inline-block';
                    progressSpan.textContent = `📍 GOTOPOS: ${msg.remaining_cm.toFixed(1)} cm rimanenti (${msg.current_cm.toFixed(1)}/${msg.target_cm.toFixed(1)} cm)`;
                    gotoPosX = msg.current_cm;
                    chart.update('none');
                } else if (msg.type === 'scan_enabled') {
                    scanReceiving = msg.value;
                    const btn = document.getElementById('btnScanEnable');
                    if (msg.value) {
                        btn.textContent = '\u23FA Ricezione ON';
                        btn.className = 'success';
                    } else {
                        btn.textContent = '\u23F8 Ricezione OFF';
                        btn.className = 'danger';
                    }
                } else if (msg.cm !== undefined) {
                    if (!isGoToActive) {
                        startTimerIfNeeded();
                        updateDisplay(msg);
                    } else {
                        document.getElementById('currentLength').textContent = msg.cm + ' cm';
                    }
                }
            } catch(e) {
                console.error('Errore parsing JSON:', e);
            }
        };
        ws.onerror = function(error) { console.error('WebSocket error:', error); };
    }

    function updateParamsDisplay(displayZero, offset, ppc, ppcCalibrated) {
        currentDisplayZero = displayZero;
        currentOffset = offset;
        document.getElementById('currentDisplayZero').textContent = displayZero.toFixed(2);
        document.getElementById('displayZeroValue').textContent = displayZero.toFixed(2);
        document.getElementById('currentOffsetValue').textContent = offset.toFixed(2);
        document.getElementById('currentOffset').textContent = offset.toFixed(2);
        if (ppc !== undefined) {
            document.getElementById('ppcActiveValue').textContent = ppc.toFixed(4);
            const src = document.getElementById('ppcSource');
            if (ppcCalibrated) {
                src.textContent = '(calibrato)';
                src.style.color = '#28a745';
            } else {
                src.textContent = '(formula)';
                src.style.color = '#aaa';
            }
        }
    }

    function doCalibratePpc() {
        const v = document.getElementById('calibKnownCm').value;
        if (!v || isNaN(v) || parseFloat(v) < 1) {
            showCommandStatus('Inserire una lunghezza valida (minimo 1 cm)', true);
            return;
        }
        sendCommand('calibrate:' + parseFloat(v));
        showCommandStatus('Calibrazione inviata per ' + parseFloat(v) + ' cm');
    }

    function doSetPpc() {
        const v = document.getElementById('manualPpcInput').value;
        if (!v || isNaN(v) || parseFloat(v) < 5 || parseFloat(v) > 500) {
            showCommandStatus('PPC non valido (range 5–500)', true);
            return;
        }
        sendCommand('setppc:' + parseFloat(v).toFixed(4));
        showCommandStatus('PPC impostato a ' + parseFloat(v).toFixed(4));
    }

    function updateDisplay(msg) {
        document.getElementById('currentLength').textContent = msg.cm + ' cm';
        document.getElementById('currentDiameter').textContent = msg.diameter.toFixed(2) + ' mm';
        document.getElementById('currentDisplay').textContent = msg.rawDisplay.toFixed(2) + ' mm';
        document.getElementById('lastUpdate').textContent = new Date().toLocaleTimeString();
        document.getElementById('dataPointsCount').textContent = msg.totalPoints || dataPoints.length;
        addDataPoint(msg.cm, msg.diameter);
    }

    function addDataPoint(x, y) {
        const point = {x: x, y: Math.round(y * 100) / 100};
        const existingIndex = dataPoints.findIndex(p => p.x === x);
        if (existingIndex !== -1) {
            dataPoints[existingIndex] = point;
        } else {
            dataPoints.push(point);
        }
        dataPoints.sort((a, b) => a.x - b.x);
        const level = parseInt(document.getElementById('smoothAlpha').value) || 0;
        const smoothed = dataPoints.length > 1 ? smoothKalman(dataPoints, level) : dataPoints;
        chart.data.datasets[0].data = toHalfY(smoothed);
        chart.data.datasets[1].data = mirrorData(toHalfY(smoothed));
        document.getElementById('dataPointsCount').textContent = dataPoints.length;
        if (autoScaleEnabled) fitToData();
        else chart.update('none');
    }

    function redrawLiveSmoothing() {
        if (dataPoints.length < 2) return;
        const level = parseInt(document.getElementById('smoothAlpha').value) || 0;
        const smoothed = smoothKalman(dataPoints, level);
        chart.data.datasets[0].data = toHalfY(smoothed);
        chart.data.datasets[1].data = mirrorData(toHalfY(smoothed));
        chart.update('none');
    }

    function zoomIn()  { userHasZoomed = true; chart.zoom(1.1); }
    function zoomOut() { userHasZoomed = true; chart.zoom(0.9); }

    function resetZoom() {
        userHasZoomed = false;
        chart.resetZoom();
        if (autoScaleEnabled) fitToData();
    }

    // Convert diameter values to radius for chart display so the full mirrored
    // profile height equals the actual line diameter (not 2×).
    function toHalfY(data) {
        return data.map(p => ({ x: p.x, y: p.y / 2 }));
    }

    function mirrorData(data) {
        return data.map(p => ({ x: p.x, y: -p.y }));
    }

    function fitToData() {
        if (userHasZoomed) return;
        if (dataPoints.length === 0 && uploadedDatasets.length === 0) return;
        const allChartData = [...dataPoints];
        uploadedDatasets.forEach(dataset => { if (dataset.visible) allChartData.push(...dataset.data); });
        if (allChartData.length === 0) return;
        const xValues = allChartData.map(p => p.x);
        const yValues = allChartData.map(p => p.y);
        let minX = Math.min(...xValues);
        let maxX = Math.max(...xValues);
        let maxY = Math.max(...yValues) / 2;  // yValues are diameters; chart uses radius
        const xRange = maxX - minX;
        if (xRange === 0) { minX -= 10; maxX += 10; } else { minX -= xRange * 0.05; maxX += xRange * 0.05; }
        // Y is symmetric around 0 to show full mirrored cross-section profile
        chart.options.scales.x.min = minX;
        chart.options.scales.x.max = maxX;
        const halfY = Math.max(maxY * 1.15, 0.1);
        chart.options.scales.y.min = -halfY;
        chart.options.scales.y.max =  halfY;
        chart.update();
    }

    function resetChart() {
        dataPoints = [];
        chart.data.datasets[0].data = dataPoints;
        chart.data.datasets[1].data = [];
        if (autoScaleEnabled) fitToData(); else chart.update();
        document.getElementById('dataPointsCount').textContent = 0;
        showCommandStatus('Grafico resettato');
    }

    // Export live scan only (raw dataPoints, positive values, no mirror)
    function exportCurrentScan() {
        if (dataPoints.length === 0) { showCommandStatus('Nessun dato da esportare', true); return; }
        let csv = "Lunghezza cm,Diametro mm\n";
        dataPoints.forEach(p => { csv += p.x.toFixed(1) + "," + p.y.toFixed(3) + "\n"; });
        triggerDownload(csv, 'scansione.csv');
        showCommandStatus('Scansione esportata (' + dataPoints.length + ' punti)');
    }

    // Export all visible datasets in aligned columns — one row per unique x position.
    // Positions missing in a dataset are left blank.
    function exportAllDatasets() {
        // Collect visible sources: live scan + uploaded datasets that are visible
        const sources = [];
        if (dataPoints.length > 0) sources.push({ name: 'Diametro Compensato (mm)', data: dataPoints });
        uploadedDatasets.forEach(ds => {
            if (ds.visible) sources.push({ name: ds.name, data: ds.data });
        });
        if (sources.length === 0) { showCommandStatus('Nessun dataset visibile da esportare', true); return; }

        // Build sorted union of all x values
        const xSet = new Set();
        sources.forEach(s => s.data.forEach(p => xSet.add(p.x)));
        const xValues = Array.from(xSet).sort((a, b) => a - b);

        // Build lookup maps {x → y} for each source
        const maps = sources.map(s => {
            const m = new Map();
            s.data.forEach(p => m.set(p.x, p.y));
            return m;
        });

        // Header
        let csv = "Lunghezza cm," + sources.map(s => `"${s.name}"`).join(",") + "\n";

        // Rows — blank cell when a dataset has no point at that x
        xValues.forEach(x => {
            const row = [x.toFixed(1)];
            maps.forEach(m => row.push(m.has(x) ? m.get(x).toFixed(3) : ''));
            csv += row.join(",") + "\n";
        });

        const ts = new Date().toISOString().slice(0,16).replace('T','_').replace(':','h');
        triggerDownload(csv, `profilo_${ts}.csv`);
        showCommandStatus(`Esportati ${sources.length} dataset, ${xValues.length} posizioni`);
    }

    function triggerDownload(content, filename) {
        const blob = new Blob([content], { type: 'text/csv' });
        const url = window.URL.createObjectURL(blob);
        const a = document.createElement('a');
        a.href = url; a.download = filename;
        document.body.appendChild(a); a.click();
        document.body.removeChild(a);
        window.URL.revokeObjectURL(url);
    }

    function exportChartPng() {
        if (!chart) { showCommandStatus('Grafico non disponibile', true); return; }
        const ts = new Date().toISOString().replace(/[:.]/g, '-').slice(0, 19);
        const a = document.createElement('a');
        a.href = chart.toBase64Image('image/png', 1.0);
        a.download = `profilo_${ts}.png`;
        document.body.appendChild(a); a.click();
        document.body.removeChild(a);
        showCommandStatus('Immagine esportata');
    }

    function toggleAutoScale() {
        autoScaleEnabled = !autoScaleEnabled;
        document.getElementById('autoScaleStatus').textContent = autoScaleEnabled ? 'ON' : 'OFF';
        if (autoScaleEnabled) fitToData(); else chart.update();
        showCommandStatus('Auto-Fit: ' + (autoScaleEnabled ? 'ON' : 'OFF'));
    }

    function sendCommand(command) {
        if (ws && ws.readyState === WebSocket.OPEN) {
            ws.send(command);
            showCommandStatus('Comando inviato: ' + command);
            if (command === 'reset') {
                dataPoints = [];
                chart.data.datasets[0].data = dataPoints;
                chart.data.datasets[1].data = [];
                if (autoScaleEnabled) fitToData(); else chart.update();
                document.getElementById('dataPointsCount').textContent = 0;
                stopTimer();
                document.getElementById('scanTimer').textContent = "00:00";
            }
        } else {
            showCommandStatus('Errore: WebSocket non connesso', true);
        }
    }

    function setOffset() {
        const offset = document.getElementById('offsetValue').value;
        if (offset && !isNaN(offset)) {
            sendCommand('setoffset ' + offset);
            document.getElementById('offsetValue').value = '';
        } else {
            showCommandStatus('Inserire un valore offset valido', true);
        }
    }

    let statusTimer = null;
    function showCommandStatus(message, isError = false, ms = 3000, color = null) {
        const statusElement = document.getElementById('commandStatus');
        statusElement.textContent = message;
        statusElement.style.color = color ? color : (isError ? '#dc3545' : '#28a745');
        if (statusTimer) clearTimeout(statusTimer);
        statusTimer = setTimeout(() => { statusElement.textContent = ''; }, ms);
    }

    function accToggle(btn) {
        btn.classList.toggle('acc-open');
        btn.nextElementSibling.classList.toggle('acc-open');
    }

    function showGoToDialog() {
        if (isGoToActive) {
            showCommandStatus('GOTOPOS già in corso', true);
            return;
        }
        document.getElementById('gotoModal').style.display = 'block';
        document.getElementById('targetCm').focus();
    }

    function closeModal() {
        document.getElementById('gotoModal').style.display = 'none';
        document.getElementById('targetCm').value = '';
    }

    function executeGoTo() {
        const target = document.getElementById('targetCm').value;
        if (target && !isNaN(target) && parseFloat(target) >= 0) {
            sendCommand('goto ' + target);
            closeModal();
        } else {
            showCommandStatus('Inserire una lunghezza valida (>= 0)', true);
        }
    }

    window.onclick = function(event) {
        const modal = document.getElementById('gotoModal');
        if (event.target == modal) {
            closeModal();
        }
    }

    document.addEventListener('DOMContentLoaded', async function () {
        initializeChart();
        await loadHistoryFromExport();
        connectWebSocket();
        document.getElementById('lastUpdate').textContent = new Date().toLocaleTimeString();
    });
</script>
</body>
</html>
)rawliteral");
  });

  server.on("/export", HTTP_GET, []() {
    server.setContentLength(CONTENT_LENGTH_UNKNOWN);
    server.sendHeader("Content-Disposition", "attachment; filename=diametrolinea.csv");
    server.sendHeader("Cache-Control", "no-store");
    server.send(200, "text/csv", "");
    server.sendContent("Lunghezza cm,Diametro mm\r\n");
    char line[64];
    int n = 0;
    for (DataPoint* cur = firstDataPoint; cur != nullptr; cur = cur->next) {
      snprintf(line, sizeof(line), "%d,%.2f\r\n", cur->cm, cur->diameter);
      server.sendContent(line);
      if ((++n % 50) == 0) delay(1);
      else delay(0);
    }
  });

  server.on("/encoder", HTTP_GET, []() {
    long enc = getEncoderValue();
    float cm  = (float)enc / getActivePpc() - 2.0f;
    int16_t hwCount = 0;
    pcnt_get_counter_value(PCNT_ENC_UNIT, &hwCount);
    String json = "{\"ticks\":" + String(enc) +
                  ",\"pcntAccum\":" + String(pcntAccum) +
                  ",\"hwCounter\":" + String(hwCount) +
                  ",\"ppc\":" + String(getActivePpc(), 4) +
                  ",\"cm\":" + String(cm, 2) +
                  ",\"scanEnabled\":" + String(scanEnabled ? "true" : "false") +
                  ",\"totalPoints\":" + String(getTotalDataPoints()) + "}";
    server.send(200, "application/json", json);
  });

  server.on("/motor_diag", HTTP_GET, []() {
    long lastStatusAgeMs = motorLastSeenMs == 0
        ? -1
        : (long)(millis() - motorLastSeenMs);
    String json = "{\"mode\":\"" + motorMode +
                  "\",\"wsCommands\":" + String(webSocketCommandCount) +
                  ",\"lastWsCommand\":\"" + webSocketLastCommand +
                  "\",\"wsControlCommands\":" + String(webSocketControlCount) +
                  ",\"lastWsControl\":\"" + webSocketLastControlCommand +
                  "\",\"txQueued\":" + String(motorTxQueued) +
                  ",\"lastQueued\":\"" + motorLastQueued +
                  "\",\"txLines\":" + String(motorTxLines) +
                  ",\"lastTx\":\"" + motorLastSent +
                  "\",\"lastTxAgeMs\":" + String(motorLastSentMs == 0 ? -1L : (long)(millis() - motorLastSentMs)) +
                  ",\"controlQueued\":" + String(motorControlQueued) +
                  ",\"lastControlQueued\":\"" + motorLastControlQueued +
                  "\",\"controlTxLines\":" + String(motorControlTxLines) +
                  ",\"lastControlTx\":\"" + motorLastControlSent +
                  "\",\"lastControlTxAgeMs\":" + String(motorLastControlSentMs == 0 ? -1L : (long)(millis() - motorLastControlSentMs)) +
                  ",\"rxBytes\":" + String(motorRxBytes) +
                  ",\"rxLines\":" + String(motorRxLines) +
                  ",\"statusLines\":" + String(motorStatusLines) +
                  ",\"slaveRxBytes\":" + String(slaveUartRxBytes) +
                  ",\"slaveRxLines\":" + String(slaveUartRxLines) +
                  ",\"slaveRxCommands\":" + String(slaveUartRxCommands) +
                  ",\"slaveLastControl\":\"" + slaveLastControlCommand +
                  "\",\"slaveIp\":\"" + slaveDiagIp +
                  "\",\"lastStatusAgeMs\":" + String(lastStatusAgeMs) +
                  ",\"watchdogArmed\":" + String(motorWatchdogArmed ? "true" : "false") +
                  ",\"watchdogStopSent\":" + String(encoderWatchdogStopSent ? "true" : "false") +
                  ",\"txPending\":" + String(motorTxHasPending ? "true" : "false") + "}";
    server.send(200, "application/json", json);
  });

  server.begin();

  webSocket.begin();
  webSocket.onEvent([](uint8_t num, WStype_t type, uint8_t* payload, size_t length) {
    if (type == WStype_TEXT) {
      String cmd = String((char*)payload);
      webSocketCommandCount++;
      webSocketLastCommand = cmd;
      if (cmd != "getparams" && cmd != "motor status") {
        webSocketControlCount++;
        webSocketLastControlCommand = cmd;
      }
      if (cmd == "getparams") {
        String json = "{\"type\":\"params\",\"displayZero\":" + String(displayZeroValue, 2) + ",\"offset\":" + String(caliperZeroOffset, 2) + ",\"ppc\":" + String(getActivePpc(), 4) + ",\"ppcCalibrated\":" + String((calibratedPpc >= 5.0f && calibratedPpc <= 500.0f) ? "true" : "false") + "}";
        webSocket.sendTXT(num, json);
      } else {
        handleCommand(cmd);
      }
    } else if (type == WStype_CONNECTED) {
      String json = "{\"type\":\"params\",\"displayZero\":" + String(displayZeroValue, 2) + ",\"offset\":" + String(caliperZeroOffset, 2) + ",\"ppc\":" + String(getActivePpc(), 4) + ",\"ppcCalibrated\":" + String((calibratedPpc >= 5.0f && calibratedPpc <= 500.0f) ? "true" : "false") + "}";
      webSocket.sendTXT(num, json);
      String scanJson = "{\"type\":\"scan_enabled\",\"value\":" + String(scanEnabled ? "true" : "false") + "}";
      webSocket.sendTXT(num, scanJson);
    }
  });

  Serial.println("Sistema pronto - CALIBRO FISSO");
  Serial.println("cm,diametro_compensato,display_calibro");
}

// -----------------------------
void calculateSpeed() {
  unsigned long currentTime = millis();
  if (currentTime - lastSpeedTime >= 1000) {
    int encoderDiff = getEncoderValue() - lastSpeedEncoder;
    currentSpeed = abs(encoderDiff / getActivePpc());
    lastSpeedEncoder = getEncoderValue();
    lastSpeedTime = currentTime;
    String json = "{\"type\":\"speed\",\"speed\":" + String(currentSpeed, 2) + "}";
    webSocket.broadcastTXT(json);

    // Closed-loop scan speed control: compensates for spool diameter growth.
    // Sends SETHZ:<hz> to slave proportionally — runs every second.
    if (scanEnabled && !isGoToActive && currentSpeed > 0.1f) {
      float ratio = TARGET_SCAN_SPEED_CMS / currentSpeed;
      uint32_t newHz = (uint32_t)constrain((float)currentScanHz * ratio, (float)SCAN_HZ_MIN, (float)SCAN_HZ_MAX);
      if (abs((int32_t)newHz - (int32_t)currentScanHz) > 10) {
        currentScanHz = newHz;
        motorQueueTx("SETHZ:" + String(currentScanHz));
      }
    }
  }
}

void sendParamsToClients() {
  String json = "{\"type\":\"params\",\"displayZero\":" + String(displayZeroValue, 2) + 
                ",\"offset\":" + String(caliperZeroOffset, 2) +
                ",\"ppc\":" + String(getActivePpc(), 4) +
                ",\"ppcCalibrated\":" + String((calibratedPpc >= 5.0f && calibratedPpc <= 500.0f) ? "true" : "false") +
                "}";
  webSocket.broadcastTXT(json);
}

float readCaliperDisplay() {
  readCaliper();
  return lineDiameter;
}

// -----------------------------
void loop() {
  server.handleClient();
  webSocket.loop();

  pumpCaliper();       // keep rolling buffer fresh — non-blocking, must run every iteration
  motorPumpRx();
  motorPollIfNeeded();
  motorPumpTx();
  checkGoToStatus();

  calculateSpeed();

  // FW-09: single consistent snapshot of hardware encoder for this iteration
  long encSnap = getEncoderValue();

  // Arm the encoder watchdog only while motor motion is expected; idle time after boot
  // must not cause an immediate STOP when the first remote motion command arrives.
  if (motorWatchdogArmed && !isGoToActive) {
    unsigned long now = millis();
    if (encSnap != encoderLastValueForWatchdog) {
      encoderLastValueForWatchdog = encSnap;
      encoderLastMoveMs = now;
      encoderWatchdogStopSent = false;
    } else if (!isGoToActive && !encoderWatchdogStopSent && encoderLastMoveMs > 0 && (now - encoderLastMoveMs >= 5000)) {
      // FW-10: watchdog suppressed during GOTOPOS (slow final approach looks like no movement)
      motorQueueTx("STOP");
      encoderWatchdogStopSent = true;
      motorWatchdogArmed = false;
      Serial.println("Watchdog: encoder fermo da 5s, motore STOP");
    }
  }

  int currentCm = (int)(encSnap / getActivePpc()) - 2;

  // Acquisizione dati solo se scansione abilitata e NON in GOTOPOS
  if (!isGoToActive && currentCm != lastCm && currentCm >= 0 && scanEnabled) {
    lastCm = currentCm;

    float displayValue = readCaliperBufferedMedian();

    float compensatedDiameter = displayValue - displayZeroValue - caliperZeroOffset;
    compensatedDiameter = roundf(compensatedDiameter * 100.0f) / 100.0f;  // 0.01 mm precision
    // Guard: NaN/Inf in JSON silently breaks JSON.parse in the browser
    if (!isfinite(compensatedDiameter)) compensatedDiameter = 0.0f;
    if (!isfinite(displayValue))        displayValue        = 0.0f;

    // Use encoder position directly: PCNT is hardware-accurate (0.28% error),
    // and using currentCm avoids phantom counts from line oscillation/bounce.
    int actualCm = currentCm;

    addDataPoint(actualCm, currentCm, compensatedDiameter, displayValue);

    String json = "{\"cm\":" + String(actualCm) + ",\"diameter\":" + String(compensatedDiameter, 2) + 
                  ",\"rawDisplay\":" + String(displayValue, 2) + ",\"totalPoints\":" + String(getTotalDataPoints()) + "}";
    webSocket.broadcastTXT(json);

    Serial.print(actualCm);
    Serial.print(",");
    Serial.print(compensatedDiameter, 2);
    Serial.print(",");
    Serial.println(displayValue, 2);
  } else if (isGoToActive) {
    float floatCm = (float)encSnap / getActivePpc() - 2.0f;

    // Safety-only overshoot guard: if encoder went MORE than 1 cm past target, force stop.
    // Under normal operation the slave's natural deceleration stops the motor before this fires.
    if (!goToEncoderReached && (goToFwd ? (floatCm > goToTargetEncoderCm + 1.0f) : (floatCm < goToTargetEncoderCm - 1.0f))) {
      goToEncoderReached = true;
      motorQueueTx("STOP");
      Serial.println("⚠ GOTOPOS: overshoot safety stop");
    }

    // Stream encoder position to slave every 100 ms so slave uses encoder
    // (not its own step counter) for dynamic speed and stop detection
    {
      unsigned long nowMs = millis();
      if (nowMs - lastPosSentMs >= 100) {
        lastPosSentMs = nowMs;
        motorQueueTx("POS:" + String(encSnap));
      }
    }

    // Aggiorna solo la posizione durante GOTOPOS
    if (currentCm != lastCm) {
      lastCm = currentCm;
      String json = "{\"cm\":" + String(currentCm) + "}";
      webSocket.broadcastTXT(json);
    }
  }

  if (Serial.available()) {
    String cmd = Serial.readStringUntil('\n');
    cmd.trim();
    handleCommand(cmd);
  }
}

// -----------------------------
// readCaliper() is now non-blocking: it just copies the latest ISR-decoded
// value into lineDiameter. If no fresh packet has arrived since the last
// call, lineDiameter keeps its previous value (correct — caliper unchanged).
float readCaliperAverage(int samples) {
  float sum = 0;
  int got = 0;
  unsigned long deadline = millis() + 2000;
  while (got < samples && millis() < deadline) {
    noInterrupts();
    bool rdy = calDataReady;
    interrupts();
    if (rdy) {
      readCaliper();
      sum += lineDiameter;
      got++;
    }
    delay(1);
  }
  return got > 0 ? sum / got : lineDiameter;
}

// Collects up to `samples` caliper readings and returns the median.
// Rejects outlier spikes better than a mean — ideal for mechanical noise.
// At 13 Hz caliper rate, 5 samples ≈ 385 ms; at 2 cm/s scan speed smear = 4×77ms×2 = 6mm.
// 5 samples also averages over stepper cogging vibration better than 3.
float readCaliperMedian(int samples) {
  if (samples < 1) samples = 1;
  if (samples > 9) samples = 9;  // cap to avoid stack growth
  float vals[9];
  int got = 0;
  unsigned long deadline = millis() + 2000;
  while (got < samples && millis() < deadline) {
    noInterrupts();
    bool rdy = calDataReady;
    interrupts();
    if (rdy) {
      readCaliper();
      vals[got++] = lineDiameter;
    }
    delay(1);
  }
  if (got == 0) return lineDiameter;
  if (got == 1) return vals[0];
  // Insertion sort (tiny array — fast and stack-friendly)
  for (int i = 1; i < got; i++) {
    float key = vals[i];
    int j = i - 1;
    while (j >= 0 && vals[j] > key) { vals[j + 1] = vals[j]; j--; }
    vals[j + 1] = key;
  }
  return vals[got / 2];
}

void readCaliper() {
  noInterrupts();
  if (calDataReady) {
    float raw = (float)(calRawValue * calSign) / 200.0f;  // protocol LSB = 0.005 mm
    lineDiameter = roundf(raw * 100.0f) / 100.0f;         // round to caliper precision: 0.01 mm
    calDataReady = false;
    calRollingBuf[calRollingIdx % CAL_BUF_SIZE] = lineDiameter;
    calRollingIdx++;
    if (calRollingCount < CAL_BUF_SIZE) calRollingCount++;
  }
  interrupts();
}

// Non-blocking caliper pump — call every main loop iteration to keep rolling buffer fresh.
void pumpCaliper() {
  noInterrupts();
  bool rdy = calDataReady;
  interrupts();
  if (rdy) readCaliper();
}

// Returns median of the rolling buffer — instant, no blocking.
// Buffer holds the last CAL_BUF_SIZE readings collected continuously at ~13 Hz.
float readCaliperBufferedMedian() {
  if (calRollingCount == 0) return lineDiameter;
  float tmp[CAL_BUF_SIZE];
  int n = calRollingCount;
  // Copy from circular buffer in chronological order
  for (int i = 0; i < n; i++)
    tmp[i] = calRollingBuf[(calRollingIdx - n + i + CAL_BUF_SIZE * 2) % CAL_BUF_SIZE];
  // Insertion sort
  for (int i = 1; i < n; i++) {
    float key = tmp[i]; int j = i - 1;
    while (j >= 0 && tmp[j] > key) { tmp[j + 1] = tmp[j]; j--; }
    tmp[j + 1] = key;
  }
  return tmp[n / 2];
}

// -----------------------------
// RB2: messaggio di testo verso Serial + web UI
void sendDiag(const String& s) {
  Serial.println(s);
  String e = s; e.replace("\\", "/"); e.replace("\"", "'");
  String json = "{\"type\":\"diag\",\"text\":\"" + e + "\"}";
  webSocket.broadcastTXT(json);
}

// RB2: diagnosi calibro, misura 1 s
void calDiag() {
  noInterrupts();
  unsigned long e0 = calDiagEdges, g0 = calDiagGaps, p0 = calDiagPackets;
  interrupts();
  unsigned long hiClk = 0, hiDat = 0, n = 0;
  unsigned long t0 = millis();
  while (millis() - t0 < 1000) {
    if (digitalRead(CALIPER_CLOCK_PIN)) hiClk++;
    if (digitalRead(CALIPER_DATA_PIN))  hiDat++;
    n++;
    if ((n & 1023) == 0) yield();
  }
  noInterrupts();
  unsigned long e1 = calDiagEdges, g1 = calDiagGaps, p1 = calDiagPackets;
  int lb = calDiagLastBits;
  interrupts();
  String s = "CALDIAG 1s: fronti CLK=" + String(e1 - e0) + " pause=" + String(g1 - g0) +
             " pacchetti=" + String(p1 - p0) + " bit/ultimo=" + String(lb) +
             " | CLK alto " + String(n ? (hiClk * 100UL / n) : 0) + "%" +
             " DATA alto " + String(n ? (hiDat * 100UL / n) : 0) + "%" +
             " | display=" + String(lineDiameter, 2);
  sendDiag(s);
}

void handleCommand(String cmd) {
  if (cmd == "caldiag") { calDiag(); return; }
  if (cmd.startsWith("goto ")) {
    float target = cmd.substring(5).toFloat();
    goToPosition(target);
    return;
  }

  if (cmd.startsWith("motor")) {
    String arg = cmd;
    arg.replace("motor", "");
    arg.trim();
    arg.toLowerCase();
    if (arg == "scan") { currentScanHz = SCAN_HZ_INIT; armMotorWatchdog(); motorQueueTx("SCAN"); }
    else if (arg == "stop") { motorWatchdogArmed = false; motorQueueTx("STOP"); }
    else if (arg == "fast_s") { armMotorWatchdog(); motorQueueTx("FAST_S"); }
    else if (arg == "fast_o") { armMotorWatchdog(); motorQueueTx("FAST_O"); }
    else motorQueueTx("STATUS?");
    return;
  }

  if (cmd == "help") {
    Serial.println("Comandi disponibili:");
    Serial.println("  reset               - Azzera lunghezza encoder e dati");
    Serial.println("  resetpos            - Azzera solo posizione (non i dati)");
    Serial.println("  calibrate:<cm>      - Calibra PPC: dopo resetpos, estrai <cm> di linea, poi invia questo comando");
    Serial.println("  setppc:<val>        - Imposta PPC manualmente (es: setppc:31.25) e salva in EEPROM");
    Serial.println("  calibrate_reset     - Ripristina PPC alla formula (cancella calibrazione)");
    Serial.println("  goto <cm>           - Vai alla posizione specificata in cm");
    Serial.println("  setoffset <val>     - Imposta offset di compensazione");
    Serial.println("  setdisplayzero      - Imposta display corrente come zero");
    Serial.println("  readraw             - Mostra lettura grezza del calibro");
    Serial.println("  caldiag             - Diagnosi calibro (fronti, pacchetti, livelli) in 1 s");
    Serial.println("  readenc             - Mostra tick PCNT, pcntAccum e posizione calcolata (debug)");
    Serial.println("  resetoffset         - Azzera offset a 0");
    Serial.println("  getparams           - Mostra parametri correnti");
    Serial.println("  debugdata           - Mostra statistiche dati");
    Serial.println("  resetwifi           - Reset WiFi");
    Serial.println("  scan_on / scan_off  - Abilita/disabilita ricezione punti");
    Serial.println("  motor scan|stop|fast_s|fast_o|status");
    return;
  }

  if (cmd.startsWith("setoffset ")) {
    caliperZeroOffset = cmd.substring(10).toFloat();
    EEPROM.put(0, caliperZeroOffset);
    EEPROM.commit();
    Serial.print("Offset impostato a: ");
    Serial.println(caliperZeroOffset, 6);
    sendParamsToClients();
    return;
  }

  if (cmd == "setdisplayzero") {
    setDisplayZero();
    return;
  }

  if (cmd == "scan_on") {
    if (!isGoToActive) {
      scanEnabled = true;
      String json = "{\"type\":\"scan_enabled\",\"value\":true}";
      webSocket.broadcastTXT(json);
      Serial.println("Scansione ABILITATA");
    } else {
      Serial.println("Impossibile abilitare scansione durante GOTOPOS");
    }
    return;
  }

  if (cmd == "scan_off") {
    scanEnabled = false;
    String json = "{\"type\":\"scan_enabled\",\"value\":false}";
    webSocket.broadcastTXT(json);
    Serial.println("Scansione DISABILITATA");
    return;
  }

  if (cmd == "reset") {
    // Set encoder so caliper position reads 0: display = encoder/activePpc - 2 = 0
    // → encoder must be ceil(2 * activePpc) so integer division gives exactly 2
    setEncoderValue((long)ceilf(2.0f * getActivePpc()));
    lastCm = -1;
    clearAllData();
    Serial.println("Lunghezza azzerata e dati resettati.");
    return;
  }

  if (cmd == "resetpos") {
    // Reset only the encoder position (display → 0); does NOT clear measurement data.
    setEncoderValue((long)ceilf(2.0f * getActivePpc()));
    calStartEncoder = getEncoderValue();  // mark baseline for next calibration run
    lastCm = -1;
    actualPositionCm = 0.0f;
    Serial.println("Posizione azzerata.");
    sendParamsToClients();
    return;
  }

  if (cmd == "readraw") {
    float display = readCaliperDisplay();
    sendDiag("Display calibro: " + String(display, 2));
    return;
  }

  if (cmd == "readenc") {
    long enc = getEncoderValue();
    float cm = (float)enc / getActivePpc() - 2.0f;
    int16_t hwCount = 0;
    pcnt_get_counter_value(PCNT_ENC_UNIT, &hwCount);
    Serial.print("Encoder ticks totali: "); Serial.println(enc);
    Serial.print("  pcntAccum: ");          Serial.println(pcntAccum);
    Serial.print("  PCNT HW counter: ");    Serial.println(hwCount);
    Serial.print("  PPC attivo: ");         Serial.println(getActivePpc(), 4);
    Serial.print("  Posizione calcolata: "); Serial.print(cm, 2); Serial.println(" cm");
    return;
  }

  // calibrate:<cm>  — compute actual PPC from encoder delta since last resetpos.
  // Workflow: (1) send resetpos, (2) pull EXACTLY <cm> of line, (3) send calibrate:<cm>.
  // Stores result in EEPROM; survives reboot. Formula value used until first calibration.
  if (cmd.startsWith("calibrate:")) {
    float knownCm = cmd.substring(10).toFloat();
    if (knownCm < 1.0f) {
      Serial.println("calibrate: lunghezza troppo piccola (minimo 1 cm)");
      return;
    }
    long delta = getEncoderValue() - calStartEncoder;
    if (delta <= 0) {
      Serial.println("calibrate: encoder non avanzato. Premi resetpos prima di estrarre la linea.");
      return;
    }
    calibratedPpc = (float)delta / knownCm;
    EEPROM.put(EEPROM_ADDR_CALIB_PPC, calibratedPpc);
    EEPROM.commit();
    Serial.print("PPC calibrato: ");
    Serial.print(calibratedPpc, 4);
    Serial.print(" (delta=");
    Serial.print(delta);
    Serial.print(" ticks / ");
    Serial.print(knownCm, 1);
    Serial.println(" cm)");
    sendParamsToClients();
    return;
  }

  // setppc:<value>  — manually set PPC and save to EEPROM (e.g. setppc:31.25)
  if (cmd.startsWith("setppc:")) {
    float val = cmd.substring(7).toFloat();
    if (val < 5.0f || val > 500.0f) {
      Serial.println("setppc: valore fuori range (5–500)");
      return;
    }
    calibratedPpc = val;
    EEPROM.put(EEPROM_ADDR_CALIB_PPC, calibratedPpc);
    EEPROM.commit();
    Serial.print("PPC impostato manualmente: ");
    Serial.println(calibratedPpc, 4);
    sendParamsToClients();
    return;
  }

  if (cmd == "calibrate_reset") {
    calibratedPpc = 0.0f;
    EEPROM.put(EEPROM_ADDR_CALIB_PPC, calibratedPpc);
    EEPROM.commit();
    Serial.print("PPC resettato alla formula: ");
    Serial.println(getActivePpc(), 4);
    sendParamsToClients();
    return;
  }

  if (cmd == "resetoffset") {
    caliperZeroOffset = 0.0;
    EEPROM.put(0, caliperZeroOffset);
    EEPROM.commit();
    Serial.println("Offset azzerato.");
    sendParamsToClients();
    return;
  }

  if (cmd == "getparams") {
    Serial.print("Parametri correnti - Zero Display: ");
    Serial.print(displayZeroValue, 2);
    Serial.print(" mm, Offset: ");
    Serial.println(caliperZeroOffset, 6);
    return;
  }

  if (cmd == "debugdata") {
    Serial.print("Punti dati totali: ");
    Serial.println(getTotalDataPoints());
    return;
  }

  if (cmd == "resetwifi") {
    Serial.println("Reset WiFi...");
    wifiManager.resetSettings();
    delay(1000);
    ESP.restart();
    return;
  }
}

// -----------------------------
void setDisplayZero() {
  displayZeroValue = readCaliperDisplay();
  Serial.print("Zero display impostato a: ");
  Serial.println(displayZeroValue, 2);
  sendParamsToClients();
}
