stefanodemartini/RazorGauge/(commit log)

2026-09-15 Add FlyLinePhysics: Level-2 mass/drag/stability analysis engine + CLI analyze command
    New FlyLinePhysics class library (referenced by the WPF app, added to app.sln):
    mass-per-length and cumulative mass, Reynolds number, Hoerner-style normal/tangential
    drag (Ekander/Perkins/Richards 2024, eq. 5-6 — reference papers saved under
    FlyLinePhysics/docs/references/), momentum-to-drag ratio (Pi) and continuity index (C),
    and a first-pass 0-100 per-segment score. Own .flp model/serializer (FlyLinePhysics
    can't depend on DiametroLineaDesktop.Models without a reference cycle), including new
    optional CoreDiameterMm/CoreDensityGCm3 fields for a future two-material core+coating
    mass model. 21 unit tests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
2026-09-18 Fix segment/node table edits and keep the node grid in sync with zone-adapted diameters
    Segments grid: column indices in the cell-edit handler had drifted after Length/Volume/Mass were
    inserted, so Start Ø/End Ø edits did nothing and a typed Length was applied as a diameter. The
    node grid is now resynced after such edits.
    Node grid: a single SyncNodeTableData() decides between drawn and produced (zone-adapted)
    diameters, so the grid matches the chart after any edit, not only on load. Zone Start/End cell
    edits are read from the editing TextBox so the chart no longer lags one edit behind.
2026-09-18 Add Prototype window: assemble test lines from scanned pieces
    A separate window (toolbar "Prototype…") builds a throw-away prototype out of real pieces of fly
    line that have been scanned: pick pieces from a library folder (every .flp with a scan, set in
    Settings > Prototipi), lay them on the chart, slide them over each other to compare diameters,
    trim either end, flip 180°, split into parts, and give each piece/part its own colour. Where to
    cut is the user's call: the window shows Ø under the cursor, the step at each joint, and offers
    "Cut both here" at a chosen point. Optional dashed outline of each piece's original shape.
    The cut list is in bench terms (scan-start / scan-end ends of e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
2026-09-19 Rewrite the prototype cut list as a bench sheet
    The cut list now follows the order of work at the bench:
    1. CUTTING: one block per physical piece (split parts grouped under it), read like a ruler from
    the piece's marked end. Every stretch is either discarded or goes to a numbered position in
    the line; splice allowance included, and problems (overlapping parts, too little line for a
    splice) flagged right under the affected row.
    2. ASSEMBLY: tip to back, which way the marked end faces, and a splice row between pieces with
    both diameters and the step.
    3. FINISHED LINE: length, pieces, splices, mass.
    Also widens the cut list panel and the "In line (cm)" column. MANUALE §13 updated.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
2026-09-28 Rework Level-2 analysis around rho*d and the per-segment taper rate
    Pi reduces to 1.31*rho*d*a/v^2 within ~5% across the whole range a fly line
    lives in (d 0.4-2.0 mm, v 15-35 m/s): the Reynolds-dependent part of the
    normal drag is only 2-11% of the total. So velocity and acceleration are pure
    scale factors on Pi's level, never on its shape along s, and since castability
    and turnover depend on the shape, rho*d carries the design information without
    needing either. Diameter and density trade 1:1.
    A shooting head is only half a system. Its profile stops at the back taper and
    what it tows is a monofilament the file never mentions, while a full line
    carries its running line inside the profile -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
2026-09-28 Document DiameterForTargetSinkSpeedMm as unused, and why
    Nothing calls it. It was written for a version of the compensation quantisation
    step that was abandoned, but its comment still described that step as if it were
    live, and the line-physics skill listed it under "used for: solving diameter for
    a target speed" - the first thing read when touching this area, and misleading.
    Two things killed the approach it served. The material assignment jumps
    discretely at a boundary while the ideal density is continuous, so correcting
    the diameter per slice snapped to a different value on each side: a visible step,
    and a diameter discontinuity is never acceptable. And the diameters it asks for
    are most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
2026-09-28 Change the density and watch the diameters follow; generic note box
    Three app changes from one thread: what happens when the material changes.
    Live rescale. Typing a new density in the material panel now offers to adjust
    every diameter by sqrt(rho_old/rho_new) so the line keeps the mass it has - the
    same constant for all of them, so mass is held at every x, not merely on average.
    The sink speed is recomputed from the geometry that comes out and reported in the
    status bar, because that is the consequence worth seeing. Previously nothing
    moved: MaybeApplyZoneDensityChange returns early unless a zone differs from M1,
    and M1 itself is not editable in the nozzle grid, so the line's own density
    c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
2026-10-14 Pick the core from the supplier's catalogue, draw it, print it
    The supplier quotes a diameter range, not a figure, so both ends are kept and the
    picker shows the range beside the nominal it fills in - the tolerance should not
    vanish behind one number. Polyester 12 to 35 lb and Kevlar 60/80, with the old
    generic descriptions kept after them: a project naming one still opens and still
    prints, it just draws no core, because a core with no known diameter gets no
    invented one.
    Two of the supplier's entries are not ranges and must not print as if they were.
    Polyester 35 lb was quoted as a single figure, 1.15, while Kevlar was quoted only
    as "above 0.90" for both strains - a floor and no figure at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
2026-10-14 Show the device's active pulses-per-cm, and whether it is calibrated
    That number scales every length the app records, and until now nothing on screen
    said what it was. The device had a calibrated 30.21 in EEPROM against the wheel
    formula's 30.00 - a 0.7% shift on every measurement, invisible where the work
    happens. It cost two wrong diagnoses of a length discrepancy before the device's
    own web page gave it up; the app was already receiving it over WebSocket and
    discarding it.
    "calibrato" is highlighted because that is the case where the value is not the
    one the wheel implies, so a stale or borrowed calibration is visible rather than
    inferred. It also reaches the log line, which is where a p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
2026-10-14 Add Reset Posizione: zero the length without clearing the scan
    The app could only send the destructive reset, which zeroes the position and
    throws the scan away with it. The device has had a position-only "resetpos" all
    along; nothing in the app could reach it, so the one action a measured run needs
    beforehand was available only on the device's own web page.
    It needs doing before every measured run, because the position is what the run is
    referenced to: start from a position left over from earlier and the result is
    short by exactly that leftover, with nothing on screen to say so. That is what a
    100 cm run reading 98 turned out to be - the same rig over 1000 cm reads 1000.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
2026-10-14 Keep the UI in English: the strings added today were Italian
    The window, its labels and its tooltips are English throughout; the Reset button,
    the PPC card and the analyze command's archive column were not, so they read as
    leftovers from a different product. The CLI help was already English while the
    band it printed beside each segment was not.
    Only user-facing text moved. Status-bar and log lines that were already Italian
    before today are left as they are: making those consistent is a separate decision
    about which language the app speaks, not a cleanup of one session's additions.
2026-10-19 Bring in the firmware actually running: master 0.4.22-RB2, slave 0.6.1
    The repo held a master two days older than the running one and a slave built for
    an ESP32-S3 the hardware no longer is. Three copies of master.ino existed on the
    machine with three different contents and none under version control, so reading
    "the firmware" meant picking one and hoping; the stale repo copy is what I read
    for days while diagnosing a length discrepancy.
    master 0.4.22-RB2 is the caliper build and is the correct one until the laser
    gauge lands. A 0.6.0 exists that replaces the caliper with the RazorGauge optical
    shadow gauge and drops the web UI, but it is preliminary and not what runs.
    slave 0.6.1 is the p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
    [master.ino, slave.ino]
2026-10-19 Point CONTEXT.md at RazorGauge, where the hardware decisions live
    The mechanics, board, optics and CAD are in a separate project worked on from a
    different session, and its STATO_PROGETTO.md already holds decisions this repo
    cannot derive and in places contradicts. Nothing here said so, so this repo read
    as self-contained when it is half a system.
    Two of those decisions were rediscovered the slow way this week. Tangent contact
    with a pinch roller means there is no length correction by diameter - the dead
    actualPositionCm accumulator and its comment about C_eff = 20 - pi*d/10 are the
    remains of an approach that never applied here. And the caliper reads 7-8% under
    the real diameter because th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
2026-10-19 One home for the firmware: all of it here, no copies elsewhere
    Three copies of master.ino with three different contents existed across this repo
    and the RazorGauge project, none of the others under version control, and the
    stale one is what got read for days while diagnosing a length error. Pointers
    were added first, but a pointer only works if someone remembers to follow it; the
    duplication itself is the defect.
    So the firmware moves here entire, including the parts this repo never held: the
    0.6.0 master that replaces the caliper with the optical gauge, and the two gauge
    sensor sketches. Folder names carry the distinction that mattered and kept being
    lost - master is the caliper build that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
    [gauge_esp32.ino, master_razorgauge.ino]
2026-10-19 Spell out the RX state, and warn when a scan starts away from zero
    Receiving off stops the recording but never the encoder: the position keeps
    advancing, so line fed through with RX off is already in the count and a scan
    enabled afterwards starts from there, every point carrying that head start. It
    reads as a measurement error and is not - it is what a 100 cm run reading 98
    turned out to be. The behaviour is right, since it is what lets a scan be paused
    and resumed, so what was missing was seeing it.
    The state was readable only from which of the two buttons was greyed; now a badge
    spells it out, and enabling reception says where the scan will start from rather
    than leaving it to be noticed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
2026-10-19 Say what the gauge sketches are: bench test firmware, not a component
    Calling them "sensore ottico" implied something separate from the laser, when
    they are the laser gauge - and implied they run in the finished system, when they
    do not. They are bench firmware: same pins as the master, flashed to try the
    measuring head before the real master goes on, driven from the serial line rather
    than WebSocket. In production it is 0.6.0 that reads the sensor.
    The label came from the folder name without opening the file, which is the same
    shortcut that had the wrong master.ino read for days.
2026-10-19 The laser firmware is 1.0.0-alpha, not 0.6.0
    Replacing the caliper with the optical gauge changes the measuring principle and
    the hardware, and the two builds are not interchangeable: it is a major by any
    reading, and it was numbered as a minor.
    Numbered in sequence it also said the wrong thing. 0.6.0 sitting beside 0.4.22
    reads as "newer, therefore the one to use", while 0.4.22-RB2 is what runs and
    0.6.0 has never been on the bench. Putting the laser on its own major separates
    the two eras instead of queueing them - 0.x is the caliper, 1.x is the laser -
    and the gap between the numbers says they are different things rather than
    different ages.
    -alpha because it compiles and has not been t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
    [master_razorgauge.ino]
2026-10-19 Un repo solo: il progetto hardware entra sotto hardware/
    Due repository per un progetto solo significavano due storie da tenere
    allineate a mano, puntatori incrociati da mantenere, e il disallineamento che si
    e gia pagato: tre copie di master.ino con contenuti diversi e la versione
    sbagliata letta per giorni mentre si diagnosticava un errore di misura.
    Entra tutto: CAD, STL sorgenti, i due progetti KiCad, la piastra, l'integrazione,
    gli script di generazione e verifica, e STATO_PROGETTO.md - che resta la fonte
    autorevole su com'e fatto il banco, ora pero nello stesso albero del software che
    lo legge.
    Il .gitignore dell'hardware e fuso in quello del repo con i percorsi corretti: si
    versiona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
    [FlylineProfiler_RazorGauge.scad, FlylineProfiler_porta_rullo_guidato.scad, FlylineProfiler_senza_comparatore.scad, RazorBoard.dsn, RazorBoard.kicad_pcb, RazorBoard.kicad_sch, RazorBoard_BOM.csv, RazorBoard_SMD_BOM.csv]
2026-10-19 Il prodotto si chiama RazorGauge
    RazorGauge era il nome della sola testa ottica; d'ora in poi e il nome del
    prodotto intero - app, eseguibile, documenti. Cambia AssemblyName, Product,
    titolo della finestra, About, intestazione del PDF e tutta la documentazione.
    L'eseguibile diventa RazorGauge.exe.
    **L'estensione .flp resta**, e la decisione e scritta accanto alla costante:
    cambiarla renderebbe invisibili tutti i progetti gia salvati e romperebbe le
    associazioni di sistema, in cambio di niente. Identifica il formato, non il nome
    commerciale.
    Restano fuori dal rename i nomi interni che nessuno vede: il progetto si chiama
    ancora DiametroLineaDesktop e il namespace pure. Rinominarli tocca ogni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
2026-10-19 GitHub e RazorGauge; resta la cartella locale
    Il repository su GitHub e rinominato (il vecchio URL reindirizza) e il remoto
    locale punta gia al nuovo. La cartella no: con la cartella aperta la rinomina
    fallisce con "Device or resource busy", ed e la working directory stessa a
    tenerla, non un processo che si possa chiudere - dotnet build-server shutdown non
    cambia niente.
    RINOMINA_CARTELLA.md porta la procedura, da eseguire a VS Code chiuso, e dice
    cos'e gia pronto. In particolare la memoria di progetto: e indicizzata sul
    percorso, quindi e stata copiata in anticipo sul nome nuovo, altrimenti la prima
    sessione nella cartella rinominata ripartirebbe senza niente.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
2026-10-19 CAD e documenti alla radice, non sotto hardware/
    Annullato l'annidamento introdotto un'ora fa. Metterli sotto hardware/ era
    ordinato ma spostava i percorsi che l'altra sessione Claude usa da sempre -
    cad/, scheda/, STATO_PROGETTO.md - e l'unica ragione per cui questo riordino
    esiste e proprio che le due sessioni non si disallineino. Un livello di cartella
    in meno vale piu della simmetria.
    La destinazione cambia di conseguenza: la cartella andra in
    Documents/Claude/RazorGauge, cioe dove l'altra sessione lavora gia. Cosi dei
    suoi percorsi non cambia nulla, ne la radice ne quello che c'e sotto. Il prezzo e
    che "Claude" nomina lo strumento invece del progetto, e che il firmware esce
    dallo sketc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
    [FlylineProfiler_RazorGauge.scad, FlylineProfiler_porta_rullo_guidato.scad, FlylineProfiler_senza_comparatore.scad, RazorBoard.dsn, RazorBoard.kicad_pcb, RazorBoard.kicad_sch, RazorBoard_BOM.csv, RazorBoard_SMD_BOM.csv]
2026-10-19 Allinea progetto, firmware e stato RX
    Aggiorna la documentazione alla struttura e alle schede firmware correnti, corregge i casi limite delle metriche fisiche con test, e mostra RX OFF in rosso nell'app.
2026-10-20 Diagnostica UART: master 0.4.25-RB2, slave 0.6.7, moduli sani in loopback
    Contatori UART in /motor_diag, /diag e /rx_test sullo slave, watchdog encoder
    armato al comando di movimento. Loopback su entrambi i moduli fuori scheda:
    funzionano, il guasto UART è sulla RazorBoard (R10/R11, piste, zoccoli).
2026-10-21 Correzione scan Ø ± (mm/%), lunghezza testa, overlay tratteggiato
    - Ø ±: corregge i diametri del profilo tracciato sullo scan, in mm fissi
    (default 0.06) o in %; valori negativi diminuiscono; undoable. L'analisi
    su quattro scansioni (Phantom Hover, Extra Hover x2, Ballistic) mostra
    uno scarto quasi costante di 0.05-0.06 mm, non una percentuale.
    - Totali: lunghezza della testa = somma dei soli segmenti con flag Head,
    in cm e ft.
    - Overlay in Design Mode: contorno tratteggiato con alone, senza
    riempimento, così il design mantiene i suoi colori.
    - STATO_PROGETTO: stato UART aggiornato (funziona, causa non accertata).
2026-10-24 Prova sensore CCD senza laser: sketch ccd_test e risultati
    Sketch ccd_test/ per il solo TSL1401 su ESP32 classico (stessi pin del
    master): integrazione regolabile, profilo ASCII, dump raw, test di
    linearità. Sensore OK sui pixel 14-127; pixel 0-13 a 0 fisso da indagare.
    Lettura ~43 us/pixel.
2026-10-25 Pixel 0-13 del TSL1401 morti: esclusi nel master 1.0.1-alpha
    - master_razorgauge: G_PIX_FIRST/G_PIX_LAST, ombra, energia k, uniformita,
    picco e bordo calcolati solo sulla zona utile (16..125)
    - ccd_test: comandi z / o / p per la diagnosi dei tempi di lettura
    - PrototypeWindow: icona con percorso relativo (crash dopo il rename
    dell'assembly in RazorGauge)
    - STATO_PROGETTO: prova del 25/10 e conclusione
    [ccd_test.ino, master_razorgauge.ino]
2026-10-25 Prova LED del modulo TSL1401: ~5% del segnale nel master, da coprire
2026-10-25 Procedura: LED del modulo da coprire prima del montaggio
2026-10-26 ccd_lcd: TSL1401 con mappa dei pixel sul display dell'ESP-WROVER-KIT
    Grafico, striscia e cascata dei frame sull'ILI9341 del kit, esposizione
    automatica, ombra con bordi interpolati. Svuotamento del sensore con soli
    clock: integrazione minima da ~5.2 ms a ~0.2 ms. Provato sull'hardware.
2026-10-26 Documenta perche' la larghezza dell'ombra in ccd_lcd e' approssimativa senza laser
2026-10-27 ccd_lcd: integrazione minima 1 us e stampa dell'effettiva; prova col laser fisso attraverso L1-L2
2026-10-27 Stato banco laser 27/10: fascio ricentrato, saturo a 143 us; prossimo passo trimmer o laser pulsato
2026-10-27 Prova laser: il 28/10 con RazorBoard e master (laser pulsato via Q1)
2026-10-28 Prova 28/10: laser pulsato sulla RazorBoard, niente saturazione da 2 a 8 us; fascio da ricentrare
2026-10-28 Prova 28/10: fascio spostato oltre, bordo netto a destra, larghezza ~6.3 mm; pixel 0-13 rispondono
2026-10-28 Prova 28/10: il rumore del blu e' schema fisso + energia dell'impulso; residuo 0.16%
2026-10-28 Nota sull'instabilita' della sede laser (sezione in immagini/sede_laser_sezione.png)
2026-10-28 Sede laser: riferimento alle sezioni reali dell'STL del pezzo unico
2026-10-29 Tabella nodi bloccata dopo un progetto con zona vera; colori M1-M4 azzerati togliendo l'ultima zona
    ClearProjectState azzerava _zoneDerivedComp senza chiamare UpdateCompModeUI: aprendo un file
    senza zone vere dopo uno con zona vera, la tabella nodi restava di sola lettura, senza
    "+ Add Node" e con le colonne Comp. visibili. Ora l'interfaccia si riallinea all'azzeramento.
    UpdateCompModeUI "ripristinava" colori/etichette dei nozzle da uno snapshot preso solo dalla
    compensazione a velocita': togliendo l'ultima zona vera, M1 tornava rosso di default. Ora il
    ripristino avviene solo se lo snapshot e' stato davvero preso.
    Verificato con un harness che carica la MainWindow vera su copie del file P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
2026-10-29 Nuovo nozzle ("+ Material") parte con la densita' di M1 invece che 0
    Una zona su un nozzle a rho = 0 contava come materiale diverso e bloccava la tabella nodi
    finche' non si scriveva la densita'. Verificato con l'harness: + Material -> 1.01, Add Zone
    non blocca, il nozzle attivo e' quello appena aggiunto.
2026-10-29 Crash nella tabella segmenti all'apertura di un file (22:10, ArgumentOutOfRange in DataGridCellsPanel)
    Comparso subito dopo c5eff78, che faceva girare UpdateCompModeUI dentro ClearProjectState a ogni
    apertura: le colonne della tabella segmenti venivano reimpostate e riordinate con la tabella vuota.
    Non riprodotto nell'harness. Correzione prudente:
    - le colonne si toccano (e si riordinano) solo se la visibilita' cambia davvero;
    - il riallineamento avviene dopo il caricamento (righe gia' presenti) e in New/Close,
    non piu' dentro ClearProjectState.
    Il blocco della tabella nodi resta corretto (verificato: zona vera -> V.2 sbloccata).
2026-10-29 Hardware 28-30/10: scheda sensore, allineamento laser, profiler, piastre CNC, logo
    - scheda_sensore/: progetto KiCad RazorSensor (TSL1401CL), script di generazione, BOM/CPL/gerber JLCPCB
    - master_razorgauge/: procedura ALLINEAMENTO_LASER.md + gauge_align.inc; strumenti/allineamento_laser/
    - cad/ e strumenti/: profiler, tappo, tappo di uscita, sportello, assembly, verifica piastre CNC
    - integrazione_profiler/: verifiche mensola/slitta 28-10, sede laser 29-10, montaggio e piastre CNC 30-10
    - logo/ (+ strumenti/logo_da_pdf.py); STATO_PROGETTO.md aggiornato
    Esclusi: master_razorgauge/build/ (compilati firmware) e immagini/ (83 MB, binari).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
    [FlylineProfiler_RazorGauge.scad, RazorGauge.scad, RazorSensor.kicad_pcb, RazorSensor.kicad_sch, RazorSensor_BOM.csv, RazorSensor_BOM_JLCPCB.csv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]
2026-10-29 Tolto RINOMINA_CARTELLA.md: lo spostamento in Documents/Claude/RazorGauge e' concluso
    Unica cartella di progetto per tutte le sessioni (VS Code e app desktop). La procedura resta
    nella storia git.
2026-11-03 Temperatura acqua: Enter conferma il valore; zone e file C ricalcolano la velocita' al cambio d'acqua
2026-11-03 File C: zone ricostruite dai materiali reali, densita' ugelli a 3 decimali
    Il file C ereditava le zone del progetto NC: grafico e tag M{n} colorano per
    zona, quindi una zona NC stantia dipingeva il materiale sbagliato e la linea
    mostrava 2 colori contro 4 ugelli. Densita' a 2 decimali rendevano due ugelli
    uguali (1.015 e 1.021 -> 1.02).
2026-11-03 File C: quote anche ai cambi di materiale; k-means non fonde piu' due materiali
    Centri iniziali del k-means sull'intervallo dei valori invece che sui quantili:
    con un materiale su oltre meta' linea due centri coincidevano e 1.018+1.025
    diventavano un 1.02 inesistente (PDF e, potenzialmente, la compensazione).
2026-11-03 Compensazione: transizione lineare di 30 cm fra un ugello e l'altro
    Rampa di densita' centrata su ogni cambio di materiale (max meta' di ogni
    tratto vicino), diametro invariato. Grafico sfumato, quote e Ø ai bordi della
    rampa, una riga di tabella e una fascia PDF per transizione. Ugelli del C a
    precisione piena per distinguere materiale da transizione. Anche: la CLI non
    sovrascrive piu' la densita' di un file C con quella della zona; le fasce
    Density zones del PDF vanno a capo.
2026-11-03 Foglio di progetto: forma, ugello e colore separati (PDF in inglese)
    Profilo nel solo colore vero; fasce TAPER / NOZZLE-DENSITY / COLOR sotto il
    grafico (schermo e PDF), confini taper continui e ugelli tratteggiati, ugelli
    distinti da grigio + tratteggio fitto. PDF: riepilogo, legenda, schede ugello,
    tabelle TAPER e NOZZLES. Gli ugelli del C prendono il colore di M1 (4 ugelli =
    4 densita' => colore unico); Compensate avvisa per zone di solo colore.
    Corretti: massa/testa del PDF C dell'app calcolate da righe raggruppate
    (825/825 gr invece di 682.5/925.3); diametri di bordo estrapolati nelle
    compensazioni a due punti (Ø 1.58 invece di 1.40); legenda 'Comp. 1.00 in/s'
    su un C caricato.
    Co-Au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
2026-11-03 Nomi dei taper automatici rinumerati per posizione: niente buchi ne' doppioni
    Il nome era legato all'X di partenza: inserire un nodo lasciava S6/S9 mancanti
    e due S10, e nel file C il cambio di pendenza fra i due S10 spariva. I nomi
    S{n} seguono ora la posizione; i nomi scritti a mano restano; i C no.
2026-11-03 Profilo compensato: un'unica campitura per tratto di colore, niente righe fra le slice
    Ogni slice da 1 cm era 21 strati semitrasparenti sovrapposti ai vicini: dove si
    sommavano compariva una riga scura (e ~84k poligoni per un file C). Ora una sola
    campitura per tratto dello stesso colore, a schermo e nel PDF.
2026-11-03 File C aperto: la tabella ricalcola la velocita' quando cambia l'acqua
    Le righe raggruppate di un file C erano costruite a parte e non venivano
    ricostruite al cambio di temperatura o di acqua salata.
2026-11-03 PDF in cinese: English / 中文 / English + 中文 scelto nel Salva
    Testi fissi del foglio in SheetText (chiave = testo inglese; mancante ->
    inglese), Microsoft YaHei come font di riserva per i caratteri cinesi nel PDF
    e nel grafico. Lingua ricordata nelle impostazioni; CLI: --lang en|zh|en+zh.
    L'app resta in inglese.
